Scaxlibur/CycleScope/tool-of-rei/screenshots/README.md

# 截图与相机调试材料

本目录保存历史 UI 调试素材，不是最终显示验收的主证据。像素文件和相机帧保持本机忽略；本 README 用于说明它们的用途和边界。

| 材料 | 用途 | 状态 |
|---|---|---|
| 20260731T151504Z-seq00000001-boot-stale/ | LVGL 截图调试，包含 RGB565、PNG 和 metadata。 | 历史 stale 诊断。 |
| 20260731T151556Z-seq00000002-repeat/ | 同一调试路径的重复截图。 | 历史重复采集；PNG 与上一张哈希相同，不能当成两次独立视觉通过。 |
| camera/20260731T154429Z-camera-raw.png | 相机采集的可读帧。 | 辅助调试材料，不替代 panel flush 计时。 |
| camera/20260731T154353Z-camera-raw.png | 0 字节文件。 | 失败产物，保留以解释采集历史，不得展示为证据。 |

如需新增截图，必须额外记录固件身份、采集方式、原始像素哈希和时间；若用于验收，还应包含从按键事件到真实 panel flush 的端到端取证。仅有 TCP 截图或相机静帧不足以证明该时序。
