Scaxlibur/CycleScope/docs/验收证据索引.md

# CycleScope 验收证据索引

> 更新：2026-08-02
> 作用：为合并、答辩和后续复现提供一份可追溯目录；不复制或改写任何已哈希的原始证据。

> FPGA 原始档案已原样复制到当前仓库根的 `tool-of-rei/evidence/` 和 `source_data_for_test/` 忽略归档区；完成合并后，旧 `CycleScope-FPGA` 工作树已按用户授权移除。FPGA 专用入口见 [FPGA验收证据索引.md](FPGA验收证据索引.md)。

## 1. 使用规则

1. 本文件和 [测试与证据索引.md](测试与证据索引.md) 是受版本控制的导航入口；原始 `pcap`、`npy`、S16 帧、仪器导出和构建二进制留在 `tool-of-rei/evidence/` 的忽略档案中。
2. 已完成的证据根不能改名、移动或编辑；需要补充说明时，只在本索引、根 README 或新的独立包中增加材料。
3. 每次离线备份必须保留目录层级、根 `SHA256SUMS` 和本索引。进入一个证据根后执行 `sha256sum -c SHA256SUMS`；没有清单的历史包只能作为辅助材料。
4. “PASS”只表示该包声明并通过的范围，不自动覆盖另一校准身份或未复验的源码。FPGA 的唯一最终基线为 `fpga-v1.0.0@038e981`。

## 2. 当前正式主证据

| 证据根 | 范围与结论 | 首选入口 |
|---|---|---|
| `final-calibration-20260801_145546+0800/` | M2/M3/M4/M6 的真实前端校准；`fit-v2` 和独立 `holdout-v2` 冻结 P4 频响资产。身份为 `25030/516/-6761/Profile1/4.0625 MS/s/8192`，7 点 holdout 通过，最大幅值/频率误差为 `0.320542 mV / 234.985 Hz`。 | `fit-v2/calibration-build-manifest.json`、`holdout-v2/holdout-report.json`、`p4-asset-v2/p4-asset-manifest.json`、`SHA256SUMS` |
| `final-p4-release-audit-20260801_190121+0800/` | 最终 M8/M9 合并审计，`pass=true`、20/20。审计绑定 P4 频响 profile `C5DCDE41`，并对 M8 严格复分析、干扰对和 WDT A/B 作汇总。 | `combined-audit.json`、`SHA256SUMS` |
| `final-p4-m8m9-fixed-20260801_184849+0800/` | 审计所引用的 11 例基础/边界实机原始包，含 source restore、WaveBench、P4 与镜像数据。 | `campaign-summary.json`、`campaign-manifest.json`、`SHA256SUMS` |
| `final-p4-wdt-recheck-20260801_184750+0800/` | 三谱线计算让出 CPU 后的实机复查；被最终审计引用。 | `campaign-summary.json`、`SHA256SUMS` |
| `m12-final-completion-audit.json` | DG4202 → FPGA → LAN → P4 的真实输入矩阵与其引用的掩码、阶次、相位、`u_a/u_b`、干扰和镜像子包。总审计通过，但必须连同所引用的 `m12-live-*` 目录一起备份。 | `m12-final-completion-audit.json` 及其引用的子包 |

上述 P4 最终审计的应用 BIN 为 `d819641d…d8207007`。它是“完整 20 例”的正式构建身份；不要把它与后续只修改 F0 显示格式的构建混写。

## 3. 最新 P4 显示构建：独立归档、范围受限

`final-p4-f0-display-20260801_192900+0800/` 保存当前工作树 F0 两位小数显示构建：

- ELF：`e23e0ca9…a416d946`；BIN：`e30d16c4…a4bac0e`；应用大小 `1,134,960` byte；
- 启动日志确认 ESP32-P4 rev1.0、360 MHz、P4 response `ON/C5DCDE41`、`.3 → .2` 会话、首帧与 100 帧运行；
- 它证明的是该显示构建的构建身份和板上启动/链路烟测，**不替代**上一节 BIN 的 20 例完整审计；
- 合并当前源码后，若要将它提升为最终发布身份，必须在该提交上重建并完成至少同等范围的审计，或在发布说明中明确保留“20例审计绑定旧 BIN”的边界。

## 4. FPGA 侧正式证据（本地归档）

FPGA 原始档案在 `tool-of-rei/evidence/`，详细说明见本仓的 [FPGA 验收证据索引](FPGA验收证据索引.md)。

| 证据根 | 已验证范围 | 使用边界 |
|---|---|---|
| `m8-lan-longrun-20260731` | 10,001 帧真实 ADC LAN 长稳、UDP checksum、零 IP 分片。 | 固定 8192 点 LAN 基线。 |
| `m10-lan-selftest-20260731` | 正式 bit/ELF 身份、时序、DMA、故障注入和真实 ADC LAN 基线。 | 基础采集/发送证据。 |
| `m11-real-frontend-20260731` | 真实前端、动态范围、校准、FIR 阻带、多音、组合、上限和 J 长稳。 | 原始证据约 763 MB；M11 的旧 `calibration-v1` 是历史链，不等同于 P4 的最终 `fit-v2` 资产。 |
| `m12-dual-destination-20260801` | 主链优先的双目的地 UDP，100/1,000 帧镜像逐字节一致。 | 电脑镜像只是被动观察，P4仍是唯一控制端。 |
| `m14-qspi-persistent-20260801` | `fpga-v1.0.0@038e981` 的 PS+PL QSPI 冷启动。 | 唯一最终 FPGA 基线的掉电恢复证据；固定 8192 点。 |

## 5. 历史、诊断与负例

这些材料必须保留，因为它们解释了失败、复测和安全边界；但不作为最终 PASS 根：

| 目录/类别 | 原因 |
|---|---|
| `final-p4-release-audit-20260801_185829+0800` | 只有 `INCOMPLETE.txt`，是非 UTF-8 UART 前缀导致的未完成审计。 |
| `final-p4-m8m9-edge-20260801_183431+0800` | 500 kHz 修复前的边界/负例，`expected_case_count` 不足，不可替代固定版。 |
| `adc-reconnect-*`、`adc-direct-wire-*`、`m7-adc-calibration`、`m9-spi-preflight` | 位序、恢复、历史标定与已退出的 SPI 诊断材料。 |
| `final-calibration/.../failed-attempts`、M11 失败点 | 不能删除或“用 PASS 覆盖”；它们是安全停机、命名/工具问题和拟合排除范围的事实记录。 |

## 6. 数据类型、内容与备份

| 类型 | 常见内容 | 处理原则 |
|---|---|---|
| `pcap`、`tcpdump.log` | UDP checksum、分片、网卡丢包和时间序 | 原样保留，不能用摘要代替。 |
| `*.npy`、`*.s16le`、帧 JSON | 示波器原始波形、FPGA码序列、P4重组帧 | 原样保留；只读重分析，禁止重采后覆盖。 |
| `summary.json`、`manifest.json`、`report.json` | 结论、输入、版本、SHA和门限 | 作为快速审查入口；与同根 `SHA256SUMS` 一起备份。 |
| `.bit/.xsa/.elf/.bin` | 可下载构建产物 | 必须附提交身份和 SHA；FPGA 正式产物只认 `fpga-v1.0.0@038e981` 及其 M14 固化链。 |
| 仪器命令/状态日志 | DG4202、RTM2032、DP832、JTAG 安全与恢复 | 原样保留，尤其是失败/输出 OFF 记录。 |

当前 `tool-of-rei/evidence` 与 `source_data_for_test` 均由 `.gitignore` 排除。后者在 2026-08-02 手动删除后已按 124 份 `packet_archive` 记录精确恢复：124/124 manifest、124/124 `wire.pcap` 和 620 条 SHA256SUMS 均已复核通过。不要在清理磁盘时删除 `source_data` 与点级 `evidence` 中看似重复的原始数据，它们服务不同的可追溯链。

## 7. 当前维护检查

1. P4：F0 显示版记录绑定 `3f9ec4d-dirty` 构建身份和 BIN `e30d16c4…a4bac0e`；它仍只证明构建、烧录与 100 帧烟测。当前 main 不得因源码已合并就被反向宣称为该 BIN，或被宣称已重跑 20 例审计。
2. FPGA：正式基线仍为 `fpga-v1.0.0@038e981`；M8/M10/M11/M12/M14 的根清单、原始数据与 QSPI 证据必须原位保留，不能用后续实验构建替代。
3. 文档：普通说明和轻量证据摘要均已迁入 `docs/`；新增说明应链接 `docs/测试与证据索引.md`，不得复制或改写已清单化的证据文件。
4. 维护完成后运行 `git diff --check` 和文档链接检查；原始包完整性继续以各自 SHA256SUMS 为准。
