Scaxlibur/CycleScope/tool-of-rei/项目快照.md

# 项目快照

## 恢复卡片
- 当前 worktree：`/home/feisibo/git-projects/CycleScope`
- 当前分支：`main`
- 当前版本边界：`v1.1.0` 仍是上一冻结点；提交 `7e23060` 已冻结 P4 连接状态卡、最终系统标定/P4补偿和 F0 显示改动。FPGA 唯一最终基线固定为 `fpga-v1.0.0@038e981`；两侧历史源码、构建物和原始包均按证据边界保留，既有 `v1.0.0@61eb0dc` 与该 FPGA tag 均不移动。
- 当前目标：布局已收口，保持 main 可交接；不再扩展功能或重做硬件测试。
- 当前状态：main 已位于项目根目录；`973eb9d` 先合并根目录 `public/`、`final_doc/` 并修正当前工具路径，随后按用户授权移除三个旧工作树。普通交接文档和轻量证据摘要现已从旧 `public/` 统一迁至 `docs/`，原始证据仍留在本机/外部归档。外部 WaveBench 保留在 `tools/`，PL/PS 与受支持夹具入口已按该布局更新，FPGA 构建/JTAG 守卫只接受 `main`。原根目录的 `public/`、`final_doc/` 原样备份在被 Git 忽略的 `tool-of-rei/root-layout-source-20260802/`。`codex/FPGA@038e981` 已于 merge commit `124b783` 合入 main，`fpga-v1.0.0@038e981` 保持不动。
- 回放归档状态：`source_data_for_test/` 的手动删除已恢复。以 M11 原始 evidence 的 124 份 `packet_archive` 记录为哈希事实源，精确复原全部点级 `manifest.json`、`wire.pcap`、LAN/pcap 报告与 `SHA256SUMS`；`124/124` 历史 manifest SHA-256、`124/124` 原始 pcap SHA-256、`620/620` 清单项均通过，恢复载荷为 `264,635,620 B`。代表性单音、谐波和 10,001 帧长稳包的 `--inspect-only` 解析通过，未发生网络发送或硬件 I/O。
- 下一步：保持 main 可交接；若要提交本次整理或建立新 release tag，先由用户确认发布口径。
- 最近验证：`docs/evidence/` 中 16 个迁移前已有叶文件与迁移前 SHA256 一致；F0 构建烧录证明目录内 `SHA256SUMS` 4/4 通过；75 个 Markdown 相对链接复扫通过。唯一未修的是厂商网页转存的既存脚注伪链接 `[2](1, 2)`，与本次迁移无关。
- 板上当前固件：正式 FPGA `.2` 镜像全过程未修改；ESP32-P4为 `.3→.2`、`-O2`、performance monitor/diagnostic/DISABLE_PUSH/local test均关闭的F0两位小数正式镜像。size `0x115170`，ELF/BIN SHA256 `e23e0ca90f54507bdffcc0daafefbe4fc84e9dabc9fb98d3151a1746a416d946` / `e30d16c4f207c5f1049ae5ab7be2c0135ac5694764dac84d04f22a0baa4bac0e`；三段烧录均通过esptool写后哈希校验，UART确认 `p4_response=ON profile=C5DCDE41`
- 当前测试源：本轮未操作DG/RTM/DP800；不得在未建立新的受控采集窗口时改变仪器状态
- 当前标定证据：M2/M3/M4/M6 根为 `tool-of-rei/evidence/final-calibration-20260801_145546+0800/`；最终合并审计根为 `tool-of-rei/evidence/final-p4-release-audit-20260801_190121+0800/`。`combined-audit.json` SHA256 `abe9ce8c…1a7d`，根清单SHA256 `9e03b4ef…ae18`
- 不要碰：板上镜像、DP800任何写入、DG/RTM阻抗、赛题原始资料、ESP-IDF 安装目录，以及 `tool-of-rei/evidence/`、`source_data_for_test/` 中受 SHA256SUMS 约束的归档
- 最近一次更新时间：2026-08-02（Asia/Shanghai）

## 合并收口导航（2026-08-02）

- 总入口：[README.md](../README.md)；面向交接的文档入口：[docs/项目交接资料索引.md](../docs/项目交接资料索引.md)。
- FPGA 发布身份：仅 `fpga-v1.0.0@038e981`；其 M14 QSPI 冷启动、M8/M10/M11/M12 证据入口见 [FPGA验收证据索引](../docs/FPGA验收证据索引.md)。
- 测量、运行、镜像和回放数据的正式性边界：[docs/测试与证据索引.md](../docs/测试与证据索引.md)；可提交摘要：[docs/evidence/README.md](../docs/evidence/README.md)。
- 原始档案、历史负例和根清单：[evidence/README.md](evidence/README.md)。大体积原始包继续在本机/外部归档，不随普通 Git 合并。
- 夹具操作边界与安全入口：[test/README.md](test/README.md)。源码会随本次合并版本化，运行缓存不会。
- 当前 F0 显示镜像为 e30d16c4…a4bac0e，只完成格式回归、fresh build、烧录哈希校验和真实 FPGA 100 帧烟测；完整 M8/M9 20 例审计仍绑定 d819641d…d8207007。不得混写两个构建身份。
- 本轮整理验证：轻量摘要均与原始归档逐字节一致，F0 摘要 SHA 清单与 JSON 通过；五个 C++ 主机回归和三个 Python self-test 通过。final_calibration 的 Python unittest 未运行到用例，当前环境缺少 numpy；这只是测试环境前置条件，未改源码或仪器状态。
- M11源码被原样迁到 `test/fpga-m11/`，但它仍是历史归档：原分支/目录守卫、私有 WaveBench 配置和 SHA `9ef0a784…39370070` 的历史测量方案均不能由当前 main 替代。2026-08-02 在 WaveBench venv 的重验只确认缺失前置条件时安全 fail-closed；不将该结果写成原始 M11 evidence 的失败。

## 回放归档恢复（2026-08-02）

- 用户手动删除 `source_data_for_test/` 后，未发现可直接复用的副本；原始点证据和带目标 SHA 的 `packet_archive` 记录仍完整。
- 每份 archive 的动态 `created_at` 位于 `pcap-analysis.json` 时间戳与 LAN 完成时间之间。恢复过程仅在该时间窗枚举，成功逐字节匹配 124 份历史 `manifest.json` 的记录 SHA-256；这不是重生成新 manifest，也没有改写 evidence。
- 随后由原 evidence 以大小与 SHA-256 复制四个输入文件，写回对应原始 manifest 与清单。独立复核为 124 个归档根、124 份 wire pcap、620 条 SHA256SUMS，且每份 LAN/pcap 接受门均为 PASS。
- 典型离线解析：10 kHz 单音为 23 帧/276 WAVE 包；高谐波为 65 帧/780 包；J 长稳为 10,001 帧/120,012 包。均显式 `network_replay=NOT_RUN`。

## F0 显示精度收口（2026-08-01）

- `MEASUREMENTS` 卡片的F0改用专用格式函数，显示从 `23,456Hz` 提升为 `23,456.78Hz`；NaN、Inf、负值和缓冲区不足继续fail-closed为 `--`。
- 频谱图下方谱线频率仍调用原整数Hz格式；FFT输出、补偿、门禁和测量语义均未改动。为容纳最宽正式值 `500,000.00Hz`，仅把F0标签的卡片内可用宽度扩到114 px，字体和卡片尺寸不变，并加入LVGL文字宽度契约。
- 主机格式测试、66例G参数回归与 `git diff --check` PASS。首次构建误读工作区残留的测试 `sdkconfig` 而指向 `.5`，启动复核立即发现，未作为正式结果；随后用独立 `/tmp` sdkconfig从defaults fresh生成正式 `.2` 配置，并把工作区本地sdkconfig恢复为 `.2`。
- 最终构建位于 `/tmp/cyclescope-p4-f0-hundredths-formal-build`，空本地测试CMake、诊断/DISABLE/performance monitor关闭，size `0x115170`。三段烧录均通过esptool哈希校验；启动日志 `/tmp/cyclescope-p4-f0-hundredths-formal-startup.log` SHA256 `e7b8c21d…cfd9`，确认ELF `e23e0ca9…d946`、`.3:50001→.2:50000`、session `0AB15408`、首帧LIVE与completed=100，无panic/WDT/assert。本轮未提交，未操作FPGA或仪器。

## 最终系统标定 M8～M9 收口（2026-08-01）

- 首轮9个M8逐频/保留点通过；500 kHz端点暴露频率精修偶尔得到 `500000.03 Hz` 后绕过补偿的边界跳变。P4现只在既有半bin合法容差内把补偿查询频率钳位到10/500 kHz，显示频率仍保留实测值，真正带外仍不补偿。修复后500 kHz H2为 `500000.03 Hz / 50.285 mVpk`，案例PASS。
- 首次M9三谱线持续流暴露 Core 1 的 `IDLE1` task watchdog：FFT计时未包含后续1P/3P重构，分析任务可连续占满一帧。每次成功取得三缓冲帧后新增固定2 ms协作阻塞；同一250 mVpp三谱线单例复测及随后11例完整续跑均无WDT/panic，latest-wins与发布前新鲜度门禁不变。
- 最终20例由首轮9个M8与续跑的500 kHz端点+10个M9组成，全部通过新版逐UART记录门槛。最大F0/Vpp/RMS/谱线频率/谱线幅值误差为 `0.08 Hz / 1.983 mV / 0.554 mV / 0.25 Hz / 0.805 mVpk`。
- `u_b + 1 MHz / 200 mVpp` 的DG实际总包络为 `265.080892 mVpp`，低于用户实测 `380 mVpp`不失真边界；干扰前后F0/Vpp/RMS/线频/线幅变化仅 `0 / 0.0385 mV / 0.0095 mV / 0.015 Hz / 0.023 mVpk`，带外1 MHz不套补偿表。
- 最终应用镜像size `0x114e10`，BIN/读回SHA256均为 `d819641d…7007`；peer `.2`、本地测试CMake为空、LVGL performance monitor关闭。DG最终回读 `SIN / 100 kHz / 50 mVpp / 50 Ω / 0 V / OFF`，DP800写入0，FPGA改动0。
- 合并审计根 `final-p4-release-audit-20260801_190121+0800` 绑定首轮、续跑、看门狗失败/修复A/B、旧9例严格重审、构建产物和Flash读回；20/20 PASS。早先 `final-p4-release-audit-20260801_185829+0800` 因审计器读取UART原始非UTF-8前缀时退出，已放置 `INCOMPLETE.txt`，没有 `combined-audit.json/SHA256SUMS`，不得作为有效根。

## 最终系统标定 M2/M3/M4/M6 当前边界（2026-08-01）

- 用户后续明确决定忽略所有压缩点，因为模拟余量与实际使用都不会覆盖该峰峰值。追加式 `scope-amendment-v2/` 将正式上限冻结为 `250 mVpp`，活动目录由47点修订为44点：M2/M3/M4/M6=`4/24/9/7`。三个450 mVpp案例被标为 `HISTORICAL_ONLY_EXCLUDED_FROM_FIT_VALIDATION_ACCEPTANCE`；10 kHz保留实测压缩证据，200/500 kHz保留未执行事实。原 `campaign-stop.json` 及根清单不删除、不改写，只是其旧47点范围门禁被用户的新范围决定取代。
- `fit-v2/` 仅读取24个M3点和9个非压缩M4点，响应锚点与 `m3-draft-v1` 逐字节一致；保留幅度点最大偏差 `0.510197%`。identity SHA `c5dcde41…3945`，profile ID `0xC5DCDE41`，response SHA `9d1aace3…1c5f`；fit清单SHA `c3dab058…147e`。
- 冻结fit后才执行7个M6保留点。现场RTM CH1未接入，因此M6按正式DG4202 50 Ω设定为真值，只同步采RTM CH2与64帧FPGA数据；分析明确记录 `scope_channels=[2] / rtm_ch1_used=false`。7点全部通过，未重拟合，最大幅度误差 `0.320542 mV`、最大频率误差 `234.985 Hz`，同时满足3 mV/500 Hz工程目标和5 mV/1 kHz硬门槛；holdout清单SHA `094166c6…6aee`。
- 两次无效尝试均追加归档：第一次在上电前发现DG已由人工置ON；第二次因旧夹具仍要求未接入的RTM CH1而得到0点。两者均保留失败组、命令、镜像/截图与SHA，且DG分别安全关闭并恢复。夹具现仅对M6使用CH2，M2～M4历史双通道证据不重写。
- `p4-asset-v2/` 生成12锚点只读头，资产清单SHA `670e0c9b…6c44`；`main.cpp` 显式把profile传入pipeline。补偿插值、FFT补偿、66例G参数、格式、新鲜度及14项Python测试PASS。fresh构建 `/tmp/cyclescope-p4-final-calibrated-build` size `0x114d90`，ELF/BIN SHA `b4927305…591b / 5b4ec8a5…6b23`；只烧录ESP32-P4三段，app全量读回逐字节一致。UART `/tmp/cyclescope-p4-final-calibrated-uart.log` SHA `7a9604f8…448c`，确认 `.3→.2` session和 `p4_response=ON profile=C5DCDE41`。DG为OFF时零信号帧 `valid=0 lines=0` 属预期门禁，不冒充有效测量。
- 正式上游身份冻结为 `calibration_id=25030 / scale=516 µV/code / offset=-6761 µV / Profile 1 / 4.0625 MS/s / 8192点`。电脑只被动接收 FPGA `.2→.4:50002` 镜像，预检及正式采集均记录 `network_writes=0`；DP832A只执行过一次只读状态查询，FPGA全过程未修改。
- M2零输入128帧的码均值中位数为 `13.78546 code`，AC噪声 `0.41050 code RMS`。100 kHz的20/50/100 mVpp门禁均PASS；CH1节点约为DG设置值两倍，但按用户冻结口径，正式幅值参考仍是DG 50 Ω设置值。
- M3的12个频率为 `10/10.5/20/50/100/200/300/400/450/475/490/500 kHz`，升降频共24点全部PASS；最大方向差约 `0.0092%`。端到端 `Sset(f)` 约从 `261.41 µV/code @ 10 kHz` 变化到 `265.27 µV/code @ 500 kHz`。
- M4的10 mVpp弱线3点、50 mVpp交叉3点及250 mVpp交叉3点均完成。250 mVpp时CH2基波约 `2.283～2.309 Vpp`、原始极值约 `2.34～2.38 Vpp`；`2.35 Vpp`是工程警告，`>2.5 Vpp`仍是立即OFF硬失败。
- 旧47点计划中，450 mVpp三点按100 mVpp实测比例预测CH2为 `4.212/4.140/4.140 Vpp`，安全审计最初均拒绝上电。用户随后单独授权10 kHz点并实测确认压缩；200/500 kHz未执行。v2正式范围已将三者整体排除，详见 `scope-amendment-v2/`，不能再把它们当作待补测活动案例。
- 低幅复核 `diagnostic-input-load-100000Hz-020mVpp-20260801_155427+0800` 得到 `Ksrc=1.983107`，预测450 mVpp时CH2为 `4.143532 Vpp`，再次确认输入端尚未恢复预期50 Ω。18个证据文件SHA全验，WaveBench原始NPY/CSV/JSON/commands/screenshot齐全，镜像 `network_writes=0`，结束后DG恢复正式OFF状态。
- M3草表位于 `m3-draft-v1/`，仅读取24个M3点并声明 `m4_paths_read=false / holdout_paths_read=false`；四个产物SHA验证PASS，最大升降频差 `0.009190%`。
- P4通用逐频线性插值、无外推、六字段身份门禁、实时profile传递、校正谱线/RMS/Vpp/频谱及校正后1P/3P均已接入；动态帧和UART/UI日志明确输出本地profile ID。早期框架构建未嵌入profile；当前正式构建已更新为上方 `0xC5DCDE41` 标定镜像。
- `generate_p4_asset.py` 只有在fit SHA完整、M6 hard gate PASS、未重拟合且三处profile ID一致时才生成确定性C++资产；失败holdout负例已验证拒绝。当前 `p4-asset-v2` 已通过该门禁并安装到正式P4源码。
- 用户在已知 `Ksrc≈1.984`、CH2预测约4.14 Vpp后明确授权450 mVpp测试；夹具把原2.5 Vpp线仅对三个精确450 mVpp用例提升为4.6 Vpp紧急OFF线，其他用例仍默认2.5 Vpp fail-closed。`10 kHz / 450 mVpp` 实测CH1基波 `0.9056 Vpp`、CH2基波 `4.0271 Vpp`；M3→450 mVpp的 `Ksrc/Gamp/Kadc/Ke2e` 变化分别为 `+1.0502%/-3.8430%/-0.2976%/-3.1224%`，模拟前级压缩占主导。
- `campaign-stop.json` 冻结的是旧47点范围在当时的强制停止事实：WaveBench CH2 THD `4.3695%`、FPGA拟合THD中位数 `4.4578%`；200/500 kHz未执行，且该审计创建时M5/M6不存在。其点/组/恢复SHA为 `94989065…6ec / 4b894698…29c / 00d7b9c1…a86`；v2没有篡改这些历史事实，只收窄了后续正式范围。
- `m4-failure-diagnosis-v1/` 对50/100/250/450 mVpp同频切片做分层归因：`Gamp`下降 `3.8430%` 是主因，`Kadc`仅下降 `0.2976%`；若把输入端恢复为 `Ksrc=1`并暂按M3线性增益投影，450 mVpp时CH2约 `2.0800 Vpp`、FPGA约 `432 code peak`。该预测明确标记为必须重测，不是PASS证据。诊断目录SHA为 `ba653cc7…63cf`，更新后的全证据根 `SHA256SUMS` 为 `c1698923…710e`。

## FPGA 连接状态卡（2026-08-01）

- `MEASUREMENTS` 下方原 `ACTIVE VIEW` 信息与顶部 `MODE` 重复，现改为 `FPGA CONNECTION`。稳定状态为：未建立 CSLP session 时红色 `NO FPGA LINK / CSLP SESSION NOT ESTABLISHED`；session 在线但无新鲜有效帧时橙色 `NO VALID DATA`；自上次有效帧后 pipeline 的 invalid 计数增长时橙色 `DATA REJECTED / OUTSIDE CAPTURE RULES`；成功应用 current 有效帧时绿色 `NORMAL / LAN + VALID FRAME OK`。启动首秒保留灰色 `CHECKING`，避免把约 3.5 秒 PHY 冷启动误报为立即失败。
- 状态卡复用既有 `1000 ms` 新鲜度事实源，不改变 CSLP、FFT、采集门限、旧数据 STALE 锁存或顶部 SOURCE/footer。拒绝态只在正式分析链确有 invalid 增量时出现；FFT 执行失败不会被冒充为“输入不合格”，session 在线但没有拒绝证据时显示更谨慎的 `NO VALID DATA`，不把静默发送端诬称为输入不合格。
- `tool-of-rei/test/live_stream_freshness_host_test.cpp` 扩展到 15 例并 PASS；Display-only 夹具增加 `CHECKING → NO VALID DATA → NORMAL → DATA REJECTED → NO FPGA LINK → NO VALID DATA → NORMAL` 标签契约并成功编译。正式 fresh build 位于 `/tmp/cyclescope-p4-connection-status-formal-build`，配置审计确认 `.2`、空 local CMake、无测试 compile command、perf monitor/diagnostic/DISABLE_PUSH off。
- 正式三段镜像已写入 `/dev/ttyUSB1` 且 esptool 写后校验 PASS。UART `/tmp/cyclescope-p4-connection-status-formal-uart.log` SHA256 `bd36588aef252f60a8a7589f4a46d2c993d67f2f5c3c674a23e679048336097b`：UI/FFT 门禁正常，IP101 于约 `4.217 s` 明确 `Link Up`，P4 `.3:50001→.2:50000` 正确；但 10 秒内 FPGA 未回应任何 HELLO，故卡片应为 `NO FPGA LINK`。本轮没有 FPGA session，不能声称 `DATA REJECTED` 或 `NORMAL` 已实机显示。

## M12 DG→FPGA/LAN→P4 全矩阵验收（2026-08-01）

- 用户明确把本轮口径收窄为 DG 设置理论值→FPGA/LAN 帧→ESP32-P4 FFT/时域投影；未把 CH1/CH2、AD8065 增益、Cjudge、981 点扫频或示波器原始极值 Vpp 作为门槛。DG4202 当前 WaveBench 公共 HARM/USER 接口不能安全、可审计地表达 H6～H16 的逐项幅相，故采用已审计的 ARB 路径，不发送裸 SCPI；所有 source 切换均为 OFF→上传→短时 ON→OFF，且保持 50 Ω、0 V offset。
- FPGA 诊断构建同步向 P4 `.3:50001` 和电脑 `.4:50002` 发送同一 CSLP 应用载荷；电脑只被动绑定 UDP 50002，`network_writes=0`。每个 live case 保存 UART、完整镜像帧、manifest、DG profile/ON/OFF 回读、ARB payload 与 P4 验收 JSON；每例至少 214 个 source-ON 完整帧，CRC、12 分片、8192 点几何和来源均通过。
- 实测矩阵为：MASK H2～H16 15 例；同一 400 kHz 作为 H2～H16 15 例；H2/H3 相位 `4×4` 16 例；`UA-CREST-LOW/HIGH`、`UA-BASE-WEAK`、`UB-LOW/HIGH/H16/WEAK` 7 例；`J-H10-1M`、`J-H16-1M6`、`J-H16-2M` 与三个无干扰基线 6 例。另保留 `M12-H1H3H5-66K7-TARGET` 基准，总共 60 份 P4 验收报告，计划 59 例无缺失。
- `m12-final-completion-audit.json` PASS：全矩阵最大 P4 F0/Vpp/RMS/谱线频率/谱线峰值绝对误差为 `0.180 Hz / 3.727 mV / 0.967 mV / 0.625 Hz / 1.082 mV`，均低于 `1 kHz / 5 mV`。400 kHz 跨阶次强线幅值极差 `0.297 mV`；相位矩阵谱线峰值最大跨相位漂移 `0.095 mV`，P4 Vpp 随理论相位由约 `96.388` 到 `126.139 mV` 变化。每例 P4 原始 3P 包络均与同 FFT 幅相模型一致：最大 Vpp 差 `0.497 mV`、残差 `0.210 mVrms / 0.599 mVpeak`。
- `u_J` 用例的 manifest 将 H10/H16 干扰作为 source-only tone，P4 只分析滤后的 `u_b` 三线及其重构 Vpp/RMS。相对无干扰基线，最大 P4 漂移为 F0 `0.015 Hz`、Vpp `0.096 mV`、RMS `0.039 mV`、谱线峰值 `0.057 mVpk`；没有把 1/1.6/2 MHz 干扰纳入目标谱线。
- 主审计：`tool-of-rei/evidence/m12-final-completion-audit.json`；原始批次目录为 `m12-live-mask-h2-h16-20260801_110003/`、`m12-live-order-400k-20260801_110558/`、`m12-live-order-400k-resume-20260801_110718/`、`m12-live-phase-20260801_111318/`、`m12-live-ua-ub-20260801_111910/`、`m12-live-ub-plus-interference-20260801_112220/`。夹具固定在 `tool-of-rei/test/m12_*`；本轮未修改产品源码、FPGA worktree 或 FPGA 配置，也未操作 DP800。结束后 DG 已回读为 `SIN / 100 kHz / 50 mVpp / 50 Ω / OFF`。

## v1.1.0 发布边界（2026-08-01）

- `v1.1.0` 是 ESP32-P4 正式显示层的向后兼容功能版本：在 `v1.0.0` 基础上包含最多 8 条谱线与动态横轴、Vpp/RMS/F0/谱线的 `mV/Hz` 格式、按当前可见谱线计算的 80% 动态纵轴和 `mV/div`，以及关闭 LVGL FPS/CPU 生产叠层。
- FFT、CSLP、G 题判定门限、分析侧量程迟滞、正式 `.3→.2` 网络配置和 FPGA 发送协议均未改变；因此采用 minor 版本 `v1.1.0`，不改写首版标签，也不复用 FPGA 专用标签命名空间。
- 发布验证沿用下列各节的可复核证据：measurement format 与频谱投影 ASan/UBSan、66 例 G 参数扫、正式/Display-only ESP-IDF 6.0.2 构建、动态 `3→8→7` 控件板测、正式镜像烧录与真实 FPGA 会话。标签只在本地创建，除非用户另行要求，不推送远端。

## LVGL 性能调试叠层移除（2026-08-01）

- 右下角内容的根因是 `sdkconfig.defaults` 显式启用 `CONFIG_LV_USE_PERF_MONITOR=y`；LVGL Kconfig 将其定义为 “Show CPU usage and FPS count”，默认位置正是 `BOTTOM_RIGHT`。它不是 CycleScope 的 footer，也不是 FPGA/FFT 数据。
- 正式 defaults 现固定 `CONFIG_LV_USE_PERF_MONITOR=n`，本工作树 ignored 的本地 `ESP32-P4/sdkconfig` 也已同步关闭，避免以后直接增量构建时把叠层带回；仅保留 `LV_USE_SYSMON` 供非叠层诊断能力使用。CycleScope 自有 footer 左侧 LIVE/STALE、右侧 `ESP-DSP  •  FFT 8192` 均保持不变。
- fresh 正式配置 `/tmp/cyclescope-p4-no-perf-overlay-formal-sdkconfig` 生成 `# CONFIG_LV_USE_PERF_MONITOR is not set`；ELF 中不存在 `lv_sysmon_show_performance`、hide/dump 或 perf-monitor 符号，compile commands 无测试夹具。主机 measurement format、频谱投影 ASan/UBSan、66 例 G 参数扫与 `git diff --check` 均 PASS。
- 正式构建 `/tmp/cyclescope-p4-no-perf-overlay-formal-build` size `0x113990`，较上一正式镜像减少 `0x7a0` 字节。三段烧录均完成写后哈希校验，板上现为该无叠层正式镜像。
- UART `/tmp/cyclescope-p4-no-perf-overlay-formal-uart.log` SHA256 `c30a97e787ebba2c44d2c03645156875d8587e7bb7d399d3c10f56a4bde92683`：UI shell、普通/弱基波 FFT 启动门禁、IP101 和 `.3→.2` session `E1841489` 均正常，receiver 完成 400 帧，无 panic/WDT/assert。当前 400 帧均为 `valid=0 lines=0`，表明当时输入无可分析谱线；此项只证明关闭叠层后正式链仍运行，不宣称实时测量值通过。

## 频谱动态纵轴与 mV/div（2026-08-01）

- `SpectrumView` 在收到新帧或 `−/+` 改变可见条数时，只扫描当前前 N 条语义谱线，令 UI 纵轴上限为 `max_visible_peak / 0.80`；五个纵向分格因此为 `max_visible_peak / 4`。最高线在连续坐标中精确为 80%，落到 284 像素画布时只有不可避免的整像素量化。
- 动态纵轴只存在于 UI 视窗：`SpectrumDisplayFrame::amplitude_max_volts` 的 `20/50/100/200/300/500 mVpk` 档位、上下切迟滞和 pipeline 提交日志保持不变。新增显式 amplitude-max 的纯映射重载，避免为绘图复制约 6 KiB 的完整频谱帧。
- 频谱图例前置两位小数 `mV/div`，例如真实输入 `P1=69.213mVpk` 时显示 `17.30mV/div`；后续三条仍采用 `Hz + mV`，更多可见谱线继续用 `+N`。最坏文本宽度契约包含 `125.00mV/div`，运行时 UI shell 已证明布局未被拒绝。
- `tool-of-rei/test/spectrum_projection_self_test.cpp` 新增 1/2/3 条可见谱线、80% 像素映射、五格读数、未选谱线隔离及 count/NaN/Inf/溢出 fail-closed；与 measurement format、66 例 G 参数扫一起在 `-Werror + ASan/UBSan` 下 PASS，`git diff --check` PASS。
- fresh 正式构建 `/tmp/cyclescope-p4-spectrum-scale-formal-build` size `0x114130`；Display-only 构建 `/tmp/cyclescope-p4-spectrum-scale-display-build` size `0xdd870`。正式构建审计确认 local test fragment 为空、peer `.2`、`-O2`、diagnostic/DISABLE_PUSH off，compile commands 和 ELF 均无 Display 夹具。
- Display-only UART `/tmp/cyclescope-p4-spectrum-scale-display-uart.log` SHA256 `2329b753f7b1b171dcf41017777c4eb822534517d7516736277ffb24016c1e79`：两轮 controls 均按 `3→4→5→6→7→8→7`，第八条 60 mVpk 进入/退出时 `mV/div` 精确 `11.00→15.00→11.00`；D0～D9、D1/D2、journal/tree/heap/integrity/retry 和最终 `owned=EMPTY` 全部 PASS。
- 测试后已恢复正式三段镜像并写后哈希校验。UART `/tmp/cyclescope-p4-spectrum-scale-formal-uart.log` SHA256 `40b5a35c16f49bbb845146114d215c09457b043be58fa680ef1b927603a3bbd8`：真实 FPGA session `C0664BFE` 从 frame 377133 连续至 400 帧，首帧三线 `69.213/38.988/20.966 mVpk`，UI 输出 `view=17.30mV/div`；无 panic、WDT、assert 或接收/分析错误。

## measurements 与频谱参数格式（2026-08-01）

- 新增无 LVGL 依赖的 `measurement_format.hpp`：伏特仅在 UI 边界转换为两位小数 `mV`；频率按 `floor(f+0.5)` 四舍五入到 1 Hz，并用显式、locale-independent 的千位分隔输出。NaN、Inf、负值和缓冲不足统一 fail-closed 为 `--`。
- TIME/FFT 两种视图在存在实时帧时都从 `DynamicMeasurementFrame` 读取 Vpp/RMS/F0/Fs；这些字段直接复制自 `FftAnalysisResult`。频谱图例从 `SpectrumDisplayFrame::peaks` 读取 FFT 谱线，前三条示例为 `10,000Hz 44.00mV  •  20,000Hz 22.00mV  •  30,000Hz 14.67mV`，更多谱线继续显示 `+N`。
- Vpp、TRUE RMS、F0 的值字体改为 Montserrat 16，单位进入值文本；Fs 保持 22px 与原格式。按 LVGL glyph advance，`500,000Hz` 宽 89px，测量卡内容区由 88px 调为 90px；运行时 text contract 同时锁定 `500.00mV`、`500,000Hz` 和三条最坏图例。
- `tool-of-rei/test/measurement_format_host_test.cpp` 在 `-Werror + ASan/UBSan` 下覆盖 mV 精度、999.5 Hz 进位、23,456 Hz、500 kHz、1 MHz、非法值与小缓冲区，PASS。Display-only 契约已更新精确标签并成功编译；正式 build size `0x113f70`，Display-only build size `0xdd450`。
- 新正式三段镜像在 `/dev/ttyUSB1` 写后哈希校验 PASS。UART `/tmp/cyclescope-p4-measurement-format-formal-uart.log` SHA256 `289ae264ab6d465878325739b83a8147d3b0e82bfebe3ae97645ca3c84dce889`：ELF `29ce3cae0…`、UI shell、普通/exact-weak FFT 门禁均 PASS；`.3 → .2` 于约 4.25 秒建立 session `2FDAC359`，首帧进入 LIVE，15 秒捕获至 200 帧。当前输入 F0 `23450.03 Hz`、Vpp/RMS `545.778/151.812 mV`、6 条显示谱线；无 panic/WDT/assert。UI shell 成功也证明运行时最坏文本宽度契约未拒绝布局，真实面板观感仍由用户确认。

## 频谱 1～8 条与动态视窗（2026-08-01）

- 正式分析仍输出“基波 + 最强两条谐波”用于 Vpp/RMS/F0 和既有日志；另维护显示专用的基波 + 最强七条谐波族谱线，最多 8 条，按频率排序。弱于候选门限或高于 500 kHz 的成分不会为了凑数进入画面；1.5 MHz H15 干扰仍在显示带外。
- `SpectrumView` 默认请求 3 条，`−/+` 在 1～实际检测数之间调节，硬上限 8；边界按钮自动 disabled。横轴覆盖当前前 N 条显示线，采用 10% 对称边距；单线最小 20 kHz 观察窗，并平移/钳位在 0～500 kHz。动态视窗不改动原始 0～500 kHz、640 列频谱元数据，避免破坏列/轴事实源。
- `tool-of-rei/test/g_parameter_sweep_host_test.cpp` 在原 66 例之外增加 9 线输入，证明正式结果仍精确 3 条、显示结果截取 8 条、第 9 条弱线被排除且正式 RMS 不变；`spectrum_projection_self_test.cpp` 覆盖动态窗、单线、0/500 kHz 边界和窗外拒绝。两者在 `-Werror + ASan/UBSan` 下 PASS，`git diff --check` PASS。
- fresh 正式构建 `/tmp/cyclescope-p4-spectrum8-formal-build` 使用 ESP-IDF 6.0.2，size `0x113e00`、app 分区余量 87%。Display-only 镜像执行两轮 `FFT → +至8条 → − → TIME/1P/3P`：轴依次为 `7..43 / 6..54 / 5..65 / 4..76 / 3..87 / 4..76 kHz`，两轮 `controls=PASS`，D0～D9/D1/D2 生命周期矩阵、heap/integrity/retry 和最终 `owned=EMPTY` 均 PASS；无 panic/WDT/assert。UART `/tmp/cyclescope-p4-spectrum8-display-uart.log` SHA256 `e55cc0e9195477449e8a357b0c845e2fec813af1f25c6fe6b7941893e1baeb95`。
- 测试后已把正式三段镜像写回 `/dev/ttyUSB1`，esptool 三段写后哈希校验均通过。正式 UART `/tmp/cyclescope-p4-spectrum8-formal-uart.log` SHA256 `6952b5a64ad30107f2221d1720889d07ce53721be36745068c758ee5f55f0c2a`：普通/exact-weak FFT 门禁 PASS，`.3:50001 → .2:50000` session `5816FF51` ready；真实 H1/H3/H5 输入从 frame 144713 连续至第 600 帧，receiver/pipeline 全部可见错误计数为 0，FFT 平均/最大 `16.923/24.219 ms`。日志不存在 Display-only/fault fixture 字符串，板上当前为正式镜像。
- 提交前对同一运行中 session `5816FF51` 做无复位被动串口复核：累计完成约 154,700 帧，当前 100 kHz 基频只检测到带内 H1/H3/H5 三条，全部接收/分析错误为 0；用户随后调整信号发生器谐波生成参数，人工确认界面可显示并调节至 `8/8`，动态横轴正常。

## LVGL 本地截图调试通道（2026-07-31）

- 产品源码为 `ESP32-P4/main/app/lvgl_screenshot_debug.{hpp,cpp}`；正常 `SRCS` 不包含该 `.cpp`，`main.cpp` 也只在 `CYCLESCOPE_LVGL_SCREENSHOT_DEBUG` 时引用它。忽略的 `tool-of-rei/test/lvgl_screenshot_debug.cmake` 才会把源文件加入 main component，并同时对 main/LVGL 目标定义 `LV_USE_SNAPSHOT=1`。这避免把 TCP 调试能力或 snapshot API 带入正式 `.2`。
- 调试服务固定只允许电脑 `192.168.10.4` 连到 P4 `192.168.10.3:50002`，请求为 `SHOT\\n`；服务在 LVGL adapter 锁内用 caller-owned PSRAM `lv_draw_buf_t` 生成 active-screen RGB565，释放锁后再传输。48-byte 大端帧头带序号、尺寸、stride、LVGL tick 和生成耗时；夹具 `tool-of-rei/test/capture_lvgl_screenshot.py` 写入 PNG、`screen.rgb565le` 与 JSON metadata。截图证明 LVGL 合成像素，不能声称 panel 物理刷新完成。
- 调试镜像 ELF/BIN SHA256 为 `168d834c734e0f4e989bc39c29012f2395b548933c6315375da69811fd2dbb75` / `c1bb22856a6abfd7996fa860d3934579c7e03e8a682c27b1d9ce6aecd35c16eb`，size `0x115050`。启动时约 `4265 ms` 建立 listener、分配 `1228804 B` PSRAM；无 panic/WDT。两次 P4 实抓均为 `1024×600`、stride `2048`、payload `1228800 B`，耗时 `35808/35845 us`，原始 SHA256 均为 `a095077ba6f1f94b152e6b9f280ab1be6a36daa45d8566b37a8e0bc920a1f176`，见 `tool-of-rei/screenshots/20260731T151504Z-seq00000001-boot-stale/` 与 `...151556Z-seq00000002-repeat/`。
- 恢复时以 fresh normal build 显式传入空 `CYCLESCOPE_LOCAL_TEST_CMAKE`；CMake cache、compile commands、ELF 符号和 strings 分别确认 local fragment、debug source/宏、`lv_snapshot_take_to_draw_buf`/`LvglScreenshotDebug` 与 `50002` 均不存在。正式三段烧录写后校验、app 全量 readback、UART（SHA256 `808e577ee50b89e94988a0c8e89b782a436dc6c301ba3daaf571e8e76e742a3f`）均 PASS；主机连接 `50002` 得到 `Connection refused`。

## 正式 `.2` 镜像上板与首次 FPGA 握手（2026-07-31）

- 独立 SDKCONFIG/build 位于 `/tmp/cyclescope-p4-fpga-formal-sdkconfig` 与 `/tmp/cyclescope-p4-fpga-formal-build`；审计确认 P4 为 `192.168.10.3:50001`、peer 为 `192.168.10.2:50000`，本地测试 CMake 片段为空，diagnostic consumer、DISABLE_PUSH、heap trace 和全部 fault fixture 均关闭，编译优化为 `-O2`。主机 freshness 9 边界、模拟器自检和 `git diff --check` 均 PASS。
- bootloader、partition table、app 三段烧录的 esptool 写后校验均通过；从 Flash `0x20000` 全量读回 `0x1132f0` 字节后，SHA256 与正式 BIN 同为 `23ae1c37fab06e99e058b70ab0cd62fb1287dbb7bcec721b78bfa0218dec8119`，`cmp` 逐字节一致。读回后已 hard reset，板上保持该正式 `.2` 镜像。
- 冷启动 UART `/tmp/cyclescope-p4-fpga-formal-smoke-uart.log`（SHA256 `780da7bcbdafa440d2d88e4512d9ba858b367a82105002d4e48bbc6449713901`）显示 P4、PSRAM、显示、普通 FFT、exact weak FFT 和 IP101 全部通过，并明确输出 `UDP 192.168.10.3:50001 -> 192.168.10.2:50000`；45 秒内记录 42 次 HELLO timeout/handshake failed，`CSLP session ready`、measurement 均为 0，且无 panic、WDT、assert、abort 或 socket fatal。
- 同机网络前置检查中 FPGA `.2` 与 P4 `.3` 均 ping 2/2，电脑只保留 `.4`、已撤掉临时 `.5`，UDP 50000/50001 无电脑进程占用。`/tmp/cyclescope-p4-fpga-formal-smoke.pcap`（SHA256 `704e5e5b3234433c01fcfd1b20a306e77e985038120492dc53965c3edd38a4ea`）在电脑交换机端口为 0 包；`.3↔.2` 单播不会经过该端口，因此这份 pcap 不作为“P4 未发包”或握手失败根因的证据。

## 真实 FPGA pcap 重放验证（2026-07-31）

- `source_data_for_test` 共 51 个测量点、约 31 MiB，全部为 FPGA `192.168.10.2:50000 →` 电脑 `192.168.10.4:50001` 的 real-adc 经典 pcap。51/51 份 `SHA256SUMS`、manifest、LAN report 和 pcap analysis 均 PASS；每点 23～65 个完整帧，固定 12 包/帧，IPv4 无分片，UDP checksum 有效，抓包内核丢包为 0。
- 原始 ACK/WAVE 带旧 session/config 且目的为电脑 `.4`，不能直接 `tcpreplay` 给 P4。`tool-of-rei/test/cslp_real_fpga_pcap_replay.py` 默认只离线检查，网络发送要求显式确认，生产 `.2` 还需第二道隔离开关；重放时保留真实 S16_LE 样点、`488 µV/LSB`、offset/calibration 和 FILTERED 语义，只为当前 P4 动态重建握手、session/config、CRC 与安全包间隔。
- 精确单音测试使用 `d-10000Hz-050mVpp`，源 pcap SHA256 `e88a947e5349ca10a80d7e1a261d768375d8c9ba2e38b004f244b74c129efef5`、原 frame 1101～1123、样点 `-35…62`。临时 `.4` 镜像 session `01B1B679` 完成 frame 1～23/276 包；P4 对每帧均报告 `valid=0 lines=1`，这是产品要求至少两根题目谱线的预期门禁，不是接收失败。sender/UART SHA256 为 `c2449b10d7601a41b9c46a1927941151e1df580c471d4dc93f083f5f6f08520f` / `979ed414200a0185d4541883c8f85e7a8c563c492b04a7eebdb3796840147f9f`。
- 为闭环分析/UI，额外将 10 kHz 与 100 kHz 两份 50 mVpp real-adc 捕获逐样点相加，派生数据 SHA256 `e1777613ed03dd8ac1f88654b660c57a09d310f81e36890a5c517cd9580cb2de`、范围 `-71…122`。session `29E84C98` 完成 23 帧，首帧 `F0=10000.02 Hz`、Vpp/RMS `93.517/23.582 mV`，H1/H10 `23.557/23.607 mVpk`，随后 UI bridge、LIVE、frame 23 后 ONLINE STALE 与 peer-silent OFFLINE 均闭环。sender/UART SHA256 为 `ba95bff08d3564cd1dde5f60129a01db38ad767aed94fd4f13adba83d3a035f2` / `a23183de76809556da7bdbfe3438c08e7c8464808592e0ee5f5a229b402afcb2`。该项只证明真实 ADC 样点经过 P4 数字链，不证明 FPGA 同时采集双音、前端互调或真实两板链。
- 临时测试镜像 ELF/BIN SHA256 `4e38f7330ffd4509dfb2addb79c957ff7dfee5b97641577d58b6663ccb8a1af9` / `ed1e0fa9b4d0266e9003341b0619a7cf6e9d8697f3396f9aa577d1c8cd524f87`，与正式 sdkconfig 只有 peer `.2→.4` 一项差异。测试后已重烧正式三段镜像；`/tmp/cyclescope-p4-fpga-formal-app-readback-after-real-pcap.bin` SHA256 与正式 BIN 同为 `23ae1c37fab06e99e058b70ab0cd62fb1287dbb7bcec721b78bfa0218dec8119`，`cmp IDENTICAL`。恢复 UART `/tmp/cyclescope-p4-formal-restored-after-real-pcap-uart.log` SHA256 `3864130756c7979604b37676d7957bddd91265fa5e58355a1a4d331166347356`，再次显示 ELF `c3d6e6853…` 和 `UDP .3:50001 -> .2:50000`。

## 最终数据新鲜度修复与上板闭环（2026-07-31）

- `InstrumentApp` 以最后一次成功 `apply_live_measurement()` 的本地 `lv_tick_get()` 为锚；STATUS、收包、重组、overrange/FIFO、不完整帧以及 FFT/投影拒绝均不能续期。STALE 锁存，transport 重新 online 也不能恢复，只有新的 current 有效帧被应用后才恢复 LIVE；32 位 tick 回绕按无符号减法处理。
- `tool-of-rei/test/live_stream_freshness_host_test.cpp` 在 `-Wall -Wextra -Werror -pedantic + ASan/UBSan` 下 9 个边界 PASS，覆盖首帧等待/缺失、在线过期、掉线、锁存、恢复和 tick 回绕；Display 私有契约 fresh build 也通过，镜像 `0xdc770`、app 分区余量 89%，该夹具镜像未烧录为 normal。
- normal 固件烧录后，session `7BACBD99` 发送 20 帧/240 包并保持 3 秒 STATUS。frame 20 后 `1000 ms` 出现 `LIVE -> STALE; transport=ONLINE reason=NO_VALID_FRAME`；此时 receiver health 为 `completed=acquired=20`，frame/reject/socket 错误全零。发送端退出后才出现 peer-silent，UI 随后改为 `OFFLINE`，旧 frame 20 始终保持 STALE。
- recovery session `7BACC34A` 的 frame 1 先产生有效 measurement，随后才出现 `STALE -> LIVE`；新 session-ready 本身没有解除 STALE。该 session 停止新帧后又在 `1000 ms` 回到 ONLINE STALE，并在 peer-silent 后转为 OFFLINE STALE，证明状态可重复。
- STATUS-only/掉线 UART `/tmp/cyclescope-p4-freshness-online-final2-serial.log` 与 sender SHA256 为 `75a22dd242f9b7094e4061ebc86cb05f43919394ec01e687f629f40185d16eec` / `ef61050cef18f3c109aebc3f35b1a40196ed0c9d8d5c28de8f97e62fa3817561`；恢复 UART `/tmp/cyclescope-p4-freshness-online-recovery-final-serial.log` 与 sender SHA256 为 `ae732c0b76023edbf5563465329af0cbbd95c7e96bad1d98f1866e88b3ca531b` / `dca4f3853efe99dea25c88aa8a88cf2cd98d17f15d23de06f0a243601106d5fe`。前置 source 未监听造成的握手重试在正式 session 外，未冒充数据错误。

## 修复前 normal v5 迟滞、STALE 与板上回归（2026-07-30）

- 频谱量程状态机使用 `20/50/100/200/300/500 mVpk` 档：首帧按 peak×1.20 选档，上切要求 peak×1.15 超过当前档，下切要求更低档仍保留 25% 余量。候选状态绑定 session/config/epoch；只有帧仍 current 且结果队列发布成功后才提交。动态 session `E26255F1` 的前 40 帧在 `83.2/83.5 mVpk` 附近交替而没有额外切档，frame 41 精确 `100→200 UPSHIFT`，frame 61 精确 `200→100 DOWNSHIFT`。
- UI 断链状态不再让旧数据看起来仍在线：首帧前保持 WAITING；有效流从 WAITING→LIVE；peer silent 后保留图形和数值但显示 `SOURCE CSLP OFFLINE • STALE • LAST FRAME N`。新 session ready 本身不能解除 STALE，recovery session `E26255F4` 只有新有效帧到达后才 STALE→LIVE。动态/恢复 UART `/tmp/cyclescope-p4-v5-hysteresis-stale-recovery-serial.log` SHA256 `3c05ee98d2ad2f139bdc55df2645a49fe8688326e91fe21db030c2f1a8add443`；两个 sender SHA256 `be617616…4a48` / `3a68b634…776d`。只读 evidence/adversarial SHA256 `f80367237046e6864ca4ed7fe585ab57934e466ad5b9d2976c93d6de0d3cc7fa` / `ba64d48c394394deea1ccde9e96d9bb1acc1802181af271f800fbd4a1b88a441`，正例 PASS、16 个关键篡改负例全部拒绝，短日志明确不声称周期 health。
- Display-only v8 自动矩阵继续覆盖 D0～D9、journal/tree/heap/integrity、controls 和两轮精确 `WAITING→LIVE→STALE→LIVE`；最大软件回调 `18.827 ms`，故障注入 D1/D2 的 E 日志属于预期夹具事件。UART `/tmp/cyclescope-p4-display-fault-v8-stale-uart.log` SHA256 `d28699abdb00a0b0fc02f19cd95f20191486b32e103d88f5ba18c7c7c34ee6d6`。该证据仍只到软件回调/重绘提交，不冒充真实 panel flush。
- normal v5 正式 10,000 帧命令保持电脑 `192.168.10.5:50000 → P4 192.168.10.3:50001`、20 frame/s、`500 µs` 分片间隔、40 s hold。session `C540EE79` 完成 10,000 帧/120,000 WAVE 包；101 个 frame `1,100,…,10000` 测量检查点恒为 F0/Vpp/RMS=`40750.00 Hz / 181.418 mV / 55.452 mV`、三线=`25.000/70.000/24.999 mVpk`。最终 receiver `completed=acquired=10000`，全部 source/magic/version/length/session/CRC、overwrite/incomplete/duplicate/stale/busy、config/metadata/overrange/fifo、socket failure 为 0；正式窗口内 retry/reconnect 固定不增长。
- 10k 的 16 个精确 pipeline health 检查点到 9,600 均为 `acquired=analyzed=published`，frame/gen 10,000 与发布日志直接闭环最终计数。internal 最低 `118811 B`，pipeline PSRAM 固定 `28040080 B`，UI health free 最低 `28126860 B`；FFT 最终平均/最大 `17.491/50.210 ms`。恒定输入只在 frame 1 提交一次 `0→100 mVpk NEW_STREAM`，数据源退出后才 `LIVE→STALE` 且保留 frame 10,000。sender/UART 日志 SHA256 `49028ab265b26cc56f38d3fc30535a105f40c467d476d44ead56e0b52527b168` / `88cee42d73cbd172dae6e47560b552d3c24eb7844ab0d35d3141779a2e5818d1`；v5 evidence/adversarial SHA256 `ba75b82e64f5cb7cba4f7ea4f0038b0552c4ee905405c92cdd0d431d3f347fc1` / `9cc510290db0bfe1f98616f6ef1c9d25f9d91c98fa5cf8ddd4966f94a8067320`，独立复跑正例 PASS、44/44 篡改拒绝。
- v5 高阶正式 6×100 捕获使用 sessions `04E91356`～`04E9135B`，frame 1/100 共 12 条测量全部通过现有端点矩阵夹具；最大 F0/Vpp/RMS/线频/线幅误差 `0.070 Hz / 0.040 mV / 0.009 mV / 0.140 Hz / 0.013 mV`。UART `/tmp/cyclescope-p4-v5-high-harmonic-final-6x100-serial.log` SHA256 `1c76c822485e18891963d033009b6c87d92179ebe0c723685151db5af3289f2a`。该夹具尚未跨文件冻结 sender/ELF/累计 600 health/对抗负例，不能称严格防伪闭环。首轮 `/tmp/cyclescope-p4-v5-high-harmonic-6x100-serial.log` 在第六例只抓到 frame 1，明确是失败诊断，不得作为 PASS。
- v5 四边界 final4 使用同次硬复位后的 sessions `BA29D2A6`～`BA29D2A9`，四个 sender 各完成 100 帧/1200 包且 exit 0；UART 逐例含 frame 1/100，累计 completed=`100/200/300/400`，最终一例后捕获 peer-silent 与 `LIVE→STALE`。四例 F0/Vpp/RMS/谱线结果与 v3/v4 基线一致，最大误差 `0.060 Hz / 0.004 mV / 0.001 mV / 0.120 Hz / 0.003 mV`。UART SHA256 `6a00bf1010bd6b1165284210b81a9629063f1e7eb0cd785f283bf53eadab16be`；四份 sender SHA256 `a4da0886…0dfb / e37ec79c…451a / 0645c962…c9a9 / 24cbaf0c…d637`。最终只读 evidence/adversarial SHA256 `36b31e0f3280a874c8f95e90740d321c99414f713da72f574663621615f90597` / `259b5ac13084b8c1c96b00bcd3273404160bbf6945100dd0d53771f261bd28ce`，final4/final2 与 canonical-log SHA 正例均 PASS，70 个日志/内容负例及 1 个 CLI 冲突全部拒绝；final2 明确输出最终 STALE `NOT_CAPTURED/NOT_CLAIMED`。旧 `boundary-final` 仅前三例、`final3` 无 UART 配对，均不得使用；final4 是正式历史证据。
- v5 滤后残余 session `325A36C4` 输入 20 kHz H1/H3/H5=`30/25/15 mVpk` + 1 MHz H50=`0.316 mVpk`，frame/gen 1/1 与 100/100 都只输出 20/60/100 kHz 三线，F0/Vpp/RMS=`20000.00 Hz / 105.036 mV / 29.581 mV`。首帧量程 `0→50 mVpk NEW_STREAM`，结束后 LIVE→STALE；短窗口没有周期 health，不能声称完整健康快照。sender/UART SHA256 `6aec77b7ed13be1c25c0e6f93713348a3c6b0496a96aaabc8e9f1ad11f2cd93f` / `1fba9a1797117f13153f83b9226d631280e91d28107e225b39723a217493c503`；evidence/adversarial SHA256 `dc354e67cc5c71a303d501216c56d6be55380f09c023230ca723ea29cb9d7598` / `aaeff0ce6591b09375d68f6cdae04fa87524564a42fc3caed6b621fc522eb602`，独立正例 PASS、22/22 篡改拒绝。该项仍只证明滤后 P4 数字链，不证明真实 200 mVpp、≥1 MHz 前端抗干扰。

## 当前 v4 显示契约、相位稳定性与板上回归（2026-07-30）

- Display-only v7 使用 `tool-of-rei/test/display_fault_test.cmake` 注入，夹具中的完整测量帧与 `InstrumentApp` 一样静态复用，继续受 `-Werror=frame-larger-than=4096` 约束。程序化 `LV_EVENT_CLICKED` 顺序固定为 `TIME→FFT→TIME→1P→3P`，检查 waveform/spectrum 显隐、周期键 hidden flag、generation 不变及 `100/300 us` span；D0 warm/strict 的最大单次回调为 `18.793/18.635 ms`。D1/D2 与 D3～D9 的既有故障矩阵继续全部 EXACT/PASS。取证 UART `/tmp/cyclescope-p4-display-fault-v7-uart-pass.log` SHA256 `4a6c41f4da9c78ae68a72381ec67c2ad718505991a235d8bff79807b0629e041`；该轮已烧录镜像 ELF/BIN SHA256 `e7bff3955a99c951e9edc0f6851678a4d20a73a1a7aa6e416a80d03ec8803750` / `decf371aee726ce403c0c8b2cadb3cc2828cadb3032c04f0f1cac5f520dd0d2d`。之后只改 FFT/H1 phase 与纯投影路径，Display v7 已重新编译通过但无需用软件证据冒充 panel flush
- 旧时域投影取复合波形的第一个上升过零；当 H3/H4 或 H49/H50 占优时，同一波形随帧起始相位可锁到不同过零分支。现由 `FftAnalysisResult::fundamental_phase_radians` 携带 H1 正弦相位，`project_waveform()` 在所有等价 H1 上升零点中选择使 3P 区间靠近 8192 点 Hann 窗中心者；1P/3P 共用同一 fractional anchor。非有限 phase/DC/Fs/F0/Vpp/RMS、越界或零动态范围全部 fail-closed，FFT valid 也要求 H1 phase 有限
- `tool-of-rei/test/waveform_projection_self_test.cpp` 在 `-Wall -Wextra -Werror -pedantic + ASan/UBSan` 下 PASS：普通 H1/H3/H4 与弱 `5 mVpk H1 + H49/H50`，F0 注入已观测最坏 `+0.14 Hz`，H1 phase 扫 `-2π…+2π` wrap 两侧，1P/3P 零延迟相关性不低于 `0.995` 且 min/max 最大差不超过 `5 mV`；NaN/±Inf phase 被拒绝。频谱投影与 exact weak host tests 也继续 PASS
- normal v4 fresh build `/tmp/cyclescope-p4-normal-host-v4` 的 CMake cache、本地片段、sdkconfig、compile commands、ELF 符号/字符串均确认无夹具污染；`CONFIG_CYCLESCOPE_CSLP_PEER_IPV4=192.168.10.5`、`-O2`、heap trace off。烧录三段 hash verified，之后 app 区完整读回与 BIN 逐字节一致。启动日志中的 primary phase 门禁及 exact weak CRC/H1 phase/数值/时限联合门禁均 PASS；UI RUNNING 约 `4.24 s`，按既定规则只记录、不作为 2 秒失败项
- 最坏在线 session `0A8E2417`：输入 H1/H49/H50=`5/20/25 mVpk`、10/490/500 kHz，600 帧/7200 包；frame 1/100/200/300/400/500/600 数值一致，实测 F0/Vpp/RMS=`10000.00 Hz / 90.331 mV / 22.913 mV`，三线=`5.001/20.000/25.001 mVpk`，UI `Amax=50.0 mVpk`。终值 `acquired=analyzed=published=600`，stale/invalid/fft_fail=0，FFT avg/max=`16.624/19.116 ms`。正式 session 前模拟器尚未启动造成的 3 次 reconnect、结束后的 peer-silent 均在正式 600 帧窗口外
- v4 四边界 session `78EB6CCB/78EB6CD1/78EB6CDE/48CA72FC` 各完成 frame 1/100；最大 F0/Vpp/RMS/谱线频率/幅值误差为 `0.060 Hz / 0.004 mV / 0.001 mV / 0.120 Hz / 0.003 mV`，覆盖 50/100/250 mVpp、2/3 根谱线、弱 H1 与 200/500 kHz 分量边界。分段 sender 退出期间的握手 timeout 不属于任何正式数据 session，四个正式 session 内无 measurement/projection/FFT reject、WDT、panic 或 assert

## Display stack 完整生命周期与正常镜像恢复（2026-07-30）

- 正常启动顺序固定为 `cyclescope_display_stack_init → InstrumentApp::start_ui → prepare_live_data → receiver.start → app.connect`。Display、UI 或 FFT prepare 失败时 receiver 始终保持 Stopped，避免给永久 receiver task 草率添加不安全的假 stop。
- `cyclescope_display_stack_t` 持久保存 BSP LCD、raw touch、LVGL display/indev、DMA2D、LEDC、adapter/worker 与 poisoned 状态。成功路径按 `backlight off → touch unregister → display unregister → adapter deinit → LVGL 9.4 general mutex 兼容清理 → raw touch → BSP touch IO/I²C → panel DMA2D disable → LEDC channel deconfigure → BSP display delete` 回收；destroy 幂等，关键错误会 poison 并停止向下删除硬件。
- 板上 v1 首先发现 BSP delete 前未关闭 panel DMA2D，导致 panel delete 失败、DSI interrupt 残留及第二次初始化 abort；补齐 `esp_lcd_dpi_panel_disable_dma2d()` 后可重复创建。v3 又补齐 BSP 未释放的 LEDC channel/GPIO 26。两者均保留显式错误检查。
- v4 每次完整 create/destroy 的 internal heap 精确线性减少 96 B。`display_fault_trace.defaults` 打开的 standalone heap trace 记录到唯一 92 B allocation，调用链为 `xQueueGenericCreate → xQueueCreateMutex → LVGL prvMutexInit/lv_mutex_init → lv_os_init → lv_init → esp_lv_adapter_init`；allocator 对齐后正好是 96 B。根因是 LVGL 9.4.0 创建 `lv_general_mutex` 却未在 `lv_deinit()` 删除。
- 最终兼容清理位于 tracked `main/lvgl_adapter_init.c`，仅在 adapter 已确认 deinit 后幂等删除该 mutex，并把 mutex 状态纳入 `resources_released()`。ignored `managed_components/lvgl__lvgl/src/lv_init.c` 已恢复为 Component Manager 原件，二者 SHA256 同为 `15738eb7eb04342eb28c1651c9d79df442087bacde3fdda1acc36c15c842927f`，干净依赖解析不会丢修复。
- 正常 `-O2` Display-only v6：D0 warm/settle/strict、D3～D9 七个取得所有权后的 one-shot 注入、每点正常 retry、canvas D0/D1/D2 与最终 teardown 全部 `journal=EXACT / owned=EMPTY / heap=EXACT / integrity=PASS`；无 panic、WDT、assert、heap corruption、panel-delete、interrupt 或 GPIO conflict。ELF/BIN SHA256 `ffdde81fa748234dae6b1471177a8dfb4d4ee4871fd3a1a3b7b5619ae66eb4da` / `56ef7bb17db656a8437fbd82a0361cea7e9ec8467335e50f79a0678c03522d7c`，日志 `/tmp/cyclescope-p4-display-stack-fault-v6-serial.log` SHA256 `a98783bc10a4aef4356cc01d126f087951fb11a6732df6804a7b1d75517da8e0`。
- root-cause trace 失败日志 `/tmp/cyclescope-p4-display-trace-v2-serial.log` SHA256 `898a8af83d3e0e7146a9a41af51e85a2d5b42a0068ebd28b318cd05c06957c62`；修复后 trace 全矩阵日志 `/tmp/cyclescope-p4-display-trace-v3-serial.log` SHA256 `ba6ca0d0207484b04199e5b0ef23ef8e8f26827545a22ab08065b8ee6c76f483`。诊断 build 独立使用 `-Os` 以容纳 RISC-V frame pointers；正常镜像仍为 `-O2` 且不含 heap trace。
- fresh normal `/tmp/cyclescope-p4-normal-host-v3` 通过 CMake cache、sdkconfig、compile commands、ELF 符号/字符串去夹具检查并烧回。正式 session `0x306ADB08` 完成 600 帧/7200 包，frame 1/100/200/300/400/500/600 均闭环，最终 `acquired=analyzed=published=600`、stale/invalid/FFT failure 全零；自动审核造成的握手重试发生在正式 session 前，发送端退出后的 peer-silent 发生在闭环后。

## Display 画布事务与正常镜像恢复（2026-07-30）

- `WaveformView` 与 `SpectrumView` 的 `create()` 现为全成功才提交成员的事务；失败和显式 `destroy()` 均按 `lv_obj_delete(view object) → 清 LVGL 指针 → heap_caps_free(外部 PSRAM)`。Spectrum 的 8 个轴标签一并纳入局部构建回滚，两个 View 禁止复制。
- `InstrumentApp` 只拥有一个 `ui_root_`。布局失败固定按 `SpectrumView → WaveformView → ui_root_` 逆序回滚；只有 shell 与两块 canvas 全部成功才置 `ui_started_`、footer `UI READY` 并输出 ready 日志。`main.cpp` 在 UI 启动失败时不再继续 prepare/connect。
- 私有 Display-only 夹具位于 `tool-of-rei/test/cyclescope_display_startup_fault_test.*` 与 `display_fault_test.cmake`，唯一注入宏为 `CONFIG_CYCLESCOPE_DISPLAY_STARTUP_FAULT_TEST=1`。D0 warm/strict、D1 waveform PSRAM、D2 spectrum PSRAM 的固定 journal、failpoint 精确消费、screen child 指针/顺序/数量、两类 heap、integrity 与同实例 retry 均在板上 PASS；总矩阵于 POWERON 后 `1711 ms` 完成。
- v3 夹具曾把 `sizeof(InstrumentApp)=31,776 B` 的对象放入仅 `10,240 B` 的 main task 栈，函数实际栈帧约 `32,096 B`，触发硬件 stack guard；随后 panic 阶段以 `HP_SYS_HP_WDT_RESET` 二次复位。改为单个静态实例并传引用后，在 LVGL lock/worker/bridge 顺序完全不变的情况下 v4 立即全矩阵 PASS，形成单变量 A/B。夹具源现额外使用 `-Werror=frame-larger-than=4096`，禁止大栈帧回归。
- 更早的 v2 曾同时含同步 `lv_refr_now(display)`，并在相同位置 WDT；该轮明确不算 PASS，刷新调用已删除。由于 v3 在没有 `lv_refr_now` 时仍由栈溢出复现，v2 日志不能单独证明刷新是根因；MIPI `on_frame_buf_complete unavailable` 仍作为独立真实 panel-flush 风险保留。
- Display v4 ELF/BIN SHA256 为 `db5493d7faa43231900147bd234121fafe94cb4ec42eed64f9ced7ff5aefa7d0` / `2d26d5184588cda605d8c23704eca85fa8431e729382211f74c755568969adcf`；板上日志 `/tmp/cyclescope-p4-display-fault-v4-serial.log` SHA256 `75fec912dac7ddbf988bf917aec32f3c4465e5638f538df3f350151216f56c0d`，无 WDT/panic/assert。
- fresh normal `/tmp/cyclescope-p4-normal-host-v2` 经 CMake/sdkconfig/compile commands/ELF 字符串与符号五重去夹具核对后烧回。session `0xDB915C88` 发送 600 帧/7200 包，最终 `completed=acquired=analyzed=published=600`，frame/reject/socket/stale/invalid/FFT failure 全为 0；FFT 平均/最大 `17.482/24.626 ms`，首帧 publish→UI bridge `55 ms`，`max_ui_gap=260 ms`。模拟器延迟启动前的 retry/reconnect 和发送端退出后的 peer-silent 均在正式 600 帧窗口之外。

## 合并记录
- FFT 特性提交：`7eaeb32 feat(esp32-p4): add 8192-point FFT processing`；合入 `main@9f4f279` 时手工整合了 CMake、LiveDataPipeline、SpectrumFrame/Model/View 和 InstrumentApp，保留 LAN 与全频谱 UI。
- `main` 显示基线：`c911db9 feat: add buffered full-spectrum display pipeline`。
- LAN 提交：`388b29f`（初始接收器）、`471df1a`（状态加固）、`c9e3ae2`（可配置 peer 与默认关闭诊断）。
- merge commit：`45ad41b`，ort 自动合并，无文本冲突；源 worktree 仍保持 `codex/ESP32P4-LAN@c9e3ae2`。
- `tool-of-rei` 四件套按用户要求改为 tracked；日志、构建产物和本地 `sdkconfig` 继续忽略。
- 测试夹具硬约束：今后新增的 runner、串口捕获脚本、自测源码、故障注入夹具和生成器统一放在 `tool-of-rei/test/`；不得把夹具源码散落到 `/tmp` 或产品源码目录。`/tmp` 只放二进制、原始串口/模拟器日志、pcap 等运行产物，并在快照或 scratch 中登记关键路径与哈希。
- startup-fault 私有构建边界：公开 Kconfig 不再暴露 `CYCLESCOPE_STARTUP_FAULT_TEST`；公开 CMake 仅提供默认空的 `CYCLESCOPE_LOCAL_TEST_CMAKE` 入口并检查片段存在。两份夹具源码、include 路径、测试宏和互斥检查全部由 ignored `tool-of-rei/test/startup_fault_test.cmake` 注入，正常 fresh build 不传该参数。
- runtime-fault 私有构建边界：ignored `tool-of-rei/test/runtime_fault_test.cmake` 单独注入 `CONFIG_CYCLESCOPE_RUNTIME_FAULT_TEST=1` 与 RT 夹具；不与同步 startup 矩阵混用。正常 build 的本地片段入口为空，compile commands/ELF 均不含 runtime 夹具或 RT 字符串。
- 正式协议事实源为本工作树中的 [CSLP UDP 通信协议](../docs/协议与接口/CSLP-UDP-通信协议-v0.1.md)。

## 项目目标
- G 题范围：10 kHz～500 kHz 周期信号，显示 1/3 周期波形、Vpp、真有效值、基频和频谱。
- 频率分辨率目标 500 Hz；存在不低于 1 MHz、200 mVpp 干扰时仍需完成分析。
- 系统可以提前上电并持续分析；只有系统完全启动且 LAN 会话已建立后，专家按 TIME、FFT、1P 或 3P 才开始 2 秒计时，对应内容须在窗口内真正上屏。POWERON→PHY ready 的冷启动耗时不属于该窗口。
- 口径依据：`docs/主办方答疑/26电赛问题解答2607292103.txt` 明确以专家要求开始测量后按下功能键为计时起点，并允许通过触摸选择/控制键分项显示。

## 冻结硬件与软件基线
- ESP32-P4 Function EV Board revision v1.0，CPU 360 MHz，16 MB Flash，32 MB PSRAM。
- 1024×600 MIPI-DSI、EK79007、GT911；LVGL 9.4.0、`esp_lvgl_adapter` 0.6.2、BSP 5.2.3。
- `esp_codec_dev` 固定 1.5.10，避免 1.5.11 发布包的 CMake 错误。
- ADC：单颗 AD9226 通道 A，原始 65 MSPS；不采用双 ADC 130 MSPS 交织。
- 网络：P4 `192.168.10.3:50001`，生产 FPGA `192.168.10.2:50000`，静态 IPv4/UDP，无网关和 DHCP。
- 物理链路按 P4 百兆口设计；默认两板普通网线直连，交换机用于联调和抓包。

## 冻结 Profile 1 与 CSLP
- FPGA 先低通并 16 倍抽取，线上样点率 4,062,500 S/s。
- 每帧 8192 个 S16_LE 样点，采集窗约 2.016 ms，FFT 栅格约 495.910645 Hz。
- 异步投递周期 50 ms（20 frame/s）；WAVE_DATA 应用头 72 字节，每帧固定 12 个 UDP 包。
- 控制面使用应用层 ACK、100 ms 超时、最多 3 次重试和同序号幂等缓存。
- 数据面无 FRAME_ACK、重传或背压；坏包/缺片丢整帧并保留上一有效结果。
- 三缓冲角色为 assembling/latest/in_use；未采用的 latest 可覆盖，InUse 绝不覆盖。
- 消费 API：`acquire_latest(FrameCursor{session_id, frame_id})` → 处理 → `frame_is_current()` → 发布 → `release()`。

## 组合架构

```text
CSLP receiver（Core 1，priority 6）
  → assembling/latest/in_use 三缓冲
  → 唯一正式 mailbox consumer（Core 1，priority 4）
  → esp-dsp 8192 点 FFT/测量 + 独立 1P/3P 包络投影
  → 4097 Bin→640 列频谱 + 640 列时域包络
  → 深度 1 latest 结果队列
  → LVGL worker/UI（Core 0）
```

- `LiveDataPipeline` 已删除周期性本地 sample source 与 raw queue；启动时临时自检帧只验证 FFT，不发布到 UI，随后立即释放。
- 分析任务同时最多持有一个 `FrameView`，RAII 保证所有失败/过期路径 release；游标在 acquire 后立即前移，发布前紧邻调用 `frame_is_current()`。
- Fs、scale、offset、config/session/frame/timestamp/calibration/flags 全部来自 CSLP 元数据；新 session 不再因 frame_id 重用被 UI 误判。
- 网络 receiver priority 6 高于 analysis priority 4，保持收包可抢占计算。
- LVGL API 只能在 Core 0/UI 上下文调用；网络和分析任务不得持有 LVGL 对象。
- 冷启动时 Core 1 一次性 bootstrap 独占 `receiver.start()`；Core 0 同时建立 UI 壳，并在 LVGL 锁外 prepare FFT/self-test。静态二值信号量发布 receiver 结果后才创建 analysis task，READY 前不会访问 receiver frame API。
- `LiveDataPipeline::prepare()` 与 `start(receiver)` 两阶段分离；prepare 失败会删除 queue/frame 并显式 deinitialize FFT，正常路径只初始化一次。`sdkconfig.defaults` 固化 app_main Core 0 与 FreeRTOS 静态分配。

## 已完成的显示链
- 时域：每个显示像素列保存源区间 min/max，1P/3P 包络不会吞峰。
- 频域：完整 4097 个正频率 Bin 保留在 Core 1 的两个 32,784-byte PSRAM 缓冲中轮换。
- 显示压缩：完整 4097 Bin 仍供分析，但画面只把 `0..500 kHz` 的 1009 个 Bin → 640 列，每列保留 peak 与 RMS；首个带外 Bin 1009 不参与，最多附带 16 个语义峰值。
- 跨核：固定容量 POD 帧进入深度 1 latest 队列；Core 0 只消费最终显示数据。
- 渲染：时域 638×302、频域 638×284 RGB565 PSRAM 画布直接栅格化，避免数百个 `lv_draw_line` 任务。
- 时域二次映射：640 列投影到 638 像素时按源区间再次聚合 min/max；主机测试把极值放在中间及最后一列验证不漏峰。
- 频谱二次映射：640 列投影到 638 像素时对每个像素覆盖的源区间做 peak/RMS max-pool；原来会被直接索引跳过的第 319、639 列现均可见，500 kHz 最右边界不再丢失。
- 实机 20 Hz 压力：`rx=573, analyzed=573, published=573, ui=571, dropped=0, max_ui_gap=58 ms`。

## 已完成的 FFT 处理链
- `FftProcessor8192` 使用 `espressif/esp-dsp` 的 8192 点 FC32 FFT；当前显式调用参考实现 `dsps_fft2r_fc32_ansi`。ESP32-P4 优化实现 `dsps_fft2r_fc32_arp4_` 已证实会破坏特定弱、相位敏感低频输入，未经目标端 A/B 不得恢复。
- 对 S16 采样执行物理量标定、去直流、Hann 窗、FFT/位反转和单边幅度校正，输出 4097 个 0…Fs/2 Bin。
- 测量输出包含 Vpp、真有效值、基频和三条精确谱线；自检向量为非相干 40.75 kHz 基频及 3/4 次谐波。
- 4097 点单边谱压缩为 640 列 peak/RMS，保留每列峰值；三条精确谱线填入全频谱峰值结构。
- FFT 大缓冲、窗、旋转因子表和单边谱优先放入 PSRAM；任务栈使用内部 RAM。
- `tools/generate_fft_test_vector.py` 可生成/校验与固件一致的 8192 点 S16 合成数据。

## 已完成的 LAN 接收链
- `cslp_protocol.*`：逐字段大小端、CRC-32/ISO-HDLC、82 字节黄金报文自检。
- `cslp_udp_receiver.*`：IP101/RMII、握手重试、来源/会话/Profile 校验、12 分片重组和 20 项统计。
- `cslp_receiver_policy.hpp`：session-aware 游标、u32 回绕和拒绝帧策略。
- `cslp_fpga_emulator.py`：正常流、7 类故障注入、可配置多音/标定元数据及 HELLO/CONFIG/ENABLE/DISABLE 状态与幂等自检；拒绝重复谐波和缺失 H1 的伪真值输入。
- Kconfig 生产默认 peer `.2`，诊断消费者默认关闭；`.5` 仅用于本地主机模拟器测试。

## 合并前验证摘要

| 子系统 | 结果 |
|---|---|
| LVGL/频谱显示 | 20 Hz、最大 UI 间隔 58 ms、无丢帧，PASS |
| C++ protocol/receiver policy | `-Wall -Wextra -Werror`、ASan/UBSan，PASS |
| Python 控制幂等 | HELLO/CONFIG/ENABLE 重放与 `SEQ_CONFLICT`，PASS |
| 100 帧 LAN 短测 | 1200 包，协议/重组错误 0，PASS |
| 7 类故障注入 | incomplete/duplicate/CRC/metadata/config/stale 精确命中，PASS |
| 10,000 帧压力 | 120,000 包，无误重连、丢包或内存下降，PASS |
| 1200 帧所有权 | `acquired=233`、`hash_checks=2330`，mutation/release/busy 为 0，PASS |
| 跨 session InUse | `old result suppressed`、`post_stale=1`、`release=4/0`，PASS |

## 合并后验证（2026-07-29）

| 项目 | 结果 |
|---|---|
| 生产配置边界 | Kconfig/正式镜像为 `.2 + diagnostics off`；`.5` 只出现在测试记录与 ignored 回归配置，不进入生产固件，PASS |
| 主机自检 | Python CSLP 控制幂等 PASS；C++ protocol/policy 在 `-Wall -Wextra -Werror`、ASan/UBSan 下 PASS |
| ESP-IDF 6.0.2 | 全量 2133/2133；正式镜像 `0x104760`，app 分区余量 87%，PASS |
| `.5` 在线组合压力 | 600 帧、7200 个 WAVE_DATA 包；250 ms 持有下 `acquired=111`、`immutable_fail=0`、`invalid=0`、`release=111/0`、`busy_delta=0`，PASS |
| 在线压力期间 UI | `rx=1173, analyzed=1173, published=1173, ui=674, dropped=0, max_ui_gap=51 ms`，空闲内存约 28.7 MB，PASS |
| 正式镜像冷启动 | ESP32-P4 v1.0、360 MHz、32 MB PSRAM、IP101 Link Up、`.3 → .2`、LVGL Core 0、CSLP Core 1、4097→640，PASS |
| 正式镜像健康 | `rx=1173, analyzed=1173, published=1173, ui=1155, dropped=0, max_ui_gap=51 ms`，PASS |

- `.5` 压测中的 `acquired=111` 小于发送 600 帧是预期的 latest-wins 行为：诊断消费者故意持有 250 ms，未消费的 latest 被新帧覆盖。
- FPGA `.2` 当前不在线，ARP 为未解析状态；正式镜像的 `send errno=12` 出现在离线 peer 重试路径，不是组合压力过程中的 heap 持续下降。
- 当前真实 FPGA/FFT 端到端闭环仍未完成，不能把接收链与模拟显示链的组合 PASS 宣称为 G 题整机 PASS。

## FFT 特性与合并验证（2026-07-30）

| 项目 | 结果 |
|---|---|
| 合成数据脚本 | 8192 点 S16、非相干基频与 3/4 次谐波，参数/预期量与固件一致，PASS |
| FFT 独立长测 | 10,200 帧，平均/最大 `15.433/16.934 ms`，stale/失败 `0/0`，无 WDT、复位或内存持续下降，PASS |
| UI 手动回归 | 历史独立阶段 TIME/FFT 与 1P/3P 点击切换流畅；只作为功能烟测，不构成当前最终 LAN 链的按键到面板刷新验收证据 |
| 合并构建 | ESP-IDF 6.0.2 增量构建 PASS；镜像 `0x10aa00`，app 分区余量 87% |
| 合并固件冷启动 | ELF SHA256 `6c5415e87…`，360 MHz、32 MB PSRAM、IP101、LVGL Core 0、FFT Core 1，PASS |
| FFT/显示自检 | FFT8192 `15.825 ms`、heap integrity、4097→640 peak-preservation 全部 PASS |
| 合并固件持续运行 | 1200 帧：`src/analyzed/published=1200/1200/1200`，stale/失败 `0/0`，平均/最大 `15.507/16.606 ms`，内部堆/PSRAM 在 600、1200 帧均为 `115331/28460540` bytes，PASS |

- 合并固件已同时链接 LAN、FFT 与全频谱 UI；由于 FPGA `.2` 离线，本次 CSLP handshake timeout 属预期。
- 该合并阶段 FFT 输入仍是本地 S16 合成帧；这一限制已由下节“CSLP→FFT 正式接线”解除，真实硬件标定与整机精度仍属后续任务。

## CSLP→FFT 正式接线与电脑合成联调（2026-07-30）

| 项目 | 结果 |
|---|---|
| IP 冲突隔离 | 生产默认仍为 `.2`；被忽略的本地 `sdkconfig` 与板上联调镜像只信任电脑 `.5:50000`，不碰 `.4`，PASS |
| 正式消费者 | diagnostics 关闭；单一分析任务持有最多一个 `FrameView`，发布前 current 检查且所有路径 release，PASS |
| 100/200/600 帧在线流 | 每帧 8192×S16_LE、12 包、20 Hz；累计至 1,400+ 有效帧无 stale/invalid/FFT failure，PASS |
| 10,000 帧在线长压 | session `0x19BE6339`，120,000 包；receiver completed/acquired 和分析 acquired/analyzed/published 均净增 10,000，错误计数零增长，PASS |
| WDT 修复 | 首轮真实 TIME 重绘触发 IDLE0 WDT；改用 PSRAM RGB565 canvas 后 200/600 帧及多会话矩阵均无 WDT/panic/复位，PASS |
| 内存与性能 | 600/1200 帧时内部堆约 110.6/110.4 KiB、PSRAM 均 28,070,396 B；FFT 平均约 15.8～16.0 ms、最大 23.5 ms，PASS |
| G 题 P4 下游数值子集 | 10/10.5/50/125 kHz 基频并覆盖 200/500 kHz 谐波；F0 最大误差约 2.19 Hz，Vpp 最大误差约 0.011 mV，RMS 最大误差约 0.003 mV，PASS；不外推人工显示/真实前端 |
| 1 MHz 滤后残余 | 20 kHz 的 H1/H3/H5 加 1 MHz、0.316 mVpk 残余；F0/Vpp/RMS 误差约 0.01 Hz/0.213 mV/0.000 mV，P4 下游 PASS |
| 故障注入 | 两轮累计 completed=12、incomplete=6，duplicate/stale/CRC/config/metadata 各 2，busy=0；仅合法帧进入分析，PASS |
| 主机/构建 | 模拟器协议+多音+标定自检 PASS；时域投影及 640→638 聚合在 `-Werror + ASan/UBSan` 下 PASS；ESP-IDF 6.0.2 镜像 `0x10b800`、app 余量 87%，PASS |
| 最终镜像上板 | ELF/BIN SHA256 `4d3531c0…/07793144…`；600 帧/7200 包下 `acquired=analyzed=published=600`，stale/invalid/FFT fail=0，PASS |
| 最终三谱线 | 40.75/122.25/163 kHz，标称 25/70/25 mVpk，板端 25.000/70.002/24.998 mVpk；频率误差均小于 0.1 Hz，PASS |
| 最终性能/内存 | FFT 平均/最大 `15.910/22.410 ms`；内部堆 `110,623 B`、PSRAM `28,069,884 B`；无 WDT/panic/复位，PASS |

- 10,000 帧长压末端 FFT 平均/最大约 `15.795/23.472 ms`；内部堆约 `110.4～110.6 KiB`，PSRAM 固定 `28,070,396 B`，无 WDT/panic/复位或持续下降。
- 投影自测曾把失败分支写成 `return 1`（bool true）而形成假阳性；现已改为 `false`，并在修复后真实重跑通过。旧 PASS 不再单独作为证据。
- 该历史电脑联调镜像当时已真实烧录，三谱线日志和 640→638 聚合均在板上运行；当时 peer 为临时 `.5`，相关结果只能作为历史 P 级证据。板上现已由顶部记录的正式 `.2` 镜像替换。
- 上述 1 MHz 测试输入是按 Profile 50 dB 阻带目标折算到 P4 端的 0.316 mVpk 残余，只验证 P4 不把带外残余误报为被测谐波；不能替代 BNC→模拟前端→FPGA 滤波的 200 mVpp 干扰整机验收。
- LVGL 人工待测：系统提前上电、LAN 会话已建立并持续分析时，在三类 G 题输入下逐项记录 TIME/FFT、1P/3P 的按键时刻、对应内容渲染及面板刷新完成时刻，确认每项不超过 2 秒；同时核对完整周期、谱线相对位置/高度和数值可读性。当前 50 ms 帧周期、约 15～25 ms FFT 与最多约 250 ms 的 UI 调度只证明性能预算，自动 UI bridge 日志和历史切换烟测均不能替代真实 panel flush 取证。

## PHY 冷启动性能诊断（不作为 G 题按键后 2 秒直接判据，2026-07-30）

| 里程碑/阶段 | POWERON 相对时间或耗时 |
|---|---|
| `app_main()` | 1191 ms |
| Ethernet netif attached | 1235 ms |
| IP101 Started / Link Up | 3436 ms |
| Ethernet startup 分段 | platform 0.546 ms；drivers 40.119 ms；attach 0.303 ms；`esp_eth_start` 2205.367 ms；total 2246.335 ms |
| receiver ready | 3462 ms |
| Display initialized | 3661 ms |
| FFT ready / pipeline running | 3792 / 3969 ms |
| Instrument UI started | 3979 ms |

- 诊断镜像大小 `0x10b960`，app 分区余量 87%；ELF SHA256 `9d760402ee278b7127453938a2d8fa5ba3d103a4fabf261ce23d0a71e99e8b88`，BIN SHA256 `dc0e1d7345c26c4d51d4ee53a49957d64e2be3e1f57d758cd62cbbfa28db2687`。
- 实测把约 2.205 秒同步等待精确定位到 `esp_eth_start()` 的 IP101 启动/链路路径；CSLP receiver task 和 LVGL 此时尚未创建，不能把延迟归因于握手、FFT 或绘图。
- 该诊断镜像本轮未启动电脑模拟器，握手 timeout 属预期；最终并行 ANSI 镜像的同次 `.5` 预监听证据已由下方“最终并行镜像预监听闭环”补齐。约 3.5 秒只表征 POWERON 冷启动，不直接判定 G 题按键后 2 秒结果。
- 网络与 BSP/LVGL/FFT 并行能改善 UI 壳和准备时间，却不能消除 3.4 秒左右的有效网络下限；当前验收口径不要求继续优化该启动过程。不要直接缩短 IP101 默认 reset timing；只有未来出现独立冷启动需求时，才在隔离配置、保留超时回退并完成至少 30 次断电冷启和热复位验证后重开此项。

### 电脑 `.5` 预监听端到端基线

| 里程碑 | POWERON 相对时间 |
|---|---:|
| CSLP session ready（`0x216AC34D`） | 3477 ms |
| receiver 首帧 completed（frame 1） | 3491 ms |
| pipeline/self-test ready | 3993 ms |
| 首个 measurement（frame 11, gen 1） | 4027 ms |
| 首次 UI bridge（gen 6，旧日志未带 frame） | 4263 ms |
| receiver completed frame 100 | 8442 ms |

- 模拟器在 P4 启动前已经 `listening`，完成 HELLO/CONFIG_SET/ENABLE_PUSH；100 帧共 1200 个 WAVE_DATA 包全部发送。session→首帧 completed 为 14 ms，首个正式 measurement 数值为 F0 `40749.98 Hz`、Vpp `181.425 mV`、RMS `55.453 mV`，三谱线 `25.000/70.002/24.998 mVpk`。
- receiver 在 pipeline 创建前已经收至约 frame 10；latest-wins 使首个分析帧为 frame 11，属于启动阶段覆盖而非协议丢包。旧 UI 日志只能证明首次 bridge；最终源码已增加 session/frame 身份，真实面板 flush/肉眼可见仍需人工确认。

### 启动并行化上板烟测

| 里程碑 | POWERON 相对时间 |
|---|---:|
| Display initialized / UI shell | 1383 / 1498 ms |
| FFT ready / self-test / pipeline prepared | 1561 / 1742 / 1743 ms |
| IP101 Link Up / receiver ready | 3437 / 3440 ms |
| analysis task / UI pipeline RUNNING | 3458 / 3467 ms |
| static IPv4 ready | 3481 ms |

- Ethernet 分段为 platform/drivers/attach/start/total `0.531/40.610/0.381/2200.657/2242.179 ms`。并行化把 UI pipeline RUNNING 从旧 `3979 ms` 提前到 `3467 ms`，改善约 `512 ms`；这些数值均以 POWERON 为起点，只用于冷启动性能比较，不直接判定 G 题按键后 2 秒结果。
- 上述烟测对应正常路径前一版镜像 ELF `080e2f73…`；最终源码又增加首个 UI session/frame 日志、FFT prepare 失败显式清理和 defaults 固化，ESP-IDF 6.0.2 构建 PASS，最终 size `0x10c190`、ELF `4813c457e1f568eb382cfbc7b1612ea8efee884dde364e67c391ffba86d1a9a9`、BIN `9d1e9846c9c6a0e2479df0a90e153a51d5f1a7a2c1c066e28071acd07feb5a22`，已烧录并完成三段写后校验。

### 最终并行镜像预监听闭环

| 里程碑 | POWERON 相对时间 |
|---|---:|
| UI shell / FFT prepared | 1498 / 1743 ms |
| receiver ready / CSLP session ready | 3440 / 3501 ms |
| receiver frame 1 completed | 3515 ms |
| frame 1 measurement | 3533 ms |
| frame 1 UI bridge | 3559 ms |
| frame 100 measurement | 8486 ms |

- 同一 session `0x1F2346BA` 完成 100 帧；frame 1/100 均为 F0 `40750.00 Hz`、Vpp `181.418 mV`、RMS `55.452 mV`，三谱线 `25.000/70.000/24.999 mVpk`，无 incomplete/reject/WDT/panic。
- 原始串口日志 `/tmp/cyclescope-p4-final-prelisten-coldboot.log`，SHA256 `c562cbed1f3442875b495d95af7dd35f80cc346df567ac2aca214087155fc847`。该证据关闭“最终并行版未完成同次预监听”的旧问题；measurement/UI 的 `3.533/3.559 s` 是 POWERON 冷启动事实，不直接判失败。G 题 2 秒仍需从 TIME/FFT/1P/3P 按键到对应内容实际面板刷新取证。

### 固定链路实验边界

- 当前 `enp2s0` 是系统默认网关，协商为 1 Gb/s full，P4 经交换机接入；同一接口还承载 `192.168.1.194`、`.4` 与 `.5`。强制电脑口 100M/full 会影响整机网络，也不能同步控制 P4 所在交换机端口，可能产生 duplex mismatch。
- 固定 100M/full A/B 只能在专用 USB 网卡直连 P4，或可将 P4 端口与测试端口都固定为 100M/full 的可配置交换机上执行。生产默认必须保留自动协商；该实验只评估冷启动优化，不是 G 题按键后 2 秒验收前置，未完成至少 30 次冷启/热复位和长压前不得宣称改善冷启动可靠性。

## G 题边界矩阵固化（2026-07-30）

- 新增 `tool-of-rei/test/cslp_g_acceptance_matrix.py`，仅复用模拟器纯函数做离线合成、量化边界自检和固定命令输出；默认不建 socket、不启动子进程、不写文件。测试夹具源码统一置于 `tool-of-rei/test/`。
- 4 个案例分别覆盖 `u_a` 100 mVpp/10 kHz、`u_a` 250 mVpp/200 kHz 最高分量、`u_b` 50 mVpp/10 kHz、`u_b` 250 mVpp/500 kHz 最高分量，并同时覆盖 1 个和 2 个谐波、强弱基波。
- 网络参数硬编码为电脑 `.5:50000 → P4 .3:50001`，不会占用生产 FPGA `.2`；量化固定为 100 µV/LSB、500 µV offset、calibration ID 1。
- 离线验证：矩阵 4 例自检 PASS、现有 `cslp_fpga_emulator.py --self-test-only` PASS、单案例 Markdown/命令输出正常、`git diff --check` PASS。
- 自动审核拒绝了包含在线子进程、串口日志解析和 JSON 写入的较大 runner；按停止条件未重试。在线验收改为逐条执行固定命令并保存串口 session/frame 证据，没有绕过审核创建 runner。

### 四例板端在线结果

| 案例 / session | 标称 F0 / Vpp / RMS | P4 F0 / Vpp / RMS（误差） | 标称→P4 谱线 mVpk（幅值误差） | 结果 |
|---|---|---|---|---|
| `ua_100mv_10khz_h2` / `7A2A7497` | 10000 Hz / 100.000 / 35.136 mV | 10000.06 Hz / 100.004 / 35.137 mV（+0.06 Hz / +0.004 / +0.001 mV） | H1 44.444→44.444（-0.000）；H2 22.222→22.224（+0.002） | frame 1/100 一致，100/100，PASS |
| `ua_250mv_200khz_h3_h5` / `2729DA67` | 40000 Hz / 250.000 / 59.948 mV | 39999.99 Hz / 249.996 / 59.948 mV（-0.01 Hz / -0.004 / +0.000 mV） | H1 12.500→12.499（-0.001）；H3 75.000→75.000（0.000）；H5 37.500→37.499（-0.001） | frame 1/100 一致，100/100，PASS |
| `ub_50mv_10khz_h2` / `2729DA83` | 10000 Hz / 50.000 / 16.141 mV | 10000.04 Hz / 50.002 / 16.141 mV（+0.04 Hz / +0.002 / -0.000 mV） | H1 5.536→5.537（+0.001）；H2 22.145→22.145（-0.000） | frame 1/100 一致，100/100，PASS |
| `ub_250mv_500khz_h3_h5` / `2729DAA2` | 100000 Hz / 250.000 / 61.339 mV | 99999.98 Hz / 249.997 / 61.340 mV（-0.02 Hz / -0.003 / +0.001 mV） | H1 80.000→80.002（+0.002）；H3 30.000→29.997（-0.003）；H5 15.000→14.999（-0.001） | frame 1/100 一致，100/100，PASS |

- 四例最大绝对误差约为 F0 `0.06 Hz`、Vpp `0.004 mV`、RMS `0.001 mV`、谱线幅值 `0.003 mV`，远低于题面 `1 kHz / 5 mV` 门槛；各日志均为 `cal=1 test=1`，两谱线案例的清零 P3 不计入有效谱线。
- 补录案例 2～4 的同一冷启动累计计数为 `completed=300`、`incomplete=0`；pipeline 观测为 `invalid=0 failures=0`，FFT 平均/最大约 `15.439/21.175 ms`。案例 1 独立计数为 `completed=100 acquired=100 incomplete=0`。

### 弱基波根因与修复

- 原始 exact 向量为 F0 10 kHz、H1 `5.536332 mVpk / 0 rad`、H2 `22.145329 mVpk / -π/2`，S16 码程 `-228…272`、样本和 `-45607`、完整 LE 样本 CRC32 `0x4ECFD324`。
- ARP4 内核下 100/100 帧复现 `valid=0 lines=1`；板端 10 kHz 邻域约 `2.49 mV` 且不是局部峰，20 kHz 峰约 `10.84 mV`。LAN/reassembly 无罪：板端通过协议 CRC 函数得到的 `0x593F6437` 等于主机将裸样本偏移 28～31 清零后的值；该函数为 CSLP 报文设计，不能直接当裸样本 CRC。
- 只把 FFT 调用从宏映射的 `dsps_fft2r_fc32_arp4` 改为 `dsps_fft2r_fc32_ansi`，其余样本、候选、阈值、谐波族和 UI 均不变，exact 向量立即恢复为 F0 `10000.04 Hz`、Vpp/RMS `50.002/16.141 mV`、H1/H2 `5.537/22.145 mVpk`。未采用“单谱线也有效”或裸降阈值伪修复。
- exact 向量现已作为第二个目标端启动门禁，复用同一 16 KiB 临时缓冲；先断言完整 raw S16_LE CRC `0x4ECFD324`，再断言 valid、两谱线、谐波 `{1,2}`、F0 ±10 Hz、Vpp/RMS/H1/H2 ±1 mV、bin ±0.01 Hz、FFT `<50 ms`。任何失败都经 `prepare()` fail-closed，释放 FFT 资源并拒绝启动正式 pipeline。
- 板上 exact 门禁结果为 F0 `10000.04 Hz`、Vpp/RMS `50.002/16.141 mV`、H1/H2 `5.537/22.145 mVpk`、FFT `13.928 ms`、heap PASS；主机夹具 `tool-of-rei/test/exact_weak_startup_vector_host_test.cpp` 在 ASan/UBSan 下复核码程 `-228…272`、样本和 `-45607`、CRC `0x4ECFD324`。
- 当时 exact 门禁镜像 size `0x10e2a0`，ELF/BIN SHA256 `4a27eef854e565bf64b5109ac4604d54168d812684599f64e3c2147eb41eb15b` / `96da349dff0da5a43a6a205b20abc3ca77721dbb2704ad31391f49b2bd75444e`；pipeline prepared 由约 `1743 ms` 推迟至 `1960 ms`，增加约 `217 ms`。这些数值以 POWERON 为起点，只表征冷启动准备过程，不属于专家按键到内容上屏的 2 秒窗口；该镜像现已被 `0x10e5f0` 正常 `.5` 镜像替换。

### exact 门禁镜像回归

- 四例 G 题在线重放使用 session `93BF8397/93BF83D2/93BF83D7/93BF83DD`。前三例各 100/100 且 frame 1/100 数值一致；案例 4 首轮 `150 µs` 分片间隔形成主机 UDP 微突发，终值为 completed `300→397`、incomplete `0→3`，故不计 PASS。
- 案例 4 以 `250 µs` 重跑 session `93BF8433`：completed/acquired `397→497`、incomplete 保持 `3`，即精确 `+100/+0`，数值 F0 `99999.98 Hz`、Vpp/RMS `249.997/61.340 mV`、H1/H3/H5 `80.002/29.997/14.999 mVpk`，PASS。
- 稳定性 session `93BF8491` 发送 600 帧/7200 WAVE 包，receiver completed/acquired `497→1097`、incomplete/reject 零增长；再用 103 帧计数闭环 session `93BF84CB`，最终明确 `completed=acquired=analyzed=published=1200`，stale/invalid/fft_fail 均为 0，无 WDT/panic/assert，证明 600 帧区间全链精确 `+600`。
- 串口日志 `/tmp/cyclescope-p4-exact-weak-startup-gate.log`，SHA256 `d2810a4a9cefe17a2a0e5855cfc4a7c346e294014d5bf5661464071cfa57028c`；案例 4 v2、600 帧和计数闭环模拟器日志分别为 `/tmp/cyclescope-p4-exact-gate-matrix-case4-v2.log`、`/tmp/cyclescope-p4-exact-gate-stability-600.log`、`/tmp/cyclescope-p4-exact-gate-health-close-103.log`，SHA256 `26f99a83c33d59a6f9ce1ae2a91273d9d097a012437638455e110cc9466d6935` / `104e88070dd3826628304caeac7e4588bd76073a0f2c1b0eba873657a3473486` / `fce10add4ebe0494f6a6ac3c812cbd28e0441b6ba748be4554bc3cee58ca53a5`。

### 最终 ANSI FFT 30 分钟稳定性

- 正式输入 session `0x36029302`：40.75 kHz，H1/H3/H4=`25/70/25 mVpk`，20 frame/s，`--frames 36000 --chunk-gap-us 250`；发送端明确完成 `36,000` 帧、`432,000` 个 WAVE_DATA 包。
- receiver 正式基线为 `completed=4234`、`incomplete=20`；正式流量最后显式 health 为 `completed=40148`，最后显式 publication 为 `40200`。停源后用独立 session `0x360294BB` 精确补发 1 帧/12 包，下一条 health 直接为 `completed=40235`、`incomplete=20`，因此正式终值严格还原为 `40234/20`，即 36,000 帧全部完成且 incomplete 零增长。
- 正式区间 61 组 receiver health 中 source/magic/version/length/session/CRC、overwrite/duplicate/stale/busy、config/metadata/overrange/fifo 均为 0；既有 `retries=556 reconnects=186` 在正式区间不增长。停源后的 peer-silent 与新 session 握手超时属于数据源退出边界，不计入正式流量错误。
- 60 组 pipeline health 的 stale/invalid/fft_fail 全为 0，60 组 FFT health 的 stale/invalid/failures 全为 0 且 selftest 全部 PASS；最后正式 pipeline health 为 `acquired=analyzed=published=40200`，FFT 平均/最大 `16.740/24.807 ms`。
- pipeline 内部堆首尾 `110507→110503 B`、范围 `108543～110511 B`，PSRAM 全程固定 `28067392 B`；无持续下降。正式区间无 WDT、panic、Guru Meditation、brownout、assert 或复位日志。
- 原始正式日志为 `/tmp/cyclescope-p4-ansi-30m-final.log`；单帧终值补取日志为 `/tmp/cyclescope-p4-final-counter-probe.log`。本结论只覆盖 P4 `.5` 电脑合成链，不外推真实 FPGA `.2`、模拟前端或人工 LVGL 视觉验收。

## CSLP 控制恢复与入口边界扩展回归（2026-07-30）

| 项目 | 受控结果 |
|---|---|
| ANSI 相位/形状补充 | 5 个约 100 帧 session，receiver `101→602`，incomplete=0；frame 1/99 数值稳定，pipeline stale/invalid/failure=0，PASS |
| 未校准元数据 | `calibration_id=0`、calibrated flag 清零的 100 帧全部采纳，metadata reject 零增长，frame 1/98 一致，PASS |
| 100 帧 pcap | 干净数据方向精确 `1100×1472 B + 100×1056 B` WAVE_DATA；IPv4 fragment=0，CSLP CRC 错误=0，PASS |
| TEST_PATTERN / OTR / FIFO | 100 个 `TEST_PATTERN=0` 正常帧全部采纳；额外同时置 OTR+FIFO 的 frame 只使 overrange/fifo 各 `+1`，未进入分析，PASS |
| 三类首 ACK 丢失 | HELLO/CONFIG/ENABLE 请求重发逐字节一致，缓存响应原样重放；control retries `+3`、reconnect `+1`，随后 100 帧恢复，PASS |
| STATUS config 漂移 | config mismatch `+1`，约 503 ms 主动新建 session，retry `+0`、reconnect `+1`，随后 100 帧恢复，PASS |
| STATUS 状态迁移 | `PUSH_ENABLED + last_error=7` 只告警且旧 session 继续；`state=READY` 约 502 ms 主动换 session，retry `+0`、reconnect `+1`，随后 100 帧恢复，PASS |
| 六类入口拒绝 | source/magic/version/length/session/CRC 各精确 `+1`；同 session 后续 100 帧恢复，PASS |
| WAVE 头部矩阵 | 13 个合法 CRC 探针精确形成 metadata `+8`、config `+5`；同 session 高 frame_id 门禁后 100 帧恢复，PASS |
| ACK 语义拒绝 | 缺 capability 的 HELLO_ACK 与 `config_id=0` 的 CONFIG_ACK 均立即拒绝；最终 session 完成 100 帧，completed/acquired `+101`、retry `+0`、reconnect `+3`，PASS |

### 握手完成前 WAVE_DATA 门禁

- 首版 ACK-loss 夹具在 ENABLE_ACK 前发送 8 帧，旧固件曾出现 `completed +8 / overwrite +7 / acquired +0`，证明 `transact()` 会把非期望 WAVE 送入无 ready 门禁的 `handle_wave()`。
- 最小修复在 `handle_wave()` 解码和任何统计前读取 `active_session_id_`，只接受 `receiver_policy::session_is_current(active_session_id, common.session_id)`；握手期 WAVE 静默丢弃，STATUS/ERROR 仍允许处理。
- 修复镜像 size `0x10c190`，ELF/BIN SHA256 `1f74290dbfcfb71c349ad7a96386d1744fbdf8698b338242688aad6c9982feeb` / `13dae704fc2070a2d5babee9090579f7a4382bed78afbf9ecba810de4b02891a`，ESP-IDF 6.0.2 构建与三段烧录写后校验 PASS。
- v2 夹具从电脑 `.5:50000` 延迟 ENABLE_ACK `61.259 ms`，先发送 8 个完整帧/96 个 WAVE 包。板端 session-ready 首条 health 为 `packets=99`（3 ACK+96 WAVE），frame/reject 全部为 0；ACK 后 frame 9 才产生 receiver completed/acquired 与 pipeline analyzed/published/UI 各 `+1`，30 秒最终 health 仍零错误，PASS。
- 夹具：`tool-of-rei/test/cyclescope_pre_ready_wave_guard_test.py`，SHA256 `ebc19408f4bb565020ea3f4f17c6adb3caae01ac51b36d10dff63a1254bce675`。串口/模拟器日志：`/tmp/cyclescope-p4-pre-ready-wave-guard-v2.log` / `...-v2-emulator.log`，SHA256 `3fdafb2cce9312c9e934683dee19c7356f13a0d657d91f6d543c7af880edd3d3` / `e28ad87d8aa2a772d632ae151f1512dd54d47467a366058e37089a532773c547`。
- 首轮夹具以 250 µs chunk gap 发送时，板端只收到 94/96 个握手前 WAVE 包；虽然业务计数仍为零，但证据不够严格，因此不作为最终 PASS。v2 增至 500 µs chunk gap 并加 1 ms 帧间隔后才获得精确 96/96。

## DISABLE_PUSH 与启动资源故障矩阵（2026-07-30）

### DISABLE → CONFIG → ENABLE 生命周期

- `CslpUdpReceiver` 已补 `run_disable_push()`；控制事务仍由 receiver task 单独拥有 socket。默认关闭的 test-only 触发在首 8 个完整帧后执行一次同 session `DISABLE_PUSH → CONFIG_SET → ENABLE_PUSH`，正常固定 Profile 运行不触发。
- 夹具 `tool-of-rei/test/cyclescope_disable_push_test.py` 固定 `.5:50000 → .3:50001`：frame 1～8 正常；收到 DISABLE 后把已开始的 frame 9 全部分片发完；缓存但故意丢首个 ACK；断言重试请求逐字节一致后重放原 ACK；ACK 后、CONFIG_ACK 前注入旧 config frame 10；新 config 后发送 frame 11～18。
- session `F92354FF` 保持不变，config `92F680AC→92F680AD`。主机确认 `disable_requests=2`、首 ACK 丢失一次、重试字节级一致、WAVE 总计 18 帧/216 包；板端只接受 1～9 与 11～18 共 17 帧，frame 10 在 active-session 门禁处静默丢弃。
- receiver `completed=acquired=17`、incomplete/duplicate/stale/busy/reject 全 0；control retry `150→151`、reconnect 保持 `50`。随后独立单帧 session `F923552A` 直接得到 receiver `18` 和 FFT `acquired=analyzed=published=18`，因此 DISABLE 正式区间四级计数严格还原为 `+17`，stale/invalid/failure 均为 0。

### 核心启动失败矩阵

| 矩阵 | 具名失败点 | 结果 |
|---|---|---|
| Pipeline P1～P10 | FFT work/table/Hann/positive spectrum、DSP table init、自检临时帧、自检门禁、analysis frame、UI queue、analysis task | `10/10`；P1～P9 prepare=false、Failed+资源全清+selftest=false+heap integrity；P10 首次 task 创建失败后 Prepared 资源保持可重试，PASS |
| Receiver R1～R14 | mutex、event group、netif init、event loop、Ethernet init、空 handle、netif、glue、attach、ETH/IP handler、eth start、receiver task、同步 static IP | 普通 `-O2`、固定 Core1 严格复测 `14/14`；每项 `owned=EMPTY / heap=PASS / free=EXACT`，当前 R1～R14 internal/PSRAM 基线固定 `240059/32669128 B`，R14→R12 retry PASS |
| Bootstrap fallback | receiver bootstrap task 创建失败 | 自动转同步 `receiver.start()`；receiver、正式 analysis task 与 UI pipeline 最终 RUNNING，PASS |

- 故障注入为一次性具名 pre-call，不使用全局 malloc 次序或耗尽 heap。夹具位于 `tool-of-rei/test/cyclescope_pipeline_startup_fault_test.*` 与 `cyclescope_receiver_startup_fault_test.*`；ignored `startup_fault_test.cmake` 把两份源码、私有 include 与 `CONFIG_CYCLESCOPE_STARTUP_FAULT_TEST=1` 注入 main target。FFT 资源已改为逐指针/table flag/window 状态检查；receiver 已覆盖 mutex、event group、task、Ethernet handles/count、netif、glue、handlers、同步 static IP、socket 与 slot 状态，R6 真实模拟 `ESP_OK + null handles/count=0`。
- R7 的 24 周期探针证明相邻 20 ms 样本会出现短暂 `-4 B` 平台，但旧命令项会在约 500 ms 后释放；夹具现在先等待已实证的 500 ms drain，再要求连续 5 次精确命中基线，普通构建每项均在 580 ms 闭环。这是异步延迟回收，不是线性泄漏。
- R13 诊断分出三层问题：静态 netif 曾继承 `ESP_NETIF_DHCP_CLIENT`；STOP 清 IP 会创建默认 120 秒 lost-IP timeout；Core1 rollback 开始后 Core0 的旧 CONNECTED callback 仍可能重新写 IP。产品修正为去掉 DHCP client、STOP 前主动清零静态 IP、ETH 事件按目标 handle 过滤，并先关闭 `network_callbacks_enabled_`、再借 `slot_mutex_` join 已进入的 CONNECTED/GOT_IP 临界区。heap trace 剩余 3×16 B 是 lwIP 全局周期 timeout 的旧节点释放/新节点重建，净 heap 精确为零。
- 当前普通 `-O2` 串口日志 `/tmp/cyclescope-p4-startup-fault-r14-v1.log`，SHA256 `87a51b431ce7e2b63af3ddd35e379ca597501fcac93b3e769d1ff07a6a63244e`；P1～P10、R1～R14 及 R14→R12 全部 PASS，未见 WDT/panic/assert。独立本地片段测试镜像 size `0x1106a0`，ELF/BIN SHA256 `a7af659c152812418225c93ad8e2987f861ff7ab297c4ae6f767b7811b6d5e67` / `31498b4a61cf6a4b503bafabda6278d918ab4b9cefa2dcb710fb91ae1ac7bfff`。
- 串口日志 `/tmp/cyclescope-p4-startup-fault-disable-push.log`，SHA256 `866540fbac8961d66147c106067bddac65bfdd6ae641b35de0b52c069278b60d`；DISABLE 与计数探针主机日志 SHA256 `2b9c13b2c06f629d1f1b4b96d26cba0e89588d350d259e3b6e7075270fd18449` / `e7fea35241d79e69aa8ed8229e1e7bbfe6812e338acd5e3111ec55fd5fddc435`。
- 故障审计同时修复两个正常路径边界：prepare 失败时 `connect()` 不再被短路，UI 可显示 `ANALYSIS INIT FAILED`；UI timer 在 analysis task 前分配，timer 失败不再遗留孤儿 producer，task 启动失败会删除 timer。`release_resources()` 同步清除 self-test 状态。

### 前一版正常 `.5` 镜像与 600 帧闭环

- fresh `/tmp/cyclescope-p4-normal-host-v1` 构建没有传 `CYCLESCOPE_LOCAL_TEST_CMAKE`，使用 `tool-of-rei/test/p4_host_emulator.defaults` 仅把 peer 覆盖为 `.5`。sdkconfig/生成头只含 `.5`，diagnostic 与 DISABLE_PUSH 均为关闭；CMake cache 的本地片段入口为空；compile commands 不含 `tool-of-rei/test` 或 startup-fault 宏；ELF 不含故障矩阵符号/字符串。size `0x10e5f0`，ELF/BIN SHA256 `e189b4b68b2c5db5e3a43e1d06cea3a777b7d2251f7bcabef8c6bd906a695b90` / `c23cda59441e547e60bb4af1426f45d15531ef715491cc0c30c43528aaeb2060`，构建、烧录与写后校验 PASS。
- session `C6D56E5C` 以 `250 µs` 分片间隔精确发送 600 帧/7200 WAVE 包；板端 frame 1/100/200/300/400/500/600 数值一致，最终 `completed=acquired=analyzed=published=600`，stale/invalid/FFT failure 为 0。receiver 在 frame 413 的 health 中 source/magic/version/length/session/CRC、overwrite/incomplete/duplicate/stale/busy、config/metadata/overrange/fifo 全为 0；FFT 平均/最大 `17.484/37.149 ms`，无 WDT/panic/assert。session 建立前因模拟器较晚启动累计的 retry/reconnect 不属于正式 600 帧区间。
- 正常复测串口/模拟器日志 `/tmp/cyclescope-p4-normal-host-600-v1.log` / `/tmp/cyclescope-p4-normal-host-600-v1-emulator.log`，SHA256 `99cb548bf761b1252c3769b951615cb25bf7f1f7536d32b4541063f2d24d2add` / `47ee305cae7d807a4ccdd53b7a7d6be042b78779460d7545d9b80abbafb9f07b`。

## 0～500 kHz 频谱语义与静态 IP R14（2026-07-30）

### 频谱投影闭环

- 审计复现旧轴 `0..2.03125 MHz` 下 10/20 kHz 中心约为 x=3/6，实际 5/3 像素线宽会相接；同时旧 `column=x*640/638` 会精确跳过源列 319、639，而 500 kHz 边界 Bin 1008 正落在列 639。
- 新增无 ESP-IDF/LVGL 依赖的 `spectrum_projection.*`：固定轴 `0..500000 Hz`，按 `Δf=495.91064453125 Hz` 只取 `[0,1009)` 共 1009 个 Bin；最后一列覆盖 Bin 1007/1008，首个带外 Bin 1009 及其后的巨大值/NaN 不参与 peak/RMS。带内非有限值 fail-closed。
- 640→638 改为区间 max-pool，peak 与 RMS 均不会因跳列消失；语义峰共享纯函数坐标公式，500 kHz ±半 Bin 的合法边界估计夹到最右边，超过容差拒绝。5/3 像素线宽保持旧渲染实际宽度。
- 夹具 `tool-of-rei/test/spectrum_projection_self_test.cpp` 在 `-Wall -Wextra -Werror -pedantic + ASan/UBSan` 下 PASS，覆盖 10/20 kHz 不相接、四例十条谱线 x/y、500 kHz 边界、带外隔离、列 319/639 与 RMS。正常/故障 ESP-IDF 6.0.2 构建均 PASS。

### 静态 IP 同步收口

- `esp_netif_set_ip_info()` 现于 `esp_eth_start()` 前同步调用；失败直接进入既有 startup rollback，不再留下 `Started` 却永久等待 `kIpReadyBit` 的对象。静态 netif 仍不恢复 DHCP client flag。
- CONNECTED 回调中的第二次设置有意保留：glue handler 先完成 `esp_netif_up()`，随后幂等 `set_ip_info()` 发布 `IP_EVENT_ETH_GOT_IP`。只前移并删除该调用会让无 DHCP netif 永远没有 GOT_IP。
- 私有 R14 在真实预配置调用边界一次性返回 `ESP_ERR_NO_MEM`；Core1 上两轮均回到统一 `internal=240059 / PSRAM=32669128 B`，`owned=EMPTY / heap=PASS / free=EXACT`。紧随其后的 R14→R12 barrier 必须通过真实静态 IP 调用再命中 EthernetStart，证明同一对象可重试；完整 receiver 矩阵为 14/14 PASS。
- 故障镜像 size `0x1106a0`，ELF/BIN SHA256 `a7af659c152812418225c93ad8e2987f861ff7ab297c4ae6f767b7811b6d5e67` / `31498b4a61cf6a4b503bafabda6278d918ab4b9cefa2dcb710fb91ae1ac7bfff`；串口日志 `/tmp/cyclescope-p4-startup-fault-r14-v1.log`，SHA256 `87a51b431ce7e2b63af3ddd35e379ca597501fcac93b3e769d1ff07a6a63244e`。无 WDT/panic/assert。

### 当前正常镜像与边界回归

- 默认 `ESP32-P4/build` 保持 `.5`、本地测试片段为空、diagnostic/DISABLE_PUSH 关闭；compile commands 与 ELF 均无 `tool-of-rei/test`、startup-fault 宏或 R14 字符串。镜像 size `0x10eac0`，ELF/BIN SHA256 `cb3f97b4d7a784edc0ff4beecddba06d35622e2b986dec8039a9ee82371e814e` / `c25eb939d6887f47bc7b82e060a87463427e6d2d30d74f15f369070f764db645`，已烧录且写后校验 PASS。
- `u_b` 上边界 session `0x0FA6E7BC` 由电脑 `.5` 发送 600 帧/7200 包；frame 1/100/200/300/400/500/600 均为 F0 `99999.98 Hz`、Vpp/RMS `249.997/61.340 mV`，三谱线 `80.002/29.997/14.999 mVpk`，最高分量 `499999.88 Hz`。UI 首帧明确 `axis=0.50000 MHz`。
- 最终 pipeline `acquired=analyzed=published=600`，stale/invalid/FFT failure 全 0，FFT 平均/最大 `16.886/22.187 ms`，无 WDT/panic/assert。串口日志 `/tmp/cyclescope-p4-spectrum-500k-600-v2.log`，SHA256 `c7a4effccf0d9eae8f148b09f15630b4fb848c6d66e3a45dc8323161daad0528`。该证据证明数值、投影语义和 UI bridge；真实面板谱线观感仍按人工项待测。

## Socket 运行期恢复矩阵 RT1～RT4（2026-07-30）

### 产品恢复与私有注入边界

- 产品统计新增 `socket_open_failures`、`recv_fatal_errors`、`socket_close_failures` 与 `sessions_established`；`reconnects` 继续只表示首轮后的再次尝试数，不能冒充成功 session 数。正常 health 新增独立 `health/socket` 行。
- RT1 对真实 `socket()` 传非法 type；RT2/RT3 仅把本次真实 `setsockopt(SO_RCVTIMEO)`/`bind()` 的 fd 参数改为 `-1`，随后由正式失败路径关闭真实 fd；RT4 只把本次 `recvfrom()` 参数改为 `-1`，真实 socket 始终由既有 Fatal teardown 唯一关闭。没有先 close 再 recv，也没有依赖 UDP `shutdown()` 伪造断链。
- 私有源码与驱动均在 `tool-of-rei/test/`：`cyclescope_receiver_runtime_fault_test.*`、`cyclescope_socket_runtime_fault_test.py`、`runtime_fault_test.cmake`。v4 上板镜像使用 `.5`，size `0x7ae50`，ELF/BIN SHA256 `cbb750bf6e48079effc9067d153614cf99dba8095fefcbd2984b18a2e8e68b61` / `97ae62564cd96c833844c9ebeb0093419825b6fc7426abc9c37f0375cd94eac9`。审查后又把最终恢复门禁由 `>=100` 收紧为精确 `+100` 且 rejection 计数不变，独立构建 PASS（size `0x7af30`，ELF/BIN `5f3206e7bd4f7f4ca6d8478f3d8ed37b00195d28877aac1e3b9441c2a6c905a6` / `a782b97e6573163115b41561c9a0fd7d6bf5ecb48034b203eeb6560e417a992e`）；该收紧只改私有判定，v4 主机本就只发送 100 帧。正常 build 不含夹具。

### v4 上板严格矩阵

- RT1/RT2/RT3 各精确消费一次，真实 errno 为 `22/9/9`；RT2/RT3 的 real fd 都以 `result=0` 关闭。S1 `0x99852711` 建立后夹具持有一个旧 `InUse`，并确保后方另有 Latest，再注入 RT4。
- Fatal 恢复窗口内 active session/config 均清零，Assembling/Latest 全清，旧 `InUse` 的 lease/metadata/样本 hash 保持不变但 `frame_is_current()==false`；真实 fd 关闭且旧 view 仍可正常 release。S2 `0x99852712` 与 S1 不同。
- S2 建立后精确发送一整帧旧 S1 数据，`bad_session +12` 且 completed 不增长；随后 S2 精确恢复 100 帧。首轮暖机后再次连续重臂 RT4 32 次，全部自动建立不同 session；最终 session 再精确恢复 100 帧。
- 最终板端门禁：RT4 共 `33` 次、成功 session `34`、fd opened/closed=`36/35`（最后一个活跃 fd 保留）、close failure `0`、heap integrity PASS，active-session internal/PSRAM `348579/33181568 B` 精确恢复。矩阵前的统计为 open failure `3`、recv fatal `33`、close failure `0`、reconnect `36`。无 WDT/panic/assert。
- 串口/主机日志：`/tmp/cyclescope-p4-runtime-fault-v4-serial.log` / `...-v4-emulator.log`，SHA256 `896944f10fb5db6883eddcef44e847b9a75c85653925f35221b0117467a5a38b` / `a5178d4a30ec96f0671755c524e4027eb552afff858a612cc106b757c41ce6b6`。主机侧记录 34 session、显式旧帧 12 包、两段 100 帧与 32/32 repeat PASS。

### 恢复正常 `.5` 镜像与 600 帧

- RT 结束后已烧回默认 `ESP32-P4/build` 的正常 `.5` 镜像；本地测试片段为空，compile commands/ELF 不含 runtime/startup 夹具或 RT 字符串。size `0x10ec50`，ELF/BIN SHA256 `05c6b12029528905851a10eff4dde899a25476ca551afb2820974497af3d4104` / `8b6ca79026064e60f60705b2177c4dc0f6f42398162fa63565d29794ff44cb9a`，烧录写入校验 PASS。
- 正常 session `0xF26EFDE2` 完成 600 帧/7200 包；frame 1/100/200/300/400/500/600 均为 F0 `40750.00 Hz`、Vpp/RMS `181.418/55.452 mV`，三谱线 `25.000/70.000/24.999 mVpk`。最终 `acquired=analyzed=published=600`，stale/invalid/FFT failure 为 0，socket open/fatal/close failure=`0/0/0`、sessions=`1`，FFT 平均/最大 `17.411/24.798 ms`，无 WDT/panic/assert。
- 正常串口/模拟器日志 `/tmp/cyclescope-p4-normal-600-runtime-v1-serial.log` / `...-emulator.log`，SHA256 `a79a1624db1105035df9468cc9b6727d01ffaf9f3eb9114d29a0ffc27610d035` / `f878c031345bc897ee766a63eb0ac8613f3393a68b8e11f1b01fedba4fcbad0d`。发送端退出后的 handshake timeout 只表示 `.5` 数据源已结束，不计入正式 session。

## 当前 `.5` v3 高阶谐波与统一矩阵补证（2026-07-30）

- 主办方答疑明确每个频率分量可能低至 `5 mVpk`，且谐波阶次只受 200/500 kHz 带宽约束。新增离线夹具 `tool-of-rei/test/cslp_g_high_harmonic_matrix.py`，覆盖 `u_a` 的 H19/H20、`u_b` 的 H47/H50、10/10.5/100/250 kHz 基频、500 Hz 频率网格、200/500 kHz 边界、1/2 个谐波与恰好 5.000 mVpk 的弱基波/弱谐波。夹具自检、Python bytecode 检查和 `git diff --check` PASS。
- 当前板卡仍是正常 `.5` v3，启动日志 ELF SHA256 前缀 `22f02f11b`。六个独立 session `9B75E003`～`9B75E008` 均从电脑 `.5:50000` 送入一个完整 8192×S16_LE 帧并产生有效 measurement；H50 案例正确输出 10/490/500 kHz 与 5.001/20.000/25.001 mVpk，500 kHz 边界 H2 案例正确输出 250/500 kHz 与 25.013/5.001 mVpk。
- 夹具对原始串口日志逐例校验 F0、Vpp、真 RMS、谱线数、频率和峰值；最大误差依次为 `0.070 Hz / 0.040 mV / 0.009 mV / 0.140 Hz / 0.013 mV`，远低于 `1 kHz / 5 mV`。日志无 measurement reject、FFT failure、WDT、panic 或 assert；首例 UI bridge 明确 `axis=0.50000MHz`。
- 原始串口日志 `/tmp/cyclescope-p4-high-harmonic-v2-serial.log`，SHA256 `dc4ec0d82d6ff9cddbec36e648db11c4f96c54c6c094dd1a3e85a9a1878d5dd8`；高阶夹具 SHA256 `05b1b96d3ff13f19b9a5290183f774e2ed2d58a00ed63d2aecb7a56bb82d9e6c`。既有四边界命令的分片间隔由已证实会在 500 kHz 案例产生微突发的 `150 µs` 修正为稳定实测值 `250 µs`。
- 用户明确允许串口采集后，以主动硬复位和同一份 UART 捕获重放当前 v3 的四个 G 题边界与 `20 kHz H1/H3/H5 + 1 MHz/0.316 mVpk` 滤后残余各 100 帧。五份电脑日志与板端依次匹配 session `D9AA4EF8`～`D9AA4EFC`，boot/config 也逐例一致；每例都有 measurement frame 1/100，板端 `Published frame=100` 的累计 completed 严格为 `100/200/300/400/500`，最终 generation=`500`。
- 五例 frame 1/100 均稳定一致：案例 1 为 F0 `10000.06 Hz`、Vpp/RMS `100.004/35.137 mV`、谱线 `44.444/22.224 mVpk`；案例 2 为 `39999.99 Hz`、`249.996/59.948 mV`、`12.499/75.000/37.499 mVpk`；案例 3 为 `10000.04 Hz`、`50.002/16.141 mV`、`5.537/22.145 mVpk`；案例 4 为 `99999.98 Hz`、`249.997/61.340 mV`、`80.002/29.997/14.999 mVpk`；滤后残余为 `20000.00 Hz`、`105.036/29.581 mV`，仅输出 20/60/100 kHz 的 `29.999/25.002/15.000 mVpk`，未把 1 MHz H50 列入目标谱线。全矩阵最大 F0/Vpp/RMS/谱线频率/幅值误差为 `0.060 Hz / 0.004 mV / 0.001 mV / 0.120 Hz / 0.003 mV`。
- `tool-of-rei/test/cslp_g_v3_sender_evidence.py` 现支持 `--serial-log`，并把 `--current-logs` 修正到真正配对的 v2 发送日志。夹具跨文件绑定 session/boot/config，将每例严格切成 `ready → frame 1 → completed → frame 100`，并把两组 receiver health 与两组 pipeline health 分别绑定到对应活动区间；只接受累计 completed、0..500 范围内的帧/管线计数、全部可见 receiver/pipeline/socket 零错误、显式 FFT self-test PASS、FFT 最大值小于 50 ms 和首例 frame/gen/A-B/peaks/`axis=0.50000MHz`。只有发送日志时仍输出 `board_result=UNPROVEN`，配对 UART 后才输出 `board_result=PASS`。启动前和最终闭环后的握手 timeout 不进入正式矩阵窗口，四次会话间 peer-silent 只允许出现在上一例 frame 100 闭环之后；跨运行日志拼接、乱序 ready/completed/health、不可能健康计数、缺 self-test、错误 UI 身份和 pipeline 大间隙的纯内存篡改均已实测拒绝。
- 夹具 SHA256 `abb42513ca05c290980ac9805a364410e5b625abf9eb8452f2ecd79aad919896`；原始 UART 日志 `/tmp/cyclescope-p4-v3-final-g-matrix-v2-serial.log`，SHA256 `416dcaed1bd8fc3f2269e7031bbc3f7a39c3f45c4a25bfc1ed35db5b201765df`。五份 v2 发送日志 SHA256：case1 `25fc857512a683a1762a088de29671150cfb1045d9029cf924047af5166aaff9`、case2 `db3bdb5c1e8878bfef0d362ccf54f15915af18f5cdea79896afb22c0fdcff438`、case3 `fcf6ab9db37eeb2bdb132d5b3108199af7469ca66111206e506b078412cc575f`、case4 `17d1c33dfe3253ae02e33d094b6bddb8ae7c89f7562d478548b26dea69dd5503`、滤后残余 `dd0fe91cf50b7178d38c4c18e6074d8c0e71b83a25a309c70800c4b8fa8f29be`。滤后残余 S16_LE 继续固定为 16,384 B、CRC32 `0xA818AF89`、码程 `-529…523`；`capture_p4_serial.py` 仍保持“明确硬复位后有界采集”的单一语义。

## 当前 `.5` v3 的 10,000 帧数字链长压（2026-07-30）

- 该项补的是“当前 v3 持续数字分析稳定性”，不是 `full.md` 的独立评分项。电脑固定从 `.5:50000` 向 P4 `.3:50001` 发送默认 40.75 kHz H1/H3/H4 多音、100 µV/LSB、500 µV offset、calibration 1；正式重放使用 50 ms 帧周期、每帧 12 包、`500 µs` 分片间隔、10,000 帧和 40 秒 hold。约 3.5～4.4 秒冷启动仍只记录，不判失败。
- 两次预跑均明确判失败并保留诊断：v1 在板卡已运行时先开 emulator，正式硬复位前就建立旧 session，故于 250 帧主动终止；v2 使用 `250 µs`，首个完成帧为 frame 2 且 health 出现 `incomplete=1`，于 1,600 帧主动终止。正式 v3 改为先硬复位、等 `receiver ready` 后再启动 emulator，并把分片间隔放宽到 `500 µs`；session `1700DCF3` 从 `Published frame=1 completed=1` 起无丢帧运行。
- 正式 sender 精确完成 `sent frame=10000 packets=120000` 与 `completed frames=10000 wave_packets=120000`，脚本 wall time 542 秒且 exit code 0。板端 101 个 `1,100,…,10000` 检查点均满足 `Published frame=N completed=N`，相邻 measurement 同 session/config/epoch 且 `frame=gen=N`；frame 1～10000 始终为 F0 `40750.00 Hz`、Vpp/RMS `181.418/55.452 mV`、三谱线 `25.000/70.000/24.999 mVpk`。相对发送真值最大 F0/电压/谱线频率/幅值误差为 `0.000 Hz / 0.003 mV / 0.020 Hz / 0.001 mV`。
- 最终 receiver health 为 packets `121042`、`completed=acquired=10000`，source/magic/version/length/session/CRC、overwrite/incomplete/duplicate/stale/busy、config/metadata/overrange/fifo、socket open/recv/close failure 全为 0；正式 ready 后 retries/reconnects 固定为 `51/17`，只反映 emulator 启动前的等待。发送结束后的 peer-silent 和后续握手 timeout 位于正式 hold 尾窗之后，不计传输失败。
- pipeline 每 600 帧的 16 个精确 health 检查点直到 9,600 均为 `acquired=analyzed=published`，frame 10,000 measurement 位于 `published_frames` 递增之后，直接闭环最终发布 10,000。33 条 pipeline/UI health 全程 stale/invalid/failure 为 0，FFT 最终平均/最大 `16.888/24.733 ms`，`max_ui_gap≤261 ms`；latest queue overwrite 符合约 20 Hz→4 Hz 的预期会计关系。PSRAM free 固定 `28044452 B`，internal free 最低 `118251 B` 后恢复，最终与稳态基线相差不超过 4 B，没有连续不可恢复下降。
- 新增只读 `tool-of-rei/test/cslp_v3_long_stability_evidence.py`，跨文件绑定 session/boot/config、唯一且整行精确的 sender 完成语义、唯一脚本 footer、发送 wall time、单调 UART 时间戳和约 501.325 秒的 ready→frame10000 窗口；逐帧区间绑定 receiver/pipeline health，覆盖 hold 到首个 peer-silent，并检查零错误、绝对内存下限和完整计数。正式夹具 SHA256 `7ec50b210ac41a85cb81d1db564751c03561c89fe999fd458e6fea946f57fca6`；`tool-of-rei/test/cslp_v3_long_stability_adversarial_test.py` SHA256 `5c0699d46d7932e469aa735d8e9bce907464911211b850bce9e4ce99890b2302`，固定的 19 个负例覆盖 footer/运行时/时间轴、health 搬位、计数/内存伪造、冲突完成语义及 final-health→peer-silent 尾窗，全部拒绝。最终正例仍输出 `digital_stability=PASS`。
- 正式 UART/发送日志：`/tmp/cyclescope-p4-v3-final-10000-v3-serial.log` / `...-v3-emulator.log`，SHA256 `70f789c4a57314b573fcf38db66f5d4d7afef7f0d7ce27c1e8ddb55c0c52368a` / `d2713ad2c2b6342a7f53314a310363adf4ba28fd9d8bc43124808215a945bdc8`。失败诊断 v1 sender、v2 UART/sender SHA256 分别为 `79cb5edf3f23d8cdde47bbed3b454a7b62ff73fc59d1c93b28a218474146b1ac`、`6a7e6a6545e0bc3a167f18810e0737f9a26269f5f2ab80a2d0db29a28faa30d9` / `e393a040663fcaec8d15c87582797f7580ea71eb081bce158d98b4aac688a39f`，不得作为 PASS 证据。
- 该长压仍不能外推真实 panel flush、完整周期/谱线观感、BNC/模拟前端/AD9226/FPGA 滤波抽取、200 mVpp ≥1 MHz 实物抗干扰、单路 5 V/≥6 英寸/BNC 线缆或真实 FPGA `.2` 两板链；这些项目继续按任务清单待人工或后续联调。
