Scaxlibur/CycleScope/tool-of-rei/最终系统标定里程碑.md

# CycleScope 最终系统标定里程碑

> 状态：正式范围修订为 `≤250 mVpp` 后，M2～M9 数值链、P4烧录回读和最终自动审计均已完成；仅剩当前最终镜像的 LVGL 人工按键/面板烟测。
>
> 日期：2026-08-01（Asia/Shanghai）
>
> 工作树：`CycleScope-main`，分支 `main`

## 1. 恢复卡片

- 当前目标：完成当前最终镜像的 LVGL 人工烟测，并在用户确认后提交 `main`；自动标定与数值验收已经收口。
- 正式参考：DG4202 CH1 的 50 Ω设置值。M2～M4曾用RTM2032 CH1/CH2分层归因；现场后续CH1未接入，M6～M9只读CH2且不把它当输入真值。
- 核心新增项：AD8065 前级 10～500 kHz 逐频幅频测量，以及 ESP32-P4 本地逐谱线补偿。
- FPGA边界：不修改 FPGA 工作树、bitstream、PS程序、QSPI镜像、CSLP协议或既有元数据。
- 上游身份：继续要求 `calibration_id=25030`、`scale=516 µV/code`、`offset=-6761 µV`。
- 下游身份：新建独立的 `p4_response_profile_id`，绑定新 `response.csv` 及其 SHA-256。
- 测试夹具：只新增到 `CycleScope-main/tool-of-rei/test/final_calibration/`。
- 原始证据：只保存到 `CycleScope-main/tool-of-rei/evidence/final-calibration-<timestamp>/` 或 `/tmp`。
- 不要碰：`CycleScope-FPGA` 工作树、其他分支/工作树、FPGA板上镜像和现有用户改动。
- 当前执行边界：正式普通输入仍为 `≤250 mVpp`。用户实测最大不失真输入约 `380 mVpp`，只作为安全边界；1 MHz干扰例外的实际总包络为 `265.080892 mVpp`。历史 `450 mVpp` 点确认压缩，仅保留负证据，不参与拟合、保留验证或最终验收。
- 冻结身份：profile `C5DCDE41`，response SHA256 `9d1aace3…1c5f`。
- 最终审计：`tool-of-rei/evidence/final-p4-release-audit-20260801_190121+0800/`，20/20案例PASS；`combined-audit.json` SHA256 `abe9ce8c…1a7d`，根清单SHA256 `9e03b4ef…ae18`。

## 2. 标定成功的定义

本轮只有同时满足下列条件才算完成：

1. 逐频获得 `Ksrc(f)`、`Gamp(f)`、`Kadc(f)` 和正式端到端 `Sset(f)`，能够区分信号源、模拟前级和数字链路误差。
2. 训练点与保留点严格隔离；模型冻结后才读取保留点结果。
3. 新逐频表只在 ESP32-P4 内启用，并严格绑定上游 `25030/516/-6761/Profile 1/4.0625 MS/s/8192点` 身份。
4. P4使用校正后的谱线幅值重新计算谱线显示、RMS、Vpp以及1P/3P重构波形。
5. 10～500 kHz 独立保留点幅值误差目标不超过 `3 mV`，硬门槛不超过 `5 mV`。
6. 基频误差目标不超过 `500 Hz`，硬门槛不超过 `1 kHz`。
7. 1 MHz以上干扰、带外残余和混叠诊断分量不使用逐频表逆补偿。
8. 正式P4镜像完成构建、烧录回读和真实链路验收；FPGA全过程保持不变。
9. 结束时DG恢复并回读为 `SIN / 100 kHz / 50 mVpp / 50 Ω / 0 V offset / OFF`。

## 3. 已冻结的接线与豁免项

### 3.1 接线

```text
DG4202 CH1 ─── AD8065 放大器输入

RTM2032 CH1：后续正式验收未接入，输入真值直接使用DG 50 Ω设置

AD8065输出 ─┬─ RTM2032 CH2
            └─ AD9226输入 → FPGA → P4

FPGA CSLP主发：192.168.10.2 → P4 192.168.10.3:50001
FPGA被动镜像：192.168.10.2 → 电脑 192.168.10.4:50002
```

历史双通道分层点要求RTM CH1、CH2来自同一次 acquisition；后续CH1未接入的正式点只采CH2。电脑镜像接收器不得发送任何网络报文，也不得建立第二个 CSLP session。

### 3.2 用户明确不要求复核的项目

以下事项只在证据清单中记录为“用户授权固定条件”，不作为前置检查、失败项或停机原因：

- AD8065反馈取样在50 Ω串联电阻前还是后；
- CH1/CH2探头倍率与RTM菜单倍率均按1处理，不做探头交换修正；
- 内部正负电源轨和器件温度。

仍保留与防止过驱直接相关的安全门槛，因为这不是标定洁癖，而是避免真的把硬件顶坏。

## 4. 标定数据模型

所有正弦幅值统一使用单边峰值。对RTM和FPGA原始样本去直流后，在已知刺激频率上使用正弦最小二乘或相干投影；示波器原始最大值减最小值只作为削顶观察，不进入正式增益拟合。

```text
Aset = DG 50 Ω设置Vpp / 2
A1   = RTM CH1基波峰值
A2   = RTM CH2基波峰值
Cpk  = FPGA帧基波code peak

Ksrc(f,A) = A1 / Aset
Gamp(f,A) = A2 / A1
Kadc(f,A) = Cpk / A2
Sset(f,A) = Aset × 1e6 / Cpk       [µV/code]
Sch1(f,A) = A1   × 1e6 / Cpk       [µV/code]
φamp(f,A) = wrap(φCH2 - φCH1)      [degree]
```

正式 P4 补偿使用 `Sset(f)`；其他量只用于定位误差和形成不确定度报告。`φamp` 本轮记录但默认不上线，不能把它冒充 DG→FPGA 绝对相位。

## 5. 里程碑总览

| 里程碑 | 内容 | 退出条件 |
|---|---|---|
| M0 | 审核与冻结计划 | 本文范围、矩阵、门槛和“不碰FPGA”边界获得确认 |
| M1 | 建立main侧夹具并离线自测 | 计划生成、数据解析、拟合和负例测试全通过，未连接仪器执行写操作 |
| M2 | 只读预检、零输入和低幅门禁 | 双通道高阻、镜像完整、零偏可用、低幅单调且无过驱 |
| M3 | AD8065逐频主扫 | 12个训练频率完成升频和降频，模拟/数字/端到端四层结果齐全 |
| M4 | 幅度依赖与压缩检查 | 正式范围内10 mVpp弱线及50/250 mVpp交叉点通过；450 mVpp压缩点排除 |
| M5 | 冻结第一版模型 | 不读取保留点完成 `response.csv`、身份和SHA冻结 |
| M6 | 独立保留点验收 | 7个保留点满足3 mV目标或至少5 mV硬门槛 |
| M7 | P4本地补偿实现 | 主机测试与正式ESP-IDF构建通过，身份不匹配会fail-closed |
| M8 | P4烧录与逐频回归 | 正式镜像写后校验，通过边界/保留点真实链路测试 |
| M9 | 多音、干扰和最终收口 | G题多音、弱线、1 MHz干扰和LVGL显示通过，产物及恢复状态完整 |

## 6. M0：审核与冻结计划

### 工作项

- 确认正式评分参考为DG4202 CH1 50 Ω设置值。
- 确认逐频补偿只进入P4，不改变FPGA元数据。
- 确认450 mVpp只作为历史工程压缩点；最终正式普通输入上限修订为250 mVpp。
- 确认正式证据目录、命名方式和最终产物清单。
- 保存当前main工作树状态，保护已有连接状态卡等未提交改动。

### 退出条件

- [x] 用户已批准本文列出的八项关键决定。
- [x] 采集矩阵与“只在P4补偿、不改变FPGA”的产品架构已冻结。

## 7. M1：main侧夹具与离线自测

### 计划新增的夹具

```text
tool-of-rei/test/final_calibration/
  calibration_plan.py          # 生成精确、不可重复命名的用例清单
  calibration_campaign.py      # DG事务、WaveBench采集与被动镜像编排
  passive_mirror_capture.py     # 复用/收口现有只收不发的50002接收逻辑
  analyze_point.py              # CH1/CH2/FPGA同口径投影和四层传递函数
  fit_response.py               # 训练集拟合、身份和产物生成
  validate_holdout.py           # 冻结模型后的独立保留点验证
  generate_p4_asset.py          # 从已验证response.csv生成P4只读资产
  audit_campaign.py             # 完整性、SHA、时间窗和门槛总审计
  tests/                        # 合成波形、损坏证据和身份错配负例
```

### 必须离线通过的项目

- 用合成CH1、CH2和S16_LE帧恢复已知 `Ksrc/Gamp/Kadc/Sset/φamp`；
- 非相干窗口下幅值不依赖原始Vpp极值；
- 训练脚本无法枚举、读取或偷偷吸收保留点；
- 缺帧、CRC错误、12分片几何错误、元数据漂移、SHA不符全部拒绝；
- 上游身份任一字段不匹配时，P4资产门禁测试必须拒绝启用；
- `response.csv` 非单调频率、重复频点、NaN/Inf和区间外插值全部拒绝；
- 所有测试运行产物写入 `/tmp`，夹具源码只留在 `tool-of-rei/test/`。

### 退出条件

- [x] 离线单元测试和负例全部PASS。
- [x] `git diff --check` PASS。
- [x] M1完成时尚未对真实仪器执行任何写操作。

## 8. M2：只读预检、零输入和低幅门禁

### M2.1 只读预检

- 读取DG、RTM身份和当前状态；
- 要求DG输出初始为OFF；
- 要求RTM CH1、CH2均为高阻；
- 验证P4与FPGA session在线；
- 被动监听 `.4:50002`，确认至少两个完整8192点帧且 `network_writes=0`；
- 冻结上游元数据和当前P4/FPGA产物哈希。

任何只读预检失败都只停止后续写入，不自动重配FPGA。

### M2.2 零输入

DG保持OFF，同时保存RTM CH1/CH2和至少128个完整FPGA帧，得到：

- `offset_code`、码均值分布和AC噪声；
- CH1/CH2均值、RMS、Vpp和0～500 kHz固定杂散；
- FPGA码范围、离群点、OTR/FIFO/drop状态；
- 新零偏建议值及其不确定度。

### M2.3 低幅单调门禁

按顺序执行：

```text
100 kHz / 20 mVpp
100 kHz / 50 mVpp
100 kHz / 100 mVpp
```

每次均采用 `OFF → 设置并回读 → ON → 稳定 → 并行采集 → OFF并回读`。

### 安全停止条件

- CH2正常目标 `≤2.35 Vpp`；
- CH2 `>2.5 Vpp`、削顶、持续振铃或自激：立即OFF；
- ADC OTR、FIFO异常、帧元数据变化或码值明显饱和：立即OFF；
- DG无法回读OFF：终止本轮，不继续下一个点。

### 退出条件

- [x] 零输入证据完整，offset/noise结果可复算。
- [x] 20→50→100 mVpp三层读数单调。
- [x] 没有过驱、削顶、OTR或协议完整性错误。

## 9. M3：AD8065 10～500 kHz逐频主扫

### 训练频率

```text
10 / 10.5 / 20 / 50 / 100 / 200 / 300 / 400 /
450 / 475 / 490 / 500 kHz
```

主扫幅度固定为 `100 mVpp`。先升频完整执行12点，再降频完整执行12点。

### 每点固定事务

1. 确认DG输出OFF；
2. 设置SIN、50 Ω、0 V offset、目标频率和100 mVpp；
3. 回读全部关键字段；
4. 显式打开输出并等待至少1秒；
5. 并行执行RTM CH1+CH2单次acquisition和FPGA被动镜像采集；
6. 保存至少64个完整、源ON时间窗内的FPGA帧；
7. 检查CH2幅值、削顶和FPGA状态；
8. 关闭DG并回读OFF；
9. 生成逐点 `analysis.json` 和SHA清单。

### 数据处理

- RTM CH1/CH2：同窗正弦投影、相位差、谐波和残差；
- FPGA：逐帧投影后取中位数，并保存最小/最大/MAD；
- 逐点输出 `Ksrc/Gamp/Kadc/Sset/Sch1/φamp`；
- 升降频差进入不确定度，不能静默丢弃不顺眼的数据。

### 复测条件

- 升降频的端到端增益差超过 `0.3%`；
- 单点偏离相邻频率插值超过预期且原始证据显示可能为采集异常；
- CH1、CH2或FPGA帧的稳态离散度明显大于其他频点；
- RTM采集与FPGA源ON窗口没有时间重叠。

复测生成新case ID并保留旧失败证据，不覆盖原目录。

### 退出条件

- [x] 24个主扫点全部有可复算的CH1、CH2和FPGA证据。
- [x] `m3-draft-v1/amplifier-response-draft.csv` 明确给出AD8065的幅频和模拟相位响应。
- [x] 没有未解释的过驱、压缩或方向相关异常；最大升降频差约 `0.0092%`。

## 10. M4：幅度依赖、弱线和压缩

### 最小谱线点

```text
10 / 100 / 500 kHz，均为10 mVpp
```

### 交叉幅度矩阵

```text
频率：10 / 200 / 500 kHz
正式幅度：50 / 250 mVpp
历史压缩档：450 mVpp
```

450 mVpp必须最后执行，并且只有低幅、100 mVpp和250 mVpp全部安全通过后才能进入。

### 判据

- `Gamp(f,A)` 和 `Sset(f,A)` 相对100 mVpp的增益变化目标 `≤0.5%`；
- 硬门槛 `≤1%`；
- 新增输入等效杂散目标 `<1 mVpeak`；
- 10 mVpp点必须能稳定恢复约5 mVpeak主线，不能靠挑帧通过。

若超过1%，停止冻结校准表。非线性前级不能靠给每条谱线随便乘一个二维系数假装治好，多音条件下那会迅速露馅。

### 退出条件

- [x] 正式范围内3个弱线点和6个50/250 mVpp交叉点全部完成。
- [x] `scope-amendment-v2` 明确排除3个450 mVpp压缩案例；一维逐频模型覆盖修订后的 `≤250 mVpp` 范围。

当前事实：10 mVpp弱线3点和50/250 mVpp交叉点6点已完成。用户随后明确授权在现有输入状态下测试450 mVpp；首个 `10 kHz / 450 mVpp` 点得到CH2基波 `4.0271 Vpp`、WaveBench THD `4.3695%`、FPGA拟合THD中位数 `4.4578%`，端到端增益相对M3下降 `3.1224%`，触发1%硬失败。截图只定性显示明显平顶；正式失败数值均来自WaveBench和已知频率拟合。200/500 kHz按规则未执行。

## 11. M5：冻结训练模型和P4补偿身份

### 训练模型

只允许使用M2零点、M3主扫和M4幅度点。保留点目录在本阶段必须不可见或由脚本显式拒绝读取。

对每个主扫频率：

```text
S(f) = mean(Sset_up(f), Sset_down(f))
```

锚点间对 `S(f)` 做分段线性插值：

- 有效范围 `10,000～500,000 Hz`；
- 命中锚点直接取值；
- 区间外不外推；
- NaN、Inf、重复或非升序锚点拒绝构建。

### P4双层身份

FPGA继续发送且不得修改：

```text
calibration_id        = 25030
scale_uV_per_lsb      = 516
offset_uV             = -6761
filter_profile        = 1
sample_rate_hz        = 4,062,500
frame_sample_count    = 8192
```

新建P4本地身份：

```text
p4_response_profile_id = 由规范化身份SHA-256确定性派生
upstream_calibration_id = 25030
response_sha256         = SHA256(response.csv)
valid_frequency_hz      = [10000, 500000]
reference_basis         = DG4202_CH1_50OHM_SETTING
```

### 冻结产物

```text
calibration.json
response.csv
amplifier-response.csv
chain-decomposition.csv
amplitude-response.csv
uncertainty-draft.json
calibration-build-manifest.json
SHA256SUMS
```

### 退出条件

- [x] 训练模型可由原始证据完全重建。
- [x] `response.csv`、身份和SHA已经冻结。
- [x] 冻结发生在任何保留点分析之前。

## 12. M6：独立保留点验收

### 保留频率

```text
15 / 75 / 150 / 250 / 350 / 425 / 485 kHz
```

每点使用 `100 mVpp`，保存一次RTM双通道采集和至少64个完整FPGA帧。验证脚本只能读取M5冻结产物，不得重新拟合或修改锚点。

### 主要门槛

| 指标 | 工程目标 | 硬门槛 |
|---|---:|---:|
| 单音幅值绝对误差 | `≤3 mV` | `≤5 mV` |
| 基频绝对误差 | `≤500 Hz` | `≤1 kHz` |
| 新增输入等效假谱线 | `<1 mVpeak` | 不得形成有效误判 |
| 帧完整性 | 零错误 | CRC/几何/OTR/FIFO/drop任一错误即失败 |

### 失败纪律

- 保留点失败后不得把它追加到训练集并继续使用同一个profile ID；
- 先判断是仪器窗口、前级非线性、ADC/FIR、插值模型还是时间窗问题；
- 若必须调整训练锚点或算法，则生成新的fit版本、新profile ID和新的保留划分。

### 退出条件

- [x] `holdout-report.json` 和最终不确定度结果已生成。
- [x] 全部7个保留点满足5 mV硬门槛。
- [x] 全部保留点满足3 mV工程目标；最大幅值/频率误差为 `0.321 mV / 234.99 Hz`。

## 13. M7：ESP32-P4本地逐频补偿实现

### 补偿位置

P4保持当前处理顺序：

```text
code → 上游516 µV/code标量 → 去直流 → FFT → 峰选择
→ 频率精修 → project_at_frequency()
→ P4逐频幅值补偿
→ 谱线/RMS/Vpp/1P/3P/频谱显示
```

对每条确认的有效带谱线：

```text
K(f) = Snew(f) / incoming_scale_uV_per_lsb
Acorrected(f) = Ascalar(f) × K(f)
```

### 必须保持的行为

- 峰检测、候选排序和SNR门槛继续使用补偿前标量数据；
- 正式谱线与显示谱线使用校正后的峰值；
- `RMS = sqrt(sum(Acorrected_i² / 2))`；
- Vpp和1P/3P使用校正幅值与当前测得相位重构；
- 频谱图在10～500 kHz内使用同一插值，带外保持未补偿诊断值；
- 不改变FPGA、CSLP字段、接收状态机、采集门槛或频率精修算法。

### Fail-closed身份门禁

只有上游六项身份全部精确匹配时启用P4表。任何一项变化：

- 不套用旧表；
- 记录明确的profile mismatch；
- 不把未校准值标成已补偿结果；
- 不影响网络连接状态卡对链路/有效帧的既有判断。

### 验证

- 分段线性插值边界、锚点和区间外负例；
- 所有身份字段逐项错配负例；
- 单音、多音、弱基波、最高谱线非基波和相位wrap；
- 校正后RMS/Vpp与独立Python模型一致；
- 1 MHz以上分量不被逐频表放大；
- 主机 `-Werror + ASan/UBSan`；
- ESP-IDF 6.0.2正式构建与 `git diff --check`。

### 退出条件

- [x] 主机正例和负例全部PASS。
- [x] 正式P4构建通过，未引入FPGA或协议改动。
- [x] 生成资产可由冻结 `response.csv` 自动再生，未手工维护第二份数字。

## 14. M8：P4烧录与真实逐频回归

### 工作项

- 构建无Display-only、截图、fault和诊断夹具的正式P4镜像；
- 审计peer仍为 `.2`、编译优化和本地测试片段状态；
- 烧录bootloader、partition、app并执行写后校验；
- 采集UART，确认启动自检、身份门禁、session和首个有效帧；
- 用10、100、500 kHz以及7个保留点做真实链路复验；
- Python从FPGA镜像帧计算新表结果，与P4串口输出逐项比较。

### 退出条件

- [x] 正式镜像写后校验通过；最终应用BIN与Flash全量读回SHA256均为 `d819641d…7007`。
- [x] 10/100/500 kHz和7个保留点均满足硬门槛；500 kHz略越界精修已钳位查询且保留实测显示频率。
- [x] P4日志明确记录上游ID和本地response profile ID `C5DCDE41`。
- [x] FPGA工作树和板上镜像未发生变化。

## 15. M9：多音、干扰、LVGL与最终收口

### 最终用例

- `u_a`低边界与200 kHz频带边界；
- `u_b`低边界与500 kHz频带边界；
- 至少一条固定为 `5 mVpeak`，且基波不是最高谱线；
- 66.7 kHz基波及H3/H5人工基准；
- 一组高crest factor和一组低crest factor；
- `u_b + 1 MHz / 200 mVpp`干扰基准，验证带外不补偿；
- TIME、FFT、1P、3P视图以及最多8条谱线显示。

### 对比来源

```text
DG/ARB manifest理论值
    ↕
RTM CH2逐谱线结果（只作输出侧旁证；CH1未接）
    ↕
FPGA被动镜像 + Python新表分析
    ↕
P4 UART measurement
    ↕
LVGL最终显示
```

### 收口产物

```text
README.md
calibration.json
response.csv
amplifier-response.csv
chain-decomposition.csv
uncertainty.json
holdout-report.json
p4-acceptance-report.json
calibration-build-manifest.json
SHA256SUMS
```

### 最终恢复

- DG：`SIN / 100 kHz / 50 mVpp / 50 Ω / 0 V / OFF`并回读；
- P4：保持正式补偿镜像；
- FPGA：确认版本和哈希与开始前一致；
- 电脑：退出镜像、串口和WaveBench后台进程；
- 未通过项进入 `tool-of-rei/已知问题.md`，不能藏在临时日志里。

### 退出条件

- [x] 多音谱线、RMS、Vpp和F0满足赛题硬门槛；合并20例最大Vpp/RMS/F0/线频/线幅误差为 `1.983 mV / 0.554 mV / 0.08 Hz / 0.25 Hz / 0.805 mVpk`。
- [x] 1 MHz干扰未被补偿表逆向放大；干扰前后Vpp变化仅 `0.0385 mV`。
- [ ] LVGL人工检查无裁切、旧值冒充LIVE或单位错误。
- [x] 最终审计报告20/20 PASS，所有证据SHA可复核。

## 16. 时间与执行批次建议

正式采集共计：

```text
1个零输入点
3个低幅安全点
24个逐频主扫点
9个正式幅度/弱线补充点
7个独立保留点
= 44个M2～M6正式采集事务

另有20个P4 M8/M9最终逐频、多音与干扰验收案例。
```

建议拆成四个可独立恢复的批次：

1. M2：预检、零点和低幅门禁；
2. M3：升频/降频主扫；
3. M4～M6：幅度点、冻结模型和保留点；
4. M7～M9：P4实现、烧录和最终验收。

每个批次结束都恢复DG为安全OFF并生成批次SHA。没有失败重测时，预计仪器采集约45～75分钟，离线拟合与审计约20～40分钟，P4实现、构建、烧录和最终验收约45～90分钟。

## 17. 审核时需要重点看的决定

- [x] 接受DG 50 Ω设置值作为唯一正式幅值参考；
- [x] 接受100 mVpp作为主扫幅度；
- [x] 保留450 mVpp历史工程压缩证据，但排除出正式范围；
- [x] 接受12个训练锚点和7个独立保留点；
- [x] 接受幅度依赖超过1%时停止、而不是上二维补偿；
- [x] 接受本轮只做幅值补偿、记录但不上线模拟相位补偿；
- [x] 接受P4双层校准身份，并让FPGA永久保持不变；
- [x] 接受3 mV为工程目标、5 mV为硬门槛。

上述决定均已批准并执行。450 mVpp压缩负证据没有被塞回模型；正式范围修订为 `≤250 mVpp` 后，M5～M9继续完成。用户后续实测最大不失真边界约 `380 mVpp`，最终1 MHz干扰案例总包络约 `265.081 mVpp`并通过。当前只剩最终镜像的LVGL人工按键/面板烟测，不再扩展P4算法范围。
