Scaxlibur/CycleScope/docs/evidence/README.md

# 可版本化证据摘要

这里是给 Git、合并审查和报告引用的轻量证据副本。所有副本均来自 tool-of-rei/evidence/ 的原始归档；复制后已进行逐文件比较。原始档案不在本目录，不应删除或用这些摘要替代。

| 目录 | 内容 | 原始根/边界 |
|---|---|---|
| 最终标定摘要/ | calibration、响应 CSV、holdout、补偿资产清单、范围修订和不确定度摘要。 | 对应 final-calibration-20260801_145546+0800/ 的正式 v2 子目录；普通输入上限为 250 mVpp。 |
| M8M9最终审计摘要/ | 20/20 最终审计 JSON 与其原始根 SHA 清单副本。 | 对应 final-p4-release-audit-20260801_190121+0800/；绑定旧应用 BIN d819641d…d8207007。 |
| M12验收摘要/ | DG→FPGA→LAN→P4 工程验收总审计。 | 对应 tool-of-rei/evidence/m12-final-completion-audit.json 与引用子包；不是模拟前端最终标定。 |
| F0显示版构建烧录证明/ | 当前 F0 两位小数镜像的启动日志、发布记录与摘要校验清单。 | 对应 final-p4-f0-display-20260801_192900+0800/；仅证明构建/烧录/100 帧烟测，不替代 20 例审计。 |

## 校验方法

在仓库根目录运行：

    sha256sum -c docs/evidence/F0显示版构建烧录证明/SHA256SUMS

其他 JSON/CSV 摘要的原始身份由 docs/测试与证据索引.md 和 docs/验收证据索引.md 中列出的原始根 SHA256SUMS 约束。恢复外部归档后，应在各原始根目录验证其自己的清单。
