Scaxlibur/CycleScope/docs/evidence/F0显示版构建烧录证明/README.md

# F0 显示版构建烧录证明

这是当前 F0 两位小数显示补丁的轻量发布记录，不包含应用 BIN、ELF 或完整构建目录。

| 文件 | 含义 |
|---|---|
| release-record.json | 工作树身份、改动范围、构建参数、三段烧录校验、会话和 100 帧烟测。 |
| startup.log | 板上启动日志副本；确认 P4 response、Profile、会话、LIVE 和 completed=100。 |
| 原始归档SHA256SUMS.txt | 本机原始归档中 BIN、ELF、配置、布局和日志的哈希清单副本。清单中的多数文件不在此目录。 |
| SHA256SUMS | 校验本目录实际提交的四个说明/摘要文件；清单本身不对自己做递归校验。 |

原始归档根为 tool-of-rei/evidence/final-p4-f0-display-20260801_192900+0800/。它与完整 M8/M9 20 例审计使用不同应用 BIN；未在新 BIN 上重跑全矩阵前，不得将本记录升级为完整发布审计。
