Scaxlibur/CycleScope/docs/测试与证据索引.md

# CycleScope 测试与证据索引

更新：2026-08-02
目的：把测量数据、运行数据、回放源、镜像身份和其适用范围放到同一入口。原始档案保留，历史流水保留；本文件不改写任何已哈希的原始记录。

## 先看这一条

[轻量证据摘要](evidence/README.md)只包含可版本化的副本。完整原始档案当前为 `3,413,342,059 B`（约 3.3 GB），位于 `tool-of-rei/evidence/` 的本机/外部归档中；真实 FPGA 回放源为 `264,897,911 B`（约 256 MiB），位于 `source_data_for_test/`。后者现有 124 个点级归档、124 份 `wire.pcap`；2026-08-02 已按历史记录精确恢复全部 manifest，并复核 620 条 SHA256SUMS。

因此，摘要用于快速审查，原始根与 SHA256SUMS 用于复核。不要用一个摘要 JSON 替代 pcap、波形、串口日志或烧录读回。

## 建议审查顺序

1. 阅读本文件和 [轻量证据摘要](evidence/README.md)，确定要回答的问题属于哪一类证据。
2. 对模拟链量值与补偿，先看“最终标定”，再看独立 holdout。
3. 对 P4 最终测量结论，使用“最终 M8/M9 审计”；它是唯一 20 例最终审计入口。
4. 对当前 F0 两位小数显示镜像，只使用“F0 显示版构建烧录证明”，并遵守其未重跑全矩阵的边界。
5. 对 DG→FPGA→LAN→P4 工程联调，使用 M12；不要把 M12 冒充为完整模拟前端标定。

## 正式与辅助证据

| 等级 | 证明什么 | 可提交摘要 | 原始归档根 | 不能证明什么 |
|---|---|---|---|---|
| 正式：最终标定 | 不超过 250 mVpp 的模拟链逐频响应、冻结补偿资产与 7 点独立 holdout。Profile 为 C5DCDE41。 | [最终标定摘要](https://github.com/Scaxlibur/CycleScope/tree/main/docs/evidence/最终标定摘要) | `tool-of-rei/evidence/final-calibration-20260801_145546+0800/` | 450 mVpp 的连续工作范围；该类点已明确排除。 |
| 正式：最终 M8/M9 审计 | P4 20/20 真实测量案例通过，最大 F0/Vpp/RMS/谱线频率/谱线幅值误差为 0.08 Hz、1.983 mV、0.554 mV、0.25 Hz、0.805 mVpk。 | [M8/M9 最终审计摘要](https://github.com/Scaxlibur/CycleScope/tree/main/docs/evidence/M8M9最终审计摘要) | `tool-of-rei/evidence/final-p4-release-audit-20260801_190121+0800/` | 后续 F0 显示格式镜像的完整 20 例物理复测。此审计绑定旧 BIN `d819641d…d8207007`。 |
| 正式：M12 工程验收 | DG4202 → FPGA → LAN → P4 的 60 个观测点、掩码/阶次/相位/干扰矩阵和 P4 结果。 | [M12 验收摘要](https://github.com/Scaxlibur/CycleScope/tree/main/docs/evidence/M12验收摘要) | `tool-of-rei/evidence/m12-final-completion-audit.json` 及引用的 `m12-live-*` 子包 | 完整模拟前端逐频标定，或新镜像的发布审计。 |
| 发布补充：F0 显示版 | F0 以 0.01 Hz 显示的 fresh build、三段烧录哈希校验、真实 FPGA 会话、首帧 LIVE 和 100 帧启动/链路烟测。 | [F0 显示版构建烧录证明](evidence/F0显示版构建烧录证明/README.md) | `tool-of-rei/evidence/final-p4-f0-display-20260801_192900+0800/` | 新镜像的完整 M8/M9 20 例物理矩阵。 |
| 正式：FPGA 冻结基线 | FPGA 的 M8/M10/M11/M12/M14、真实前端、LAN 长稳、双目的地 UDP 和 QSPI 冷启动。 | [FPGA验收证据索引](FPGA验收证据索引.md) | tool-of-rei/evidence/ 中对应 FPGA 根，以及 source_data_for_test/ 的 124 个回放点 | P4 当前 F0 显示镜像的完整物理复测，或 P4 C5DCDE41 频响资产。 |
| 回放输入 | 真实 FPGA 网络包的离线/隔离网络重放输入，含点级 manifest 和 pcap 校验。 | [回放源说明](https://github.com/Scaxlibur/CycleScope/blob/main/source_data_for_test/README.md) | `source_data_for_test/` | P4 最终测量输出或模拟前端真值。 |
| 历史 UI 调试 | LVGL 截图与相机采集用于早期显示诊断。 | tool-of-rei/screenshots/README.md | tool-of-rei/screenshots/ | 最终视觉验收；两张 LVGL PNG 相同，且有一个 0 字节相机失败产物。 |

## 关键身份与哈希

| 项目 | 值 |
|---|---|
| 最终 M8/M9 审计 JSON SHA-256 | abe9ce8ccf2b6bb3f8368a942cd98d7fd3fec29f91f4524243e1669c08c71a7d |
| 最终 M8/M9 应用 BIN | d819641d…d8207007，应用大小 0x114e10 |
| 当前 F0 显示 BIN SHA-256 | e30d16c4f207c5f1049ae5ab7be2c0135ac5694764dac84d04f22a0baa4bac0e |
| 当前 F0 显示 ELF SHA-256 | e23e0ca90f54507bdffcc0daafefbe4fc84e9dabc9fb98d3151a1746a416d946 |
| F0 版启动日志 SHA-256 | e7b8c21dc1eb999a24bde296771fa1778839b7b8ae2931f8acbc0e8b7bf7cfd9 |
| 频响 Profile | C5DCDE41；标定档案的十进制表示为 3319586369 |

## 原始证据的保存与校验

1. 原始根有 SHA256SUMS 时，在该根目录运行 sha256sum -c SHA256SUMS。
2. 不要移动、重命名或编辑已清单化的原始 JSON、日志、BIN、ELF、pcap、npy 或截图。
3. 需要外部备份时，保留整个证据根及层级；M12 还必须连同其引用的 m12-live-* 子包备份。
4. F0 显示版的版本化记录位于 `docs/evidence/F0显示版构建烧录证明/release-record.json`；该目录中的 SHA256SUMS 只校验版本化摘要，不会假装校验未随 Git 提交的 BIN/ELF。

更详细的证据根、历史负例和相邻 FPGA 工作树对照见 [验收证据索引.md](验收证据索引.md)。
