Scaxlibur/CycleScope/docs/项目交接资料索引.md

# CycleScope 项目交接资料索引

本页面向项目维护、复现和答辩交接，目标是在不依赖历史聊天或本机临时日志的情况下找到当前事实、操作入口和证据边界。完整分类见[文档首页](README.md)。

## 推荐阅读顺序

1. 从根目录 [README](https://github.com/Scaxlibur/CycleScope#readme) 了解项目用途、系统数据流和当前限制。
2. 阅读[文档规则](文档规则.md)，区分 Current、Historical、工程联调和发布审计。
3. 在[测试与证据索引](测试与证据索引.md)确认当前范围、Profile、BIN 和每组证据能证明的内容。
4. 阅读 [G 题采样与处理 Profile](协议与接口/CSLP-G题采样与处理-Profile-v0.1.md)、[采集与分析架构](concepts/G题采集与分析架构.md)和 [CSLP UDP 协议](协议与接口/CSLP-UDP-通信协议-v0.1.md)，分别理解固定参数、设计原因与线上合同。
5. 需要复现时，按[安全构建与上板](getting-started/安全构建与上板.md)先完成离线验证和构建。

## 按问题查找

| 需要回答的问题 | 首选入口 |
| --- | --- |
| 当前正式范围、标定和 P4 构建身份是什么 | [测试与证据索引](测试与证据索引.md) |
| 一项 PASS 能证明什么，不能证明什么 | [测试与证据索引](测试与证据索引.md) |
| 原始证据根、哈希和历史负例在哪里 | [验收证据索引](验收证据索引.md) |
| FPGA 冻结基线与 QSPI 证据在哪里 | [FPGA 验收证据索引](FPGA验收证据索引.md) |
| 固定采样参数和电压语义是什么 | [G 题采样与处理 Profile](协议与接口/CSLP-G题采样与处理-Profile-v0.1.md) |
| 线上报文、会话和错误恢复如何工作 | [CSLP UDP 协议](协议与接口/CSLP-UDP-通信协议-v0.1.md) |
| 如何构建、dry-run 和上板 | [安全构建与上板](getting-started/安全构建与上板.md) |
| 如何联调两块板 | [FPGA 与 ESP32-P4 联调](how-to/FPGA与ESP32-P4联调.md) |
| 原 Profile 的实施、性能和未决事项在哪里 | [Profile v0.1 实施与验收记录](history/CSLP-G题-Profile-v0.1-实施与验收记录.md) |
| 最终竞赛报告在哪里 | [设计报告交付目录](https://github.com/Scaxlibur/CycleScope/blob/main/final_doc/README.md) |

## 当前与历史的边界

- 当前量化结论只从测试与证据索引进入，不在本页复制 BIN、误差或点数。
- `docs/evidence/` 是随 Git 保存的轻量摘要，不是原始仪器、LAN、UART 或镜像档案。
- `tool-of-rei/evidence/` 与 `source_data_for_test/` 的原始内容通常不随普通 clone 携带；若本机存在，仍须先核验对应 `SHA256SUMS`。
- 赛题、答疑和厂商资料是来源原件；M11/M12 旧计划、早期报告和诊断记录属于 Historical。
- 旧 `public/` 路径已经退出当前结构，不应为兼容旧说明重新创建。

## 接手检查单

- 运行 `git status --short --branch`，确认当前分支和未提交改动。
- 通过 Git tag、证据索引和构建哈希确认目标身份，不用文件名或 `main` 猜测发布状态。
- 修改协议、Profile、构建或标定说明前，先定位[文档规则](文档规则.md)中的权威来源。
- 不移动、重命名或编辑带 `SHA256SUMS`、manifest 或冻结身份的原始证据。
- 文档改动完成后运行仓库文档检查和 `git diff --check`；真实硬件操作另行取得授权。
