Scaxlibur/CycleScope/docs/development/文档工作流.md

# 文档工作流

CycleScope 文档与代码一起版本控制。页面职责、事实来源、状态和证据不可变边界以[文档规则](../文档规则.md)为准；本页只说明日常检查顺序。

## 本地检查

在仓库根目录运行：

```bash
python -m unittest -v tests/test_docs_tools.py
python scripts/audit_docs.py
python scripts/check_report_sync.py
python scripts/lint_chinese_docs.py
mkdocs build --strict
git diff --check
```

各命令的职责：

| 命令 | 结果级别 | 检查内容 |
| --- | --- | --- |
| `tests/test_docs_tools.py` | 阻断 | 检查器自身的链接、锚点、H1、孤儿、报告哈希和文案过滤逻辑 |
| `audit_docs.py` 的 error | 阻断 | 相对链接缺失或逃出仓库 |
| `audit_docs.py` 的 warning | 提示 | 锚点、H1、孤儿页和超长页面，交由维护者判断 |
| `check_report_sync.py` | 阻断 | 报告身份标记、旧 `public/` 路径和 Markdown→HTML 源哈希漂移 |
| `lint_chinese_docs.py` | 提示 | 作者维护页面中的弯引号、第二人称和少量术语大小写 |
| `mkdocs build --strict` | 阻断 | 站点导航、内部链接、主题配置和页面构建 |
| `git diff --check` | 阻断 | 空白错误和冲突标记 |

中文检查只扫描维护型 Markdown，并在检查前去掉 fenced code、行内代码、链接目标和 HTML 标签。它不扫描厂商资料、赛题原件、主办方答疑或 `docs/evidence/`；也不把谐波 `H5` 改写为 HTML5。当前结果只作 warning，不阻断提交。

## 报告同步

`final_doc/设计报告.md` 是正文源，HTML 是独立排版的派生预览。修改报告时：

1. 同步修改 Markdown 与 HTML 的对应内容。
2. 检查 250/450 mVpp、M12、M8/M9 和 F0 镜像身份仍与版本化证据一致。
3. 运行 `python scripts/check_report_sync.py --update` 更新 HTML 中的源 SHA-256。
4. 再运行 `python scripts/check_report_sync.py`；只有该检查通过才算同步完成。

`--update` 只表示已人工同步，不会自动把 Markdown 转换为 A4 HTML，也不能替代浏览器排版检查。

## 修改顺序

1. 从 Git diff 判断受影响领域，定位该领域的权威代码、Profile 或证据。
2. 更新唯一权威页面；其他 Landing、Concept 或 How-to 只更新摘要和链接。
3. 对移动或拆分先建立目标页，再更新入链，最后处理旧入口。
4. 运行上述机械检查。
5. 只评审本次修改页面、直接导航和关联事实源；发现系统性重复时才扩大审计范围。

文档检查默认不连接仪器、不打开串口、不发送网络包，也不执行 JTAG 或 Flash。示例命令涉及硬件时，必须明确 dry-run 与真实操作的边界。

## 站点预览

```bash
python -m pip install -r requirements-docs.txt
mkdocs serve
mkdocs build --strict
```

站点只导航当前维护型页面和明确标注的历史记录。赛题、答疑、厂商资料与机器证据继续保留在仓库中，但不进入站点构建。当前 CI 只严格构建站点，不自动发布。
