Scaxlibur/CycleScope/docs/AD9226_2CH模块使用手册_V1.0/images/4a70e70bc63c9d11334d6d712822d8a35ba5ac61a3aa5ceec361f19f144b8334.jpg

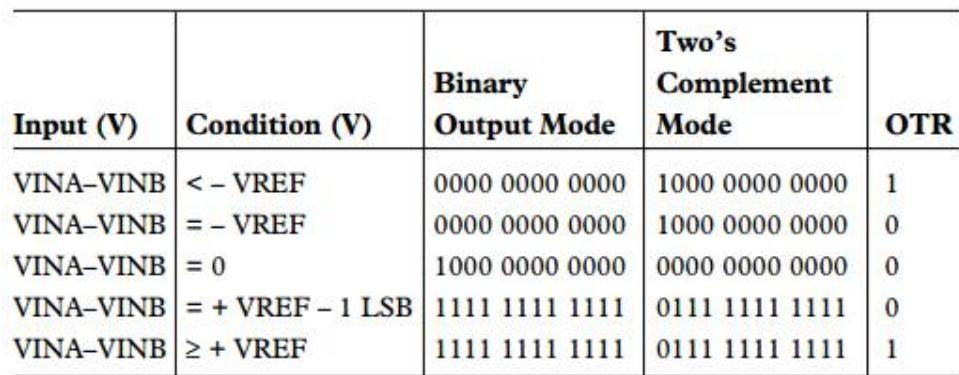
docs/AD9226_2CH模块使用手册_V1.0/images/4a70e70bc63c9d11334d6d712822d8a35ba5ac61a3aa5ceec361f19f144b8334.jpg
