Scaxlibur/CycleScope/docs/AD9226_2CH模块使用手册_V1.0/images/9e7353974485714fa4f8082db11b383ce920c9cb3790196c9367a9b8a7bdc737.jpg

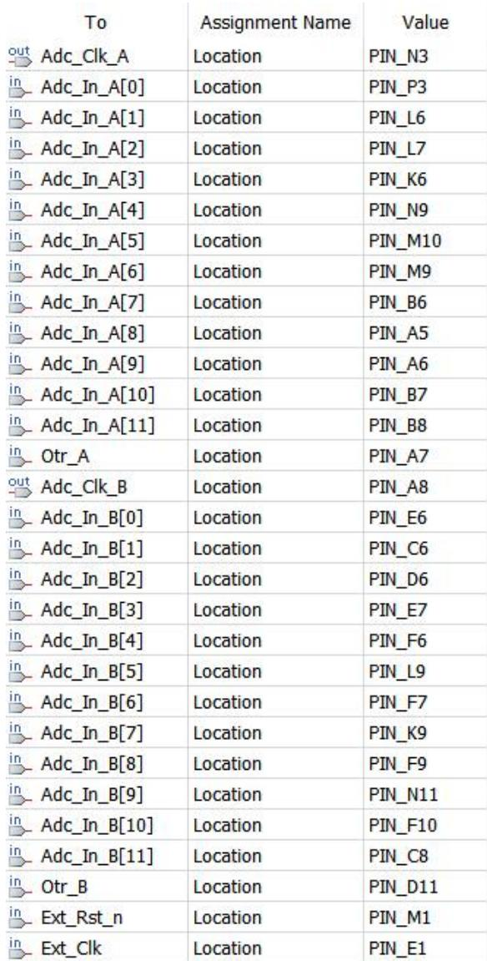
docs/AD9226_2CH模块使用手册_V1.0/images/9e7353974485714fa4f8082db11b383ce920c9cb3790196c9367a9b8a7bdc737.jpg
