Scaxlibur/CycleScope/docs/AD9226_2CH模块使用手册_V1.0/images/b2ead472cbb18705966117218cda495acb2ce46e70e3a7dc1a14bd35d17849fc.jpg

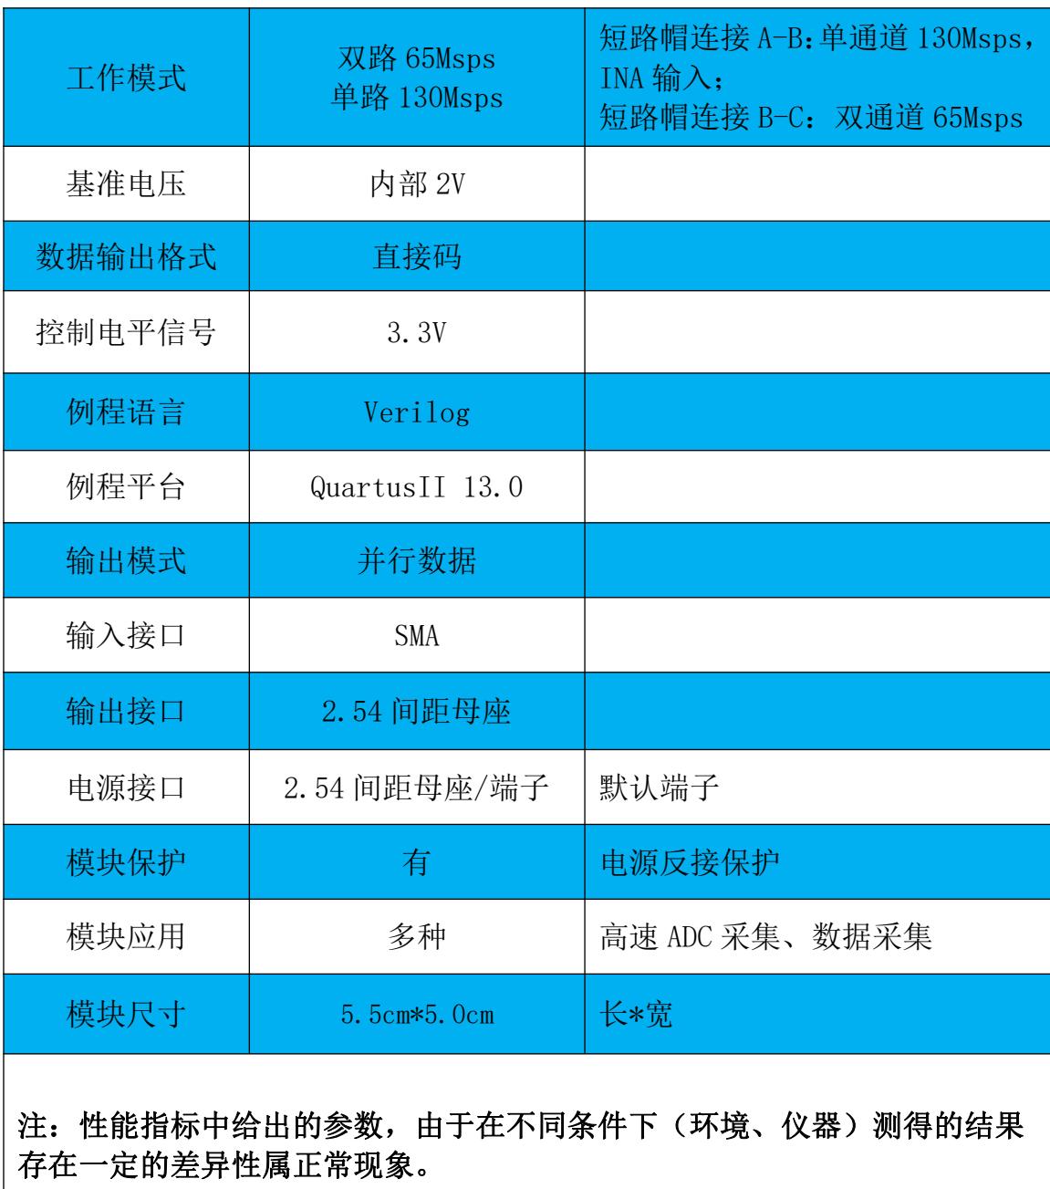
docs/AD9226_2CH模块使用手册_V1.0/images/b2ead472cbb18705966117218cda495acb2ce46e70e3a7dc1a14bd35d17849fc.jpg
