Scaxlibur/CycleScope/docs/AD9226_2CH模块使用手册_V1.0/images/cf306989c20fa0740036e515497bf4f293734ac9735e6da8682af6313cdf5e7d.jpg

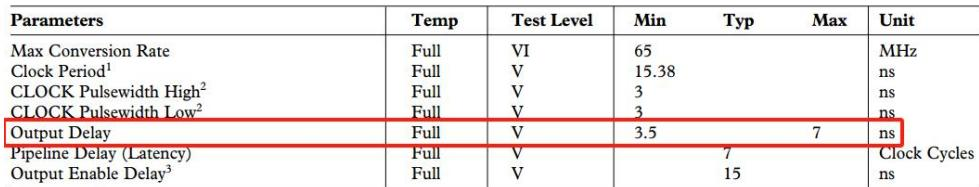
docs/AD9226_2CH模块使用手册_V1.0/images/cf306989c20fa0740036e515497bf4f293734ac9735e6da8682af6313cdf5e7d.jpg
