Scaxlibur/CycleScope/docs/AD9226_2CH模块使用手册_V1.0/images/d8193baa53586df96d2347e26acb4bb41572af8c9d0c71a00968cd73f335b488.jpg

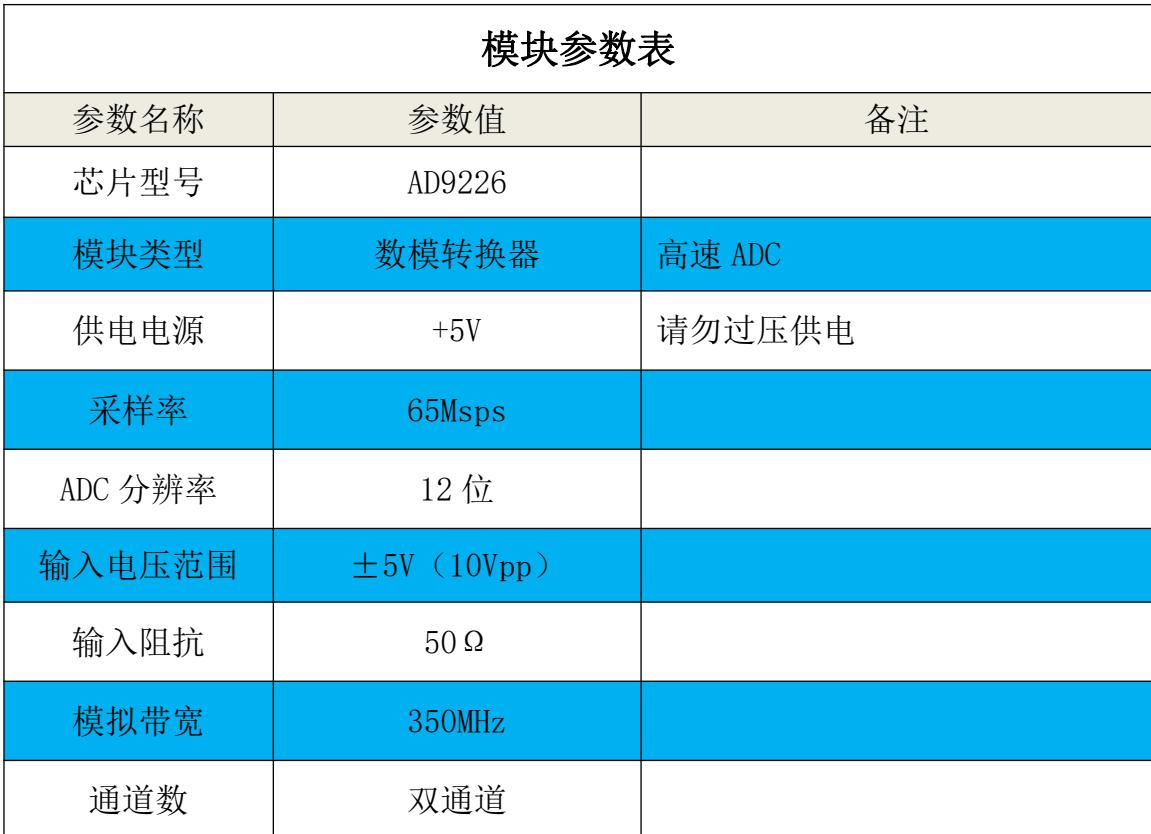
docs/AD9226_2CH模块使用手册_V1.0/images/d8193baa53586df96d2347e26acb4bb41572af8c9d0c71a00968cd73f335b488.jpg
