Scaxlibur/CycleScope/docs/G题_周期信号测量分析装置/images/3f20157ad8e209e711a0896514247c98f031f337501494661cc9c4187ce8af03.jpg

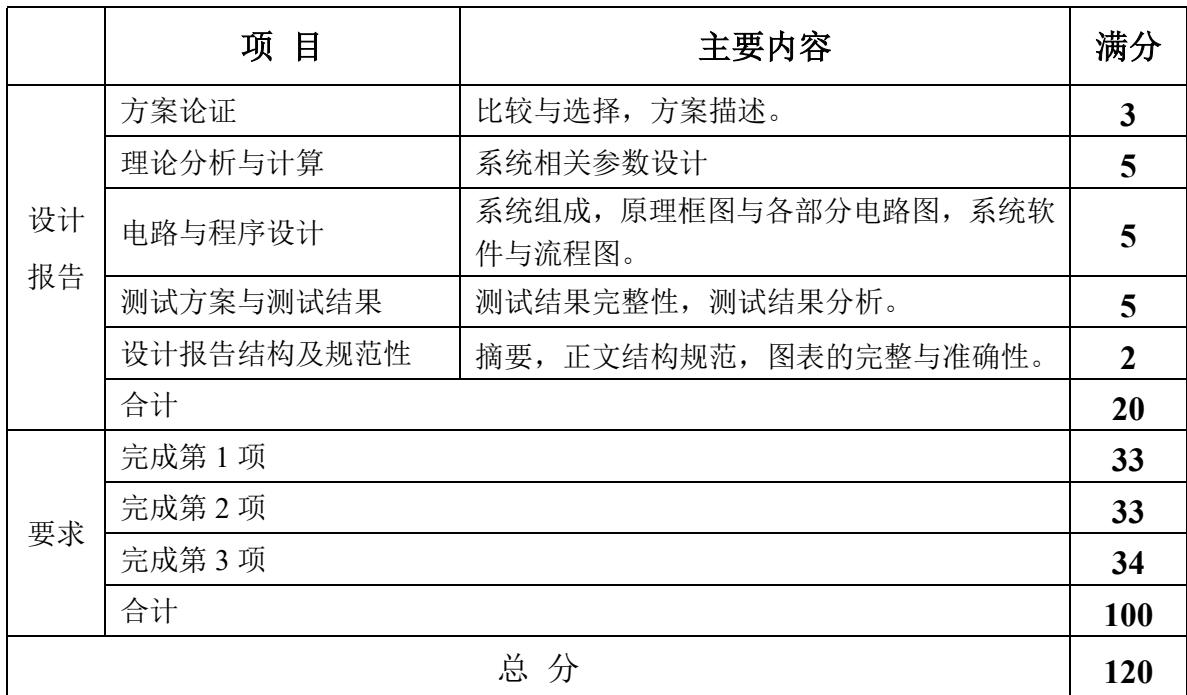
docs/G题_周期信号测量分析装置/images/3f20157ad8e209e711a0896514247c98f031f337501494661cc9c4187ce8af03.jpg
