Scaxlibur/CycleScope/tool-of-rei/fpga-history/四件套/任务清单.md

# 任务清单

## Now

- [ ] 等待用户在确认范围后提交/合并；FPGA 不再新增功能或生成新的构建物。

## Next

- [ ] 与主工程合并时保留各自 `tool-of-rei/` 本地档案，不用忽略规则覆盖对方驾驶舱。
- [ ] 由用户完成最终实物 UI／按键到面板刷新不超过 2 秒的取证；该项属于整机验收，不重写 FPGA 基线。

## Backlog

- [ ] 任何采样、滤波、帧长、校准或传输路径变更都必须新建版本、重新构建并建立独立证据链；不得修改或借用 `038e981` 的结论。

## Done

- [x] 固定唯一 FPGA 发布基线为 `fpga-v1.0.0@038e981`，线上 Profile 为单通道 8192 点、4.0625 MS/s、50 ms、12 个 WAVE 分片。
- [x] 清除后续实验的源码、构建物、原始包和计划引用；保留 M8/M10/M11/M12/M14 及其完整性清单。
- [x] M14 已证明该最终基线的 PS+PL QSPI 掉电冷启动。
- [x] 反向扫描没有留下后续实验标识；M8/M12/M14 根清单和 M11 的校准、动态范围、阻带、多音、组合、上限、长稳、矩阵摘要均通过 SHA-256 复核。
