Scaxlibur/CycleScope/tool-of-rei/fpga-history/开发里程碑.md

# FPGA 开发里程碑与最终冻结

## 最终架构

```text
AD9226 通道 A @ 65 MSPS
  → 低通 + 16 倍抽取 @ 4.0625 MS/s
  → 8192 点 S16 双 bank
  → AXI-Stream → S2MM DMA → PS → CSLP/UDP over LAN
```

唯一最终版本为签名 tag `fpga-v1.0.0@038e981`。固定线上 Profile 为 8192 点、50 ms、12 个 WAVE 分片；P4 是唯一控制端，电脑只可作为被动镜像接收者。

## 已完成里程碑

| 里程碑 | 完成内容 | 证据入口 |
|---|---|---|
| M8 | 真实 ADC LAN 10,001 帧长稳、checksum 与无 IP 分片。 | `evidence/m8-lan-longrun-20260731/` |
| M10 | 采样时序、DMA、测试源、故障注入及真实 ADC LAN 基线。 | `evidence/m10-lan-selftest-20260731/` |
| M11 | 真实前端动态范围、标定、FIR 阻带、多音、组合干扰、上限和长稳。 | `evidence/m11-real-frontend-20260731/` |
| M12 | PS 主发与电脑被动镜像的双目的地 UDP。 | `evidence/m12-dual-destination-20260801/` |
| M14 | 最终 tag 的 PS+PL QSPI 写入和掉电冷启动。 | `evidence/m14-qspi-persistent-20260801/` |

## 发布纪律

1. 不修改 `038e981` 的源码、构建身份或已哈希原始证据。
2. 任何后续设计改动必须使用新版本名、新 bit/XSA/ELF、明确的校准身份和独立验收根。
3. 合并时提交共享索引和必要源码；大型原始数据维持外部/本地只读归档，并随根 `SHA256SUMS` 备份。
