Scaxlibur/CycleScope/tool-of-rei/fpga-history/四件套/已知问题.md

# 已知问题

## 高风险

- 问题：ADC 的 MODE/DFS、模拟极性与 OTR 的完整端到端方向基准尚未用直流阶跃或正向斜坡单独冻结。
  - 影响：可能造成符号、零点或过量程解释偏差。
  - 规避方式：后续若要宣称绝对相位或修改 ADC 接口，必须先做独立方向基准试验并建立新证据。
  - 状态：不影响当前固定 Profile 的频率/幅值验收范围；仍不可外推为绝对相位证明。

- 问题：ADC forwarded-clock 的完整板外延迟、位间 skew 与 ACK 往返模型尚未形成全相位眼图级闭环。
  - 影响：现有实现后 STA 与 raw-IOB 实测不能替代完整板级时序模型。
  - 规避方式：保持已验证的 210°采样相位；若更换线缆、模块或时钟方案，重新建立输入延迟和实测证据。
  - 状态：当前 tag 的稳定运行证据有效，模型完整性仍为后续硬件变更门槛。

## 中低风险

- 问题：最终 P4 完整 20 例审计和随后 F0 显示构建的二进制身份不同。
  - 影响：F0 烧录/100 帧烟测不等同于完整审计。
  - 规避方式：发布说明必须分别写明 `d819641d…d8207007` 的 20 例审计与 `e30d16c4…a4bac0e` 的范围受限构建；详见主工程证据索引。
  - 状态：已在跨工程索引中明确，不影响 FPGA tag 身份。

- 问题：真实触摸按键到最终 panel flush 的 2 秒整机体验尚缺人工取证。
  - 影响：自动 LAN/FFT/数值审计不能代替现场视觉验收。
  - 规避方式：系统完全启动、会话建立且持续分析后，逐项录制 TIME、FFT、1P、3P 的操作与刷新时刻。
  - 状态：待最终实物验收。
