Scaxlibur/CycleScope/tool-of-rei/fpga-history/四件套/项目快照.md

# 项目快照

## 恢复卡片

- 当前分支：`codex/FPGA`
- 当前目标：以 `fpga-v1.0.0@038e981` 作为唯一 FPGA 最终版本，准备与主工程合并。
- 当前状态：源码已与 tag 一致；最终可掉电恢复镜像由 M14 证明；后续实验材料已从项目目录移除。
- 下一步：等待用户提交/合并；不要新增 FPGA 功能。
- 最近验证：M8/M10/M11/M12/M14 根保留，最终 tag 为 `038e981b018dd201334bf31e4157a56ba6a0862c`。M8/M12/M14 完整清单及 M11 的核心分层清单均通过 SHA-256 复核，Markdown 本地链接有效。
- 不要碰：QSPI/MIO47、已哈希原始证据、`source_data` 与正式校准资产；没有新版本和新验收，不改 FPGA 源码。
- 最近一次更新时间：2026-08-02

## 冻结架构

```text
AD9226 通道 A，65 MSPS
  → 码型归一化、三级 FIR、16 倍抽取
  → 4.0625 MS/s、8192 点 S16、50 ms 投递
  → PL 双 bank / AXI-Stream / Simple S2MM DMA
  → Zynq PS / CSLP v0.1 / UDP
  → ESP32-P4 为唯一控制端；电脑镜像仅为可选被动诊断
```

比赛数据路径只认 `PL → DMA → PS → CSLP/UDP`。tag 中的 SPI 诊断实现是历史代码，不能作为比赛接口、默认验收入口或 LAN 故障旁路。

## 关键证据根

| 根目录 | 结论 |
|---|---|
| `evidence/m8-lan-longrun-20260731/` | 10,001 帧真实 ADC LAN 长稳。 |
| `evidence/m10-lan-selftest-20260731/` | 时序、DMA、故障注入和真实 ADC LAN 基线。 |
| `evidence/m11-real-frontend-20260731/` | 前端、标定、FIR 阻带、多音、干扰和长稳。 |
| `evidence/m12-dual-destination-20260801/` | P4 主链与电脑被动镜像逐字节一致。 |
| `evidence/m14-qspi-persistent-20260801/` | `038e981` 的 QSPI 写入和掉电冷启动。 |

详细可追溯入口见 [../docs/验收证据索引.md](../docs/验收证据索引.md)。原始数据不可改写；只允许在索引中补充新的独立说明。
