Scaxlibur/CycleScope/Zynq_7010_PL/scripts/analyze_adc_raw.py

#!/usr/bin/env python3
"""Fail-closed analysis for CycleScope raw-IOB ILA captures."""

from __future__ import annotations

import argparse
import csv
import hashlib
import itertools
import json
import math
import re
from dataclasses import dataclass
from pathlib import Path
from typing import Any, Iterable

import numpy as np


SAMPLE_RATE_HZ = 65_000_000.0
ADC_BITS = 12
ADC_MASK = (1 << ADC_BITS) - 1
MIN_CAPTURE_SAMPLES = 1_024
MIN_BIT_STATE_COUNT = 64
MIN_R_SQUARED = 0.995
MAX_NRMSE_FRACTION = 0.02
MIN_RUNNER_UP_NRMSE_RATIO = 1.5
MAX_OUTLIER_RATE = 0.001
MAX_CATASTROPHIC_OUTLIER_COUNT = 0
MAX_RESIDUAL_STEP_CODES = 16.0
MAX_CYCLE_REPEATABILITY_CODES = 8.0
MIN_ORDER_COMPARISON_ACCURACY = 0.99
ORDER_COMPARISON_LAGS = (1, 2, 4, 8, 16, 32, 64)
MIN_REFERENCE_DELTA = 1e-3
MAX_TRIANGLE_CODE_STEP_PER_SAMPLE = 2.5
SUPPORTED_SAMPLE_PHASES = (
    0,
    30,
    60,
    90,
    120,
    150,
    180,
    210,
    240,
    270,
    300,
    330,
    345,
    348,
    351,
    354,
)


class AnalysisError(RuntimeError):
    """Raised when evidence is malformed or cannot be interpreted safely."""


@dataclass(frozen=True)
class RawCapture:
    indices: np.ndarray
    words: np.ndarray
    otr: np.ndarray
    data_column: str
    otr_column: str


@dataclass(frozen=True)
class DataSlice:
    column: int
    logical_bits: tuple[int, ...]


def sha256_file(path: Path) -> str:
    digest = hashlib.sha256()
    with path.open("rb") as stream:
        for chunk in iter(lambda: stream.read(1024 * 1024), b""):
            digest.update(chunk)
    return digest.hexdigest()


def _normalized_header(value: str) -> str:
    return re.sub(r"\s+", " ", value.strip()).lower()


def _parse_data_slice(value: str, column: int) -> DataSlice | None:
    register_match = re.search(
        r"(?:^|/)adc_data_a_iob_reg\[([0-9]+)\](?:_[0-9]+)?(?:\[0:0\])?$",
        value,
    )
    if register_match:
        logical_bit = int(register_match.group(1))
        if not 0 <= logical_bit < ADC_BITS:
            raise AnalysisError(
                f"ADC register slice names out-of-range bit {logical_bit}"
            )
        return DataSlice(column=column, logical_bits=(logical_bit,))

    for signal_name in ("adc_data_a_iob", "probe0"):
        match = re.search(
            rf"(?:^|/){signal_name}(?:\[([0-9]+)(?::([0-9]+))?\])?$",
            value,
        )
        if not match:
            continue
        if match.group(1) is None:
            return DataSlice(column=column, logical_bits=tuple(range(ADC_BITS)))
        most_significant = int(match.group(1))
        least_significant = (
            most_significant if match.group(2) is None else int(match.group(2))
        )
        if (
            not 0 <= least_significant < ADC_BITS
            or not 0 <= most_significant < ADC_BITS
        ):
            raise AnalysisError(
                f"ADC data slice [{most_significant}:{least_significant}] is out of range"
            )
        if most_significant < least_significant:
            raise AnalysisError(
                f"ascending ADC data slice [{most_significant}:{least_significant}] "
                "is unsupported"
            )
        return DataSlice(
            column=column,
            logical_bits=tuple(range(least_significant, most_significant + 1)),
        )
    return None


def _find_header(
    rows: list[list[str]],
) -> tuple[int, int, int, list[DataSlice]]:
    for row_index, row in enumerate(rows):
        normalized = [_normalized_header(value) for value in row]
        index_candidates = [
            index
            for index, value in enumerate(normalized)
            if value == "sample_index" or "sample in buffer" in value
        ]
        otr_candidates = [
            index
            for index, value in enumerate(normalized)
            if "adc_otr_a_iob" in value
            or re.search(r"(?:^|/)probe1(?:\[0\])?$", value)
        ]
        if len(index_candidates) != 1 or len(otr_candidates) != 1:
            continue
        data_slices = [
            data_slice
            for column, value in enumerate(normalized)
            if (data_slice := _parse_data_slice(value, column)) is not None
        ]
        if not data_slices:
            continue
        bit_sources: dict[int, int] = {}
        for data_slice in data_slices:
            for logical_bit in data_slice.logical_bits:
                if logical_bit in bit_sources:
                    raise AnalysisError(
                        f"ADC data bit {logical_bit} overlaps columns "
                        f"{bit_sources[logical_bit]} and {data_slice.column}"
                    )
                bit_sources[logical_bit] = data_slice.column
        missing_bits = sorted(set(range(ADC_BITS)) - set(bit_sources))
        if missing_bits:
            raise AnalysisError(f"ADC data slices are missing bits {missing_bits}")
        return (
            row_index,
            index_candidates[0],
            otr_candidates[0],
            data_slices,
        )
    raise AnalysisError(
        "cannot find one sample index, complete non-overlapping ADC data slices, "
        "and one probe1/OTR column"
    )


def _radix_for_column(rows: list[list[str]], header_row: int, column: int) -> str | None:
    del header_row  # Vivado versions place the Radix row before or after header.
    found: set[str] = set()
    for row in rows:
        if (
            not row
            or not _normalized_header(row[0]).startswith("radix")
            or column >= len(row)
        ):
            continue
        value = row[column].strip().upper()
        if value in {"HEX", "BIN", "BINARY", "UNSIGNED", "DEC", "DECIMAL"}:
            found.add(value)
    if len(found) > 1:
        raise AnalysisError(
            f"ILA CSV has conflicting radix declarations for column {column}: "
            f"{sorted(found)}"
        )
    return next(iter(found), None)


def _parse_integer(token: str, *, radix: str | None, width: int, label: str) -> int:
    value = token.strip().replace("_", "")
    if not value or re.search(r"[xXzZ?]", value):
        raise AnalysisError(f"{label} contains an empty/unknown value: {token!r}")
    try:
        # An explicit Vivado Radix row is authoritative. In particular, a
        # hexadecimal word such as 0B2 is data, not a Python-style 0b prefix.
        if radix == "HEX":
            parsed = int(value, 16)
        elif radix in {"BIN", "BINARY"}:
            parsed = int(value, 2)
        elif radix in {"UNSIGNED", "DEC", "DECIMAL"}:
            parsed = int(value, 10)
        elif value.lower().startswith("0x"):
            parsed = int(value, 16)
        elif value.lower().startswith("0b"):
            parsed = int(value, 2)
        else:
            parsed = int(value, 10)
    except ValueError as exc:
        raise AnalysisError(f"{label} is not a valid integer: {token!r}") from exc
    if parsed < 0 or parsed >= (1 << width):
        raise AnalysisError(f"{label} is outside {width}-bit range: {parsed}")
    return parsed


def read_ila_csv(path: Path) -> RawCapture:
    with path.open("r", encoding="utf-8-sig", newline="") as stream:
        rows = list(csv.reader(stream))
    if not rows:
        raise AnalysisError("ILA CSV is empty")

    header_row, index_column, otr_column, data_slices = _find_header(rows)
    header = rows[header_row]
    max_column = max(
        [index_column, otr_column]
        + [data_slice.column for data_slice in data_slices]
    )
    otr_radix = _radix_for_column(rows, header_row, otr_column)
    data_radices = [
        _radix_for_column(rows, header_row, data_slice.column)
        for data_slice in data_slices
    ]

    indices: list[int] = []
    words: list[int] = []
    otr_values: list[int] = []
    for line_number, row in enumerate(rows[header_row + 1 :], start=header_row + 2):
        if not row or all(not value.strip() for value in row):
            continue
        if _normalized_header(row[0]).startswith("radix"):
            continue
        if len(row) <= max_column:
            raise AnalysisError(f"ILA CSV row {line_number} has too few columns")
        try:
            sample_index = int(row[index_column].strip(), 10)
        except ValueError as exc:
            raise AnalysisError(
                f"ILA CSV row {line_number} has invalid sample index: {row[index_column]!r}"
            ) from exc

        word = 0
        for data_slice, radix in zip(data_slices, data_radices, strict=True):
            slice_value = _parse_integer(
                row[data_slice.column],
                radix=radix,
                width=len(data_slice.logical_bits),
                label=f"row {line_number} ADC slice {header[data_slice.column]!r}",
            )
            for slice_bit, logical_bit in enumerate(data_slice.logical_bits):
                word |= ((slice_value >> slice_bit) & 1) << logical_bit
        otr = _parse_integer(
            row[otr_column],
            radix=otr_radix,
            width=1,
            label=f"row {line_number} OTR",
        )
        indices.append(sample_index)
        words.append(word)
        otr_values.append(otr)

    if len(indices) < MIN_CAPTURE_SAMPLES:
        raise AnalysisError(
            f"ILA CSV has {len(indices)} samples; at least {MIN_CAPTURE_SAMPLES} required"
        )
    index_array = np.asarray(indices, dtype=np.int64)
    if np.any(np.diff(index_array) != 1):
        raise AnalysisError("ILA sample indices are not strictly consecutive")
    return RawCapture(
        indices=index_array,
        words=np.asarray(words, dtype=np.uint16),
        otr=np.asarray(otr_values, dtype=np.uint8),
        data_column=" + ".join(header[item.column] for item in data_slices),
        otr_column=header[otr_column],
    )


def candidate_mappings(
    inferred_mapping: tuple[int, ...] | None = None,
) -> list[tuple[str, tuple[int, ...]]]:
    identity = tuple(range(ADC_BITS))
    candidates: dict[tuple[int, ...], str] = {identity: "identity"}
    reverse = tuple(reversed(identity))
    candidates[reverse] = "full_reverse"

    pairs = list(itertools.combinations(range(ADC_BITS), 2))
    for first, second in pairs:
        mapping = list(identity)
        mapping[first], mapping[second] = mapping[second], mapping[first]
        candidates.setdefault(tuple(mapping), f"swap_{first}_{second}")

    for pair_index, (a, b) in enumerate(pairs):
        for c, d in pairs[pair_index + 1 :]:
            if len({a, b, c, d}) != 4:
                continue
            mapping = list(identity)
            mapping[a], mapping[b] = mapping[b], mapping[a]
            mapping[c], mapping[d] = mapping[d], mapping[c]
            candidates.setdefault(tuple(mapping), f"swap_{a}_{b}__{c}_{d}")

    for start in range(ADC_BITS):
        for stop in range(start + 2, ADC_BITS + 1):
            mapping = list(identity)
            mapping[start:stop] = reversed(mapping[start:stop])
            candidates.setdefault(tuple(mapping), f"reverse_{start}_{stop - 1}")

    if inferred_mapping is not None:
        if len(inferred_mapping) != ADC_BITS or set(inferred_mapping) != set(identity):
            raise AnalysisError("inferred ADC mapping is not a 12-bit permutation")
        candidates.setdefault(inferred_mapping, "inferred_arbitrary_permutation")
        # Keep the existing runner-up gate meaningful even when the inferred
        # mapping is far from the identity-oriented diagnostic candidates.
        for first, second in itertools.combinations(range(ADC_BITS), 2):
            mapping = list(inferred_mapping)
            mapping[first], mapping[second] = mapping[second], mapping[first]
            candidates.setdefault(
                tuple(mapping),
                f"inferred_neighbor_swap_{first}_{second}",
            )
    return [(name, mapping) for mapping, name in candidates.items()]


def _fundamental_reference(
    words: np.ndarray,
    *,
    stimulus: str,
    frequency_hz: float,
    sample_rate_hz: float,
) -> tuple[np.ndarray, float, int]:
    """Build a mapping-independent analog-order reference from raw bit planes."""

    sample_count = int(words.size)
    angles = (
        2.0
        * math.pi
        * frequency_hz
        * np.arange(sample_count, dtype=np.float64)
        / sample_rate_hz
    )
    bits = ((words[:, None] >> np.arange(ADC_BITS)) & 1).astype(np.float64)
    basis = np.column_stack(
        (np.ones(sample_count), np.sin(angles), np.cos(angles))
    )
    coefficients = np.linalg.pinv(basis) @ bits
    amplitudes = np.hypot(coefficients[1], coefficients[2])
    anchor_bit = int(np.argmax(amplitudes))
    anchor_amplitude = float(amplitudes[anchor_bit])
    if not math.isfinite(anchor_amplitude) or anchor_amplitude <= 1e-9:
        raise AnalysisError("raw capture has no usable stimulus fundamental")
    phase = math.atan2(
        float(coefficients[2, anchor_bit]),
        float(coefficients[1, anchor_bit]),
    )
    if stimulus == "sine":
        reference = np.sin(angles + phase)
    elif stimulus == "triangle":
        reference = (2.0 / math.pi) * np.arcsin(np.sin(angles + phase))
    else:
        raise AnalysisError(f"unsupported stimulus {stimulus!r}")
    return reference, phase, anchor_bit
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
