Scaxlibur/CycleScope/Zynq_7010_PS/cyclescope_cslp/tests/test_adc_analyze.py

from contextlib import redirect_stderr, redirect_stdout
import hashlib
import importlib.util
from io import StringIO
import json
from pathlib import Path
import sys
from tempfile import TemporaryDirectory
from types import SimpleNamespace
import unittest


MODULE_PATH = Path(__file__).parents[1] / "tools" / "cslp_adc_analyze.py"
SPEC = importlib.util.spec_from_file_location("cslp_adc_analyze", MODULE_PATH)
analyze = importlib.util.module_from_spec(SPEC)
assert SPEC.loader is not None
sys.modules[SPEC.name] = analyze
SPEC.loader.exec_module(analyze)


@unittest.skipIf(analyze.np is None, "WaveBench NumPy environment is not active")
class AdcAnalysisTests(unittest.TestCase):
    def test_basic_metrics_promotes_int16_before_square(self):
        values = analyze.np.asarray((-30_000, 30_000), dtype="<i2")
        metrics = analyze.basic_metrics(values)
        self.assertEqual(metrics["rms_total"], 30_000.0)
        self.assertEqual(metrics["rms_ac"], 30_000.0)

    def write_capture(self, root, frames):
        capture = root / "adc"
        capture.mkdir()
        records = []
        for index, values in enumerate(frames):
            raw = analyze.np.asarray(values, dtype="<i2").tobytes()
            name = f"frame_{index:05d}_{index + 1:08x}.s16le"
            (capture / name).write_bytes(raw)
            records.append(
                {
                    "frame_index": index,
                    "frame_id": index + 1,
                    "timestamp_us": 1_000_000 + index * 50_000,
                    "file": name,
                    "frame_bytes": len(raw),
                    "sample_count": analyze.FRAME_SAMPLES,
                    "sample_rate_hz": analyze.SAMPLE_RATE_HZ,
                    "scale_uv_per_lsb": 488,
                    "offset_uv": 0,
                    "config_id": 7,
                    "filter_profile": 1,
                    "calibration_id": 0,
                    "frame_flags": 4,
                    "sha256": hashlib.sha256(raw).hexdigest(),
                }
            )
        manifest = {
            "format": "CycleScope CSLP independent complete frames v1",
            "sample_encoding": "S16_LE",
            "frame_count": len(records),
            "frame_samples": analyze.FRAME_SAMPLES,
            "sample_rate_hz": analyze.SAMPLE_RATE_HZ,
            "source_mode": "real-adc",
            "activity_policy": "require",
            "overrange_policy": "reject",
            "session_id": 9,
            "device_boot_id": 10,
            "config_id": 7,
            "frames": records,
            "partial": False,
        }
        (capture / "capture.json").write_text(json.dumps(manifest), encoding="utf-8")
        return capture
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
