Scaxlibur/CycleScope/(commit log)

2026-07-29 feat: bring up esp32-p4 lvgl display
    [partitions.csv]
2026-07-29 feat: pin ui and data tasks to separate cores
2026-07-29 feat(fpga): add AD9226 frontend and decimation filter
2026-07-29 feat(fpga): add frame buffering and SPI diagnostics
2026-07-29 feat(fpga): integrate zynq dma system platform
2026-07-29 feat(fpga): add zynq cslp dma udp application
2026-07-29 feat(esp32-p4): add initial CSLP UDP receiver
2026-07-29 fix(esp32-p4): harden CSLP receiver state
    [cslp_receiver_policy.hpp, cslp_udp_receiver.cpp, cslp_udp_receiver.hpp]
2026-07-29 test(esp32-p4): add configurable CSLP diagnostics
2026-07-29 docs: track merged LVGL and LAN cockpit
2026-07-29 feat(esp32-p4): add 8192-point FFT processing
    Use esp-dsp with Hann compensation, harmonic-family detection, refined amplitude/frequency estimation, local synthetic vectors, and verified Core 1 processing.
2026-07-31 feat(esp32-p4): integrate live analysis and display pipeline
2026-07-31 feat(esp32-p4): add local LVGL screenshot debug channel
2026-08-01 feat(esp32-p4): add adjustable eight-line spectrum view
2026-08-01 feat(esp32-p4): refine production display metrics
    Format FFT-derived measurements in mV/Hz, dynamically scale visible spectrum lines to 80% with mV/div, and remove the LVGL FPS/CPU production overlay.
2026-08-02 feat(esp32-p4): finalize calibrated display and evidence handoff
    [amplifier-response.csv, chain-decomposition.csv, response.csv]
2026-08-02 docs: consolidate project documentation
    [amplifier-response.csv, chain-decomposition.csv, response.csv]
2026-09-04 docs: 重构文档工作流与信息架构
2026-09-04 ci: 指定文档依赖缓存文件
